hugoprigent/FieldMind/hardware/electronics/carte_capteurs/README.en.md

[Français](README.md) · **English**

# FieldMind Sensor Board

The public edition retains revision **A7**, designed on a pad board 40 × 60 mm. Previous revisions remain in the private workspace.

- [KiCad Project A7](cad/perfboard_c5_a7/README.en.md)
- [Build Guide](perfboard_une_plaque_c5_a7.en.md)
- [Recorded Connections](../CONNEXIONS.en.md)
- [ESP / Pi Contract](contrat_esp_pi.en.md)
- [Power and Shutdown](alimentation_arret.en.md)

The pinout has evolved since the A7 study. To wire the current rover, refer to the recorded connections and firmware; do not order a PCB based on the layers of this perfboard study.
