hugoprigent/FieldMind/hardware/electronics/carte_capteurs/README.md

**Français** · [English](README.en.md)

# Carte capteurs FieldMind

L'édition publique conserve la révision **A7**, étudiée sur une plaque à pastilles 40 × 60 mm. Les révisions précédentes restent dans l'espace de travail privé.

- [Projet KiCad A7](cad/perfboard_c5_a7/README.md)
- [Guide de réalisation](perfboard_une_plaque_c5_a7.md)
- [Connexions effectivement relevées](../CONNEXIONS.md)
- [Contrat ESP / Pi](contrat_esp_pi.md)
- [Alimentation et arrêt](alimentation_arret.md)

Le brochage a évolué depuis l'étude A7. Pour câbler le rover courant, les connexions relevées et le firmware font référence ; ne pas commander un PCB à partir des couches de cette étude de perfboard.
