hugoprigent/FieldMind/docs/status-2026-10-23.md

**Français** · [English](status-2026-10-23.en.md)

# État du prototype — 23 octobre 2026

Cette note distingue ce qui a été essayé sur le matériel de ce qui est seulement codé ou simulé.
La publication reste un instantané sélectionné : accès, journaux bruts, configurations privées et
historique du dépôt source n'en font pas partie.

## Rover

- Le rover roule, châssis et électronique visibles ; la coque n'est pas montée.
- Le servo de direction DT996 est hors service. Le rover tourne par le différentiel des roues
  arrière, servo au neutre (`direction.par_l_arriere` dans `config/rover.toml`). Un support SG90 et
  son palonnier sont dessinés ([CAO](../cao/prototype_final/README.md)), sans validation sous charge.
- **Navigation autonome en intérieur, 21 octobre, avec le GX10** : exploration lancée par la
  consigne « explore la pièce », puis trajet autonome aller-retour sur la carte lidar.
- Fonctionnement de l'exploration : le Pi calcule plusieurs prochains points dans l'espace connu,
  le GX10 en choisit un à partir de la carte et des observations, le Pi revalide ce choix, conduit
  et garde la sécurité. Le modèle ne commande pas directement les moteurs.
- Une analyse de scène sur le GX10 a pris environ 6 à 9 s pendant ces essais ; la période visée de
  3 s n'est pas atteinte.
- Mémoire spatiale : un objet doit être revu sur deux analyses visuelles espacées pour être
  confirmé ; le détecteur rapide seul ne confirme pas un repère.

Non validé : mission en extérieur sur l'herbe ([protocole prévu](../software/rover/TEST_TERRAIN_2026-10-22.md)),
taux de faux positifs de la perception, calibration des axes et du biais de la centrale inertielle.

## Remorque porte-drone

La remorque est fabriquée à partir des [pièces imprimables publiées](../cao/prototype_final/remorque/README.md).
Ses deux volets sont commandés par servos depuis l'ESP32-C5 (firmware ROVER_4, sorties D2/D3) ;
le firmware est flashé sur l'ESP du rover. Le logiciel estime l'angle d'attelage par odométrie,
sans capteur, et intègre l'emprise de la remorque dans le superviseur de sécurité.

Non validé : tractage en mission autonome, marche arrière attelée, position réelle des volets (la
commande est temporisée, sans retour de position).

## Drone

Le flux vidéo BLE du drone est reçu sur le Pi et la reconnaissance d'images fonctionne sans vol.
Le niveau de batterie du drone n’est pas encore mesuré de façon fiable : le champ
d'abord lu comme batterie est un identifiant de modèle. Les trames de commande ont été identifiées
par analyse hors ligne de l'application d'origine ; le pilotage réel reste désactivé tant que
neutre, axes, cadence et perte de liaison ne sont pas validés au banc.

**Le vol autonome n'est pas validé.** La mission décollage, tour photo et posé existe seulement en
[simulation](../software/rover/DRONE_MISSION.md).

## GX10

Huit modèles sont servis sur le GB10 du GX10 :

| Rôle | Modèle |
| --- | --- |
| Agent, vision | Qwen3.6-35B-A3B NVFP4 |
| Pointage incarné | RoboBrain 2.5 (4B) |
| Détection | D-FINE |
| Profondeur monoculaire | Depth Anything V2 (métrique) |
| Segmentation | SAM 2.1 |
| Transcription | Qwen3-ASR (1.7B) |
| Synthèse vocale | Qwen3-TTS (0.6B) |
| Empreintes d'images | Qwen3-VL-Embedding (2B) |

État par rôle : [MODELES.md](../software/rover/MODELES.md) ; configuration :
[deploiement/gx10](../software/rover/deploiement/gx10/README.md). Pendant la session ASUS, le GX10
était distant et joint par réseau privé : un déploiement complet hors réseau sur le terrain
n'est pas démontré.

## Simulation publique

<https://hugoprigent.com/fieldmind/> sert le poste web du rover avec un matériel simulé. Le
serveur [`public_demo.py`](../software/rover/fieldmind/public_demo.py) crée un rover simulé par
navigateur et n'initialise aucun pilote matériel. Il utilise le GX10 s'il est joignable, sinon
un autre fournisseur s'il est configuré, sinon fonctionne sans IA. Son déploiement et ses clés
ne sont pas dans ce dépôt. Page du projet : <https://hugoprigent.com/projets/fieldmind>.

## Limites

Une fonction présente dans le code, une simulation réussie ou un appel IA réussi ne valent pas
validation terrain. Les tests du dépôt vérifient les contrats logiciels et la compilation du
firmware ; ils ne couvrent ni la conduite du rover réel, ni le tractage, ni le vol du drone.
Commandes et résultats : [validation.md](validation.md).
