hugoprigent/FieldMind/cao/prototype_final/VISSERIE.md

**Français** · [English](VISSERIE.en.md)

# FieldMind — toute la visserie du prototype final

Mise à jour et recomptage documentaire : **18 octobre 2026**. Quantités
nettes prévues par les plans, **hors marge et hors déduction du stock déjà
possédé** ; ce n'est pas une validation des assemblages physiques.

Rover complet (direction V04, mâts, coque, composants) et remorque porte-drone. Ce document
rassemble les listes de chaque partie :

- [direction V04](../mounts/prototype/direction_v04_servo_traversant/README.md#quincaillerie) ;
- [coque et composants](README.md#visserie) ;
- [remorque](remorque/README.md#visserie-et-achats).

La [liste CSV](VISSERIE.csv) sépare les quantités **rover avec chape** et
**remorque** pour chaque référence, avec les réserves de dimensionnement.
Les anciennes listes de remorque M5/M8/M12 ne s'ajoutent pas à cette
version : l'attelage courant est en **M10×55** et les supports de roue de
la remorque en **M6×16 à tête bombée**. Aucune vis à tête fraisée : pas de
fraisage dans le bois.

| Ensemble | Vis prévues | Inserts M3 |
| --- | ---: | ---: |
| Rover, coque, mâts et chape d'attelage | 126 | 32 |
| Remorque, hors chape déjà comptée sur le rover | 48 | 12 |
| **Total** | **174** | **44** |

Les 174 incluent les **2 vis des webcams au filetage à confirmer** et la
**M3×16 du palonnier dont la longueur doit être contrôlée au montage**.
Les **8 vis moteurs à dimensionner** sont en supplément, hors de ce total.

## Liste par taille : quantités nettes

M3×12 signifie diamètre nominal 3 mm et longueur 12 mm. Les têtes fraisées
sont distinguées des têtes non fraisées ; elles ne sont pas à substituer
sans vérifier l'assemblage. H = tête hexagonale ; CHC = tête cylindrique
à six pans creux.

| Vis | Nombre | Écrous et rondelles |
| --- | ---: | --- |
| M2×4 | 4 | — |
| M2,5×8, tête cylindrique | 4 | 4 rondelles M2,5 |
| M3×6 | 20 | 20 rondelles larges M3 (DIN 9021, Ø9) |
| M3×8 | 32 | 4 écrous M3 (XL4015) ; les autres vissées dans des inserts ou dans le plastique |
| M3×10 | 6 | 6 écrous M3, 6 rondelles M3 (rebords de la remorque) |
| M3×12, tête cylindrique | 16 | 12 écrous M3, 12 rondelles M3 |
| M3×12, tête bombée | 4 | 4 écrous M3, 8 rondelles M3 étroites pour les biellettes |
| M3×16, tête cylindrique | 11 | 10 écrous M3, 10 rondelles M3 (planche de 10 mm) ; 1 rondelle large M3 (palonnier) |
| **M3×16, tête bombée (ISO 7380)** | **14** | 14 écrous M3 |
| M3×20 | 2 | 2 écrous frein M3, 4 rondelles M3 |
| CHC M5×40 | 2 | 2 écrous frein M5, 2 rondelles M5 |
| **M6×16, tête bombée (ISO 7380)** | **8** | 8 écrous M6 |
| **M6×25, tête bombée (ISO 7380)** | **4** | 4 écrous M6 (timon de la remorque) |
| M6×20 | 10 | 10 écrous M6, 10 rondelles M6 (coque ; 4 suffisent) |
| M6×25 | 6 | 6 écrous M6 (colliers des supports moteurs, chape), 2 rondelles M6 |
| M8×16 | 8 | 8 écrous en T M8 pour rainure de 10 |
| H M8×25 | 8 | 8 écrous M8, 8 rondelles M8 (supports de pivot, équerres) |
| H M8×30 | 12 | 12 écrous M8, 16 rondelles M8 (supports moteurs) ; rondelles de 2 mm imprimées (pivots, axes) |
| H M10×55 | 1 | 1 écrou frein M10, 2 rondelles M10 |
| Vis photo 1/4"-20 × 1/2", à confirmer | 2 | — ; M6×12 est une autre hypothèse, pas une référence à ajouter |

## Écrous, rondelles et inserts

Ces quantités sont celles du montage. Ajouter séparément une marge si
souhaité ; aucune marge n'est déjà comprise dans les totaux.

| Quoi | Nombre |
| --- | ---: |
| Vis, toutes tailles | 174 |
| Rondelles M2,5 | 4 |
| Écrous M3 | 50 |
| Écrous frein M3 | 2 |
| Rondelles M3 standard | 32 |
| Rondelles M3 étroites, appui sur bague intérieure des 3×10×4 | 8, ou 8 rondelles imprimées à leur place |
| Rondelles larges M3 (DIN 9021, Ø9) | 21 |
| Inserts à chaud M3 (Ø ext. 4,5 à 4,6 mm, longueur 5,7 mm au plus selon les logements) | 44 |
| Écrous frein M5 + rondelles M5 | 2 + 2 |
| Écrous M6 + rondelles M6 | 28 + 12 |
| Écrou frein M10 + rondelles M10 | 1 + 2 |
| Écrous M8 | 20 |
| Rondelles M8 | 24 |
| Écrous en T M8, rainure de 10 | 8 |

Les **46 rondelles M3 hors larges** se décomposent en 38 standard et
8 étroites. Pour les biellettes, le plan propose des rondelles imprimées
**Ø extérieur 5 mm, Ø intérieur 3,3 mm, épaisseur 0,6 mm** ; une pièce métal
doit respecter l'appui sur la seule bague intérieure. Ne pas commander
8 rondelles supplémentaires si les 8 imprimées sont utilisées.

Les rondelles/entretoises des pivots et des moyeux prévues imprimées dans
les plans restent des pièces à fabriquer, pas des rondelles métalliques
à ajouter à ces quantités.

Les inserts restent seulement là où du plastique se visse dans du plastique : bossages des bandes
de la coque et flasques des pneus. Partout où une pièce imprimée se fixe sur du bois, c'est vis et
écrou.

## Dimensions à confirmer avant achat définitif

- **Fixation des moteurs arrière : 8 vis prévues**, 4 par moteur d'après
  les supports. Les moteurs sont désormais identifiés NGP RM24A/RM18A,
  mais les taraudages, leur profondeur et la fixation réelle sur ces
  supports restent à relever. Les trous Ø4 des supports ne permettent
  pas de choisir M3 ou M4. Ces 8 vis ne sont pas comptées dans les 174.
- **Webcams : 2 vis**, filetage et longueur engagée à confirmer. Le plan
  retient 1/4"-20 × 1/2" ; M6×12 ne convient que si le taraudage est
  réellement M6. Ce sont deux possibilités exclusives.
- **Palonnier du DT996 : 1 vis M3×16 prévue**, diamètre M3 confirmé dans
  le compte rendu V04. Vérifier sa longueur avec l'étoile complètement
  emboîtée : la vis doit serrer l'empilage sans buter au fond de l'axe.
- **Lidar C1 : M2,5×8**, avec au maximum 4 mm de pénétration dans le lidar
  selon le plan constructeur archivé et le support actuel.

Le Pi dans son boîtier, les convertisseurs et les contrôleurs sont posés
à l'adhésif/double-face dans la version actuelle de la coque : aucune
visserie supplémentaire de platine ou d'entretoises n'est définie pour
eux. La carte A7, l'écran et le Knob sont bien inclus dans le tableau.

**Visserie d'origine à réutiliser et à vérifier dans les sachets** :
- vis des oreilles et du palonnier des 2 SG90 de la remorque ;
- vis d'origine du servo de direction : celle de l'étoile est remplacée par la M3×16.

## Détail, partie par partie

### Direction avant V04, mâts et supports

| Vis | Nombre | Où |
| --- | ---: | --- |
| H M8×30 + écrou M8 | 2 | Pivots : vis par-dessous, écrou prisonnier dans le support (frein-filet) |
| H M8×30 + écrou M8 | 2 | Axes des roues avant : écrou prisonnier dans la jambe de la fusée (frein-filet) |
| H M8×25 + écrou + rondelle M8 | 4 | Supports de pivot à travers la planche de 10 mm |
| H M8×30 + écrou + 2 rondelles M8 | 8 | Supports des moteurs arrière, 4 par support, à travers la planche de 10 mm |
| M6×25 + écrou M6 | 4 | Colliers des supports moteurs, 2 par support (écrou dans la quille) |
| H M8×25 + écrou + rondelle M8 | 4 | Équerres des deux mâts sur la planche |
| M8×16 + écrou en T M8 | 8 | 4 pour les équerres sur les profilés, 2 pour la barre stéréo, 2 pour le support du lidar (emboîté sur le profilé de 90) |
| M3×8 + insert M3 | 12 | Flasques des pneus avant, 6 par roue |
| M3×12 tête bombée + 2 rondelles étroites + écrou M3 | 4 | Biellettes de direction |
| M3×16 + écrou + rondelle M3 | 4 | Oreilles du servo de direction, à travers la planche |
| M3×16 + rondelle large M3 | 1 | Vis centrale du palonnier, dans l'axe du servo (frein-filet bleu) |
| M2,5×8 + rondelle | 4 | Lidar C1 sur son support |
| Vis photo 1/4"-20 × 1/2" | 2 | Webcams sur la barre stéréo (M6×12 si le filetage est bien M6) |

### Coque et composants

| Vis | Nombre | Où |
| --- | ---: | --- |
| M3×6 + rondelle large DIN 9021 | 20 | Bandes bleues sur les rebords des flancs, dans 20 inserts M3 |
| M3×12 + écrou + rondelle M3 | 12 | Nervures entre tronçons, 2 par flanc et par coupe |
| M6×20 + rondelle M6 | 10 | Coque sur la planche, par-dessous, dans les écrous M6 glissés dans les fentes (4 aux coins suffisent) |
| M3×16 + rondelle M3, écrou M3 noyé dans le fond du berceau | 4 | Berceau de la batterie (avant gauche), vis par-dessous la planche |
| M3×8 | 4 | Carte A7 sous la bande C3, directement dans le plastique |
| M3×12 | 4 | Modulino Knob sous la bande C3, directement dans le plastique |
| M3×8 + écrou M3 | 4 | Les deux XL4015 sur leur plaque imprimée : vis par le dessus, écrou dans la poche sous la plaque |
| M3×16 + rondelle + écrou M3 | 2 | Plaque des XL4015 sur la planche, à l'avant droit (trous X1 et X2), ou double-face |
| M2×4 | 4 | Écran sous la bande C3, directement dans le plastique |

### Attelage, côté rover

| Vis | Nombre | Où |
| --- | ---: | --- |
| M6×25 + rondelle + écrou M6 | 2 | Chape sous la planche du rover (trous A1 et A2), écrous dans la chape |
| H M10×55 + 2 rondelles + écrou frein M10 | 1 | Vis d'attelage par le dessus, à travers les deux mâchoires et la tête du timon, écrou sous la chape |

### Remorque

| Vis | Nombre | Où |
| --- | ---: | --- |
| M6×16 tête bombée + écrou M6 | 8 | Supports de roue, 4 par support (2 près du bord, 2 vers le milieu), par le dessus, écrou noyé |
| M3×16 tête bombée + écrou M3 | 14 | Par le dessus, écrou noyé : boîtiers des servos (4), blocs arrière (2), ferrures des volets (8) |
| M6×25 tête bombée + écrou M6 | 4 | Timon : par le dessus, à travers la planche, écrou noyé sous le timon |
| M3×10 + rondelle | 6 | Rebords avant et arrière, par-dessous, dans les écrous noyés de la lèvre |
| Écrou M3 | 12 | Noyés dans la lèvre des rebords (pour les 6 M3×30 et les 6 M3×10) |
| M3×20 + 2 rondelles + écrou frein M3 | 2 | Axe arrière de chaque volet |
| M3×8 + insert M3 | 12 | Flasques des pneus de la remorque, 6 par roue, comme à l'avant |
| CHC M5×40 + rondelle + écrou frein M5 | 2 | Axe de chaque roue de la remorque |
