hugoprigent/FieldMind/hardware/electronics/carte_capteurs/exports/c5_a7/plan_broches.html

## Broches par composant (trou vu du dessus)

Réf. | Composant | Face | Broches
J3 | OLED 0,96 I2C | dessus | GND F1 · VCC G1 · SCL H1 · SDA I1
J1 | GY-521 MPU-6050 | dessus | VCC B20 · GND C20 · SCL D20 · SDA E20 · XDA F20 (non câblé) · XCL G20 (non câblé) · AD0 H20 (non câblé) · INT I20 (non câblé)
J2 | GY-BMP280-3.3 | dessus | VCC N18 · GND N17 · SCL N16 · SDA N15 · CSB N14 (non câblé) · SDO N13 (non câblé)
U1 | Seeed XIAO ESP32C5 | dessous | D0 J2 · D1 J3 · D2 J4 · D3 J5 · D4 J6 · D5 J7 · D6 J8 · D7 D8 · D8 D7 · D9 D6 · D10 D5 · 3V3 D4 · GND D3 · 5V D2
J4 | GNSS déporté (câble) | dessus | RX_GPS A12 · GND A11 · VCC A10 · TX_GPS A9
J6 | Extension 5V/3V3/D8-D10 (Dupont) | dessus | 5V A2 · GND A3 · 3V3 A4 · D10 A5 · D9 A6 · D8 A7
J8 | Extension D0-D3 (Dupont) | dessus | D0 N2 · D1 N3 · D2 N4 · D3 N5
J7 | Modulino Knob (I2C, câble) | dessus | GND N7 · 3V3 N8 · SDA N9 · SCL N10
