hugoprigent/FieldMind/cao/prototype_final/exports/support_xl4015_gabarit.pdf

## Support des 2 XL4015 — gabarit à l'échelle 1

Imprimer à 100 % et vérifier la règle de 50 mm. Poser chaque module sur son contour, IN en bas. Ses deux trous doivent tomber sur les croix. Sinon, mesurer A et B (voir en bas) et me les donner.

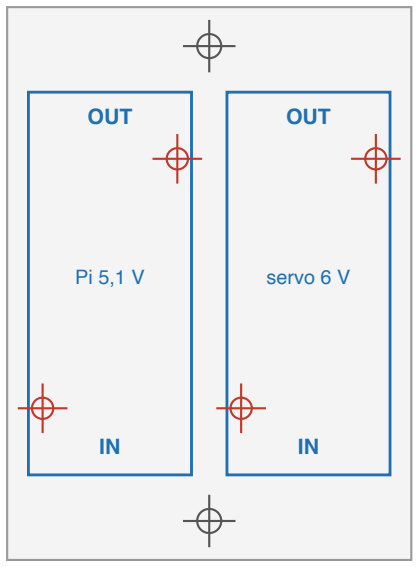
[picture p52: figure]
OUT; servo 6 V

Circuit 23 × 54 mm, 2 trous Ø3 en diagonale :

- trou côté IN : 2 mm du bord gauche, 9,4 mm du bout IN ;
- trou côté OUT : 2 mm du bord droit, 9,4 mm du bout OUT ;
- A = entraxe en longueur : 35,2 mm ; B = entraxe en largeur : 19 mm.
Écart entre les deux circuits : 5 mm. Plots de 3,6 mm ; vis M3×8 par le dessus, écrou M3 dans la poche sous la plaque.

Croix grises : fixation de la plaque sur la planche (vis M3×12 + rondelle + écrou, foret 4 dans la planche).

règle de contrôle : 50 mm
