hugoprigent/FieldMind/cao/prototype_final/plan_percages/plan_percages.pdf

## FieldMind prototype final — perçage de la planche 300 × 500 × 10 mm

Vue de dessus, avant en haut, échelle 1:2,5. Coordonnées en page 2 ; gabarit à l'échelle 1 en pages 3 à 6.
AVANT
P1 | P2 | P3 | P4
M1 | M2 | M3 | M4
M5 | M6 | M7 | M8
S1 | S2
S3 | S4
E1 | E2
E3 | E4
K1 | K2
K3 | K4
K5 | K6
K7 | K8
K9 | K10
B1 | B2
B3 | B4

X1

X2

A1 | C1 | A2

300 mm

500 mm

Profilé 40×40 du lidar

Profilé 40×40 des caméras

Découpe servo 21 × 41,4

P : Ø8,5 — Supports de pivot
M : Ø8,5 — Supports moteurs arrière (4 par support)
S : Ø3,4 — Oreilles du servo (à pointer avec le servo)
E : Ø8,5 — Équerres des profilés (caméras à l'avant, lidar à l'arrière)

K : Ø6,5 — Fixation de la coque (M6)
B : Ø3,5 — Berceau de batterie (avant gauche)
X : Ø3,5 — Plaque des deux XL4015 (avant droit)
C : Ø8 — Passage des câbles des volets de la remorque A : Ø6,5 — Chape d'attelage de la remorque Pointillés : profilés et contour extérieur de la coque

## Coordonnées des trous (mm) — planche vue de dessus, avant en haut

X depuis le bord GAUCHE ; Y depuis le bord AVANT ; X axe = depuis l'axe de la planche (+ à droite).

Trou | Ø | X gauche | Y avant | X axe | Rôle
P1 | 8,5 | 26,0 | 56,0 | -124,0 | Supports de pivot
P2 | 8,5 | 55,0 | 56,0 | -95,0 | Supports de pivot
P3 | 8,5 | 245,0 | 56,0 | +95,0 | Supports de pivot
P4 | 8,5 | 274,0 | 56,0 | +124,0 | Supports de pivot
M1 | 8,5 | 20,0 | 395,0 | -130,0 | Supports moteurs arrière (4 par support)
M2 | 8,5 | 82,0 | 395,0 | -68,0 | Supports moteurs arrière (4 par support)
M3 | 8,5 | 218,0 | 395,0 | +68,0 | Supports moteurs arrière (4 par support)
M4 | 8,5 | 280,0 | 395,0 | +130,0 | Supports moteurs arrière (4 par support)
M5 | 8,5 | 20,0 | 485,0 | -130,0 | Supports moteurs arrière (4 par support)
M6 | 8,5 | 82,0 | 485,0 | -68,0 | Supports moteurs arrière (4 par support)
M7 | 8,5 | 218,0 | 485,0 | +68,0 | Supports moteurs arrière (4 par support)
M8 | 8,5 | 280,0 | 485,0 | +130,0 | Supports moteurs arrière (4 par support)
S1 | 3,4 | 145,0 | 103,5 | -5,0 | Oreilles du servo (à pointer avec le servo)
S2 | 3,4 | 155,0 | 103,5 | +5,0 | Oreilles du servo (à pointer avec le servo)
S3 | 3,4 | 145,0 | 151,5 | -5,0 | Oreilles du servo (à pointer avec le servo)
S4 | 3,4 | 155,0 | 151,5 | +5,0 | Oreilles du servo (à pointer avec le servo)
E1 | 8,5 | 110,0 | 25,0 | -40,0 | Équerres des profilés (caméras à l'avant, lidar à l'arrière)
E2 | 8,5 | 190,0 | 25,0 | +40,0 | Équerres des profilés (caméras à l'avant, lidar à l'arrière)
E3 | 8,5 | 110,0 | 440,0 | -40,0 | Équerres des profilés (caméras à l'avant, lidar à l'arrière)
E4 | 8,5 | 190,0 | 440,0 | +40,0 | Équerres des profilés (caméras à l'avant, lidar à l'arrière)
K1 | 6,5 | 75,0 | 7,4 | -75,0 | Fixation de la coque (M6)
K2 | 6,5 | 225,0 | 7,4 | +75,0 | Fixation de la coque (M6)
K3 | 6,5 | 10,4 | 20,0 | -139,6 | Fixation de la coque (M6)
K4 | 6,5 | 289,6 | 20,0 | +139,6 | Fixation de la coque (M6)
K5 | 6,5 | 10,4 | 160,0 | -139,6 | Fixation de la coque (M6)
K6 | 6,5 | 289,6 | 160,0 | +139,6 | Fixation de la coque (M6)
K7 | 6,5 | 10,4 | 290,0 | -139,6 | Fixation de la coque (M6)
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
