hugoprigent/FieldMind/cao/mounts/prototype/direction_v04_servo_traversant/vues/01_iso_neutre.png

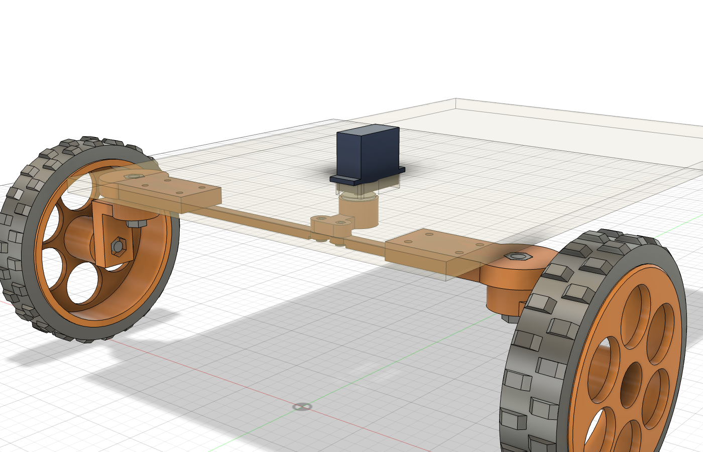
cao/mounts/prototype/direction_v04_servo_traversant/vues/01_iso_neutre.png
