hugoprigent/FieldMind/cao/mounts/prototype/direction_v04_servo_traversant/vues/05_module_droit.png

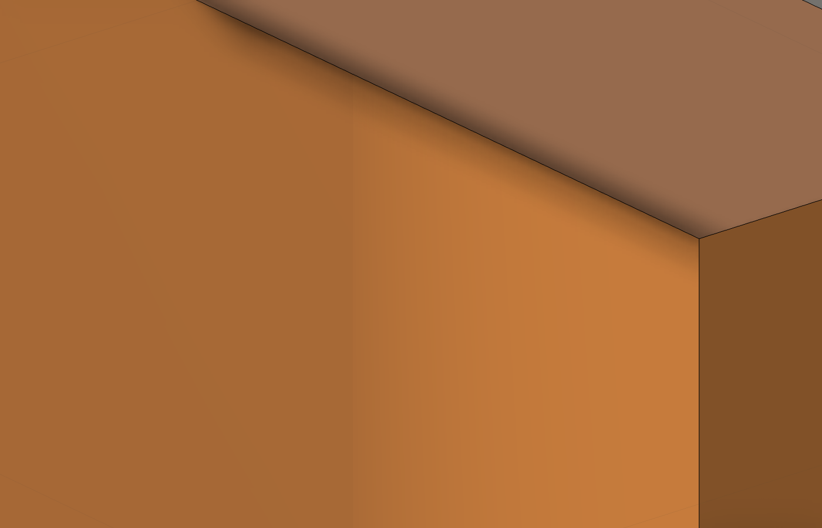
cao/mounts/prototype/direction_v04_servo_traversant/vues/05_module_droit.png
