hugoprigent/FieldMind/cao/mounts/prototype/direction_v04_servo_traversant/vues/07_face_roues.png

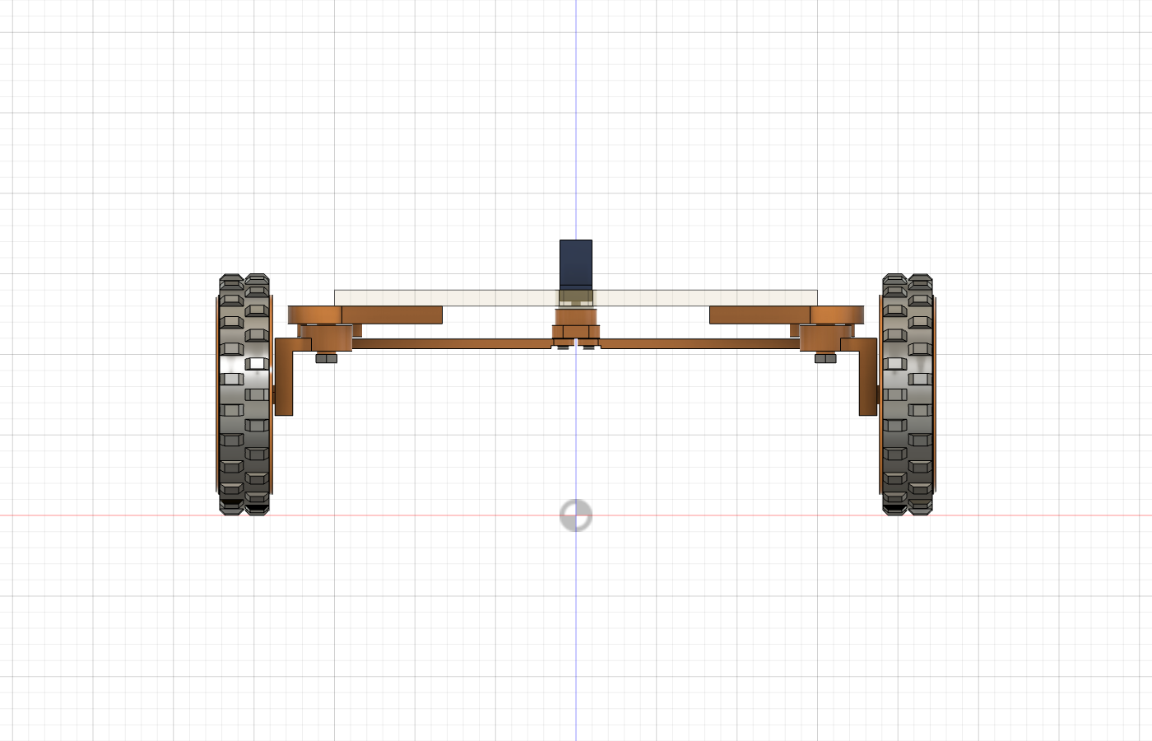
cao/mounts/prototype/direction_v04_servo_traversant/vues/07_face_roues.png
