hugoprigent/FieldMind/cao/mounts/prototype/direction_v04_servo_traversant/vues/08_roue_droite.png

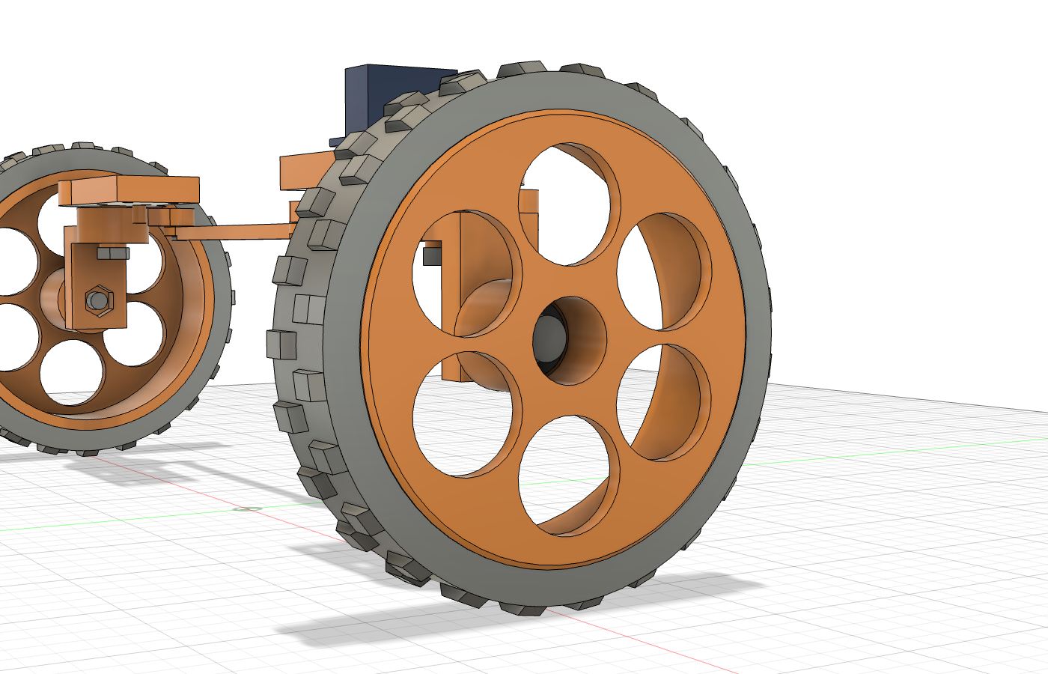
cao/mounts/prototype/direction_v04_servo_traversant/vues/08_roue_droite.png
