hugoprigent/FieldMind/cao/mounts/prototype/direction_v04_servo_traversant/vues/14_support_lidar_dessous.png

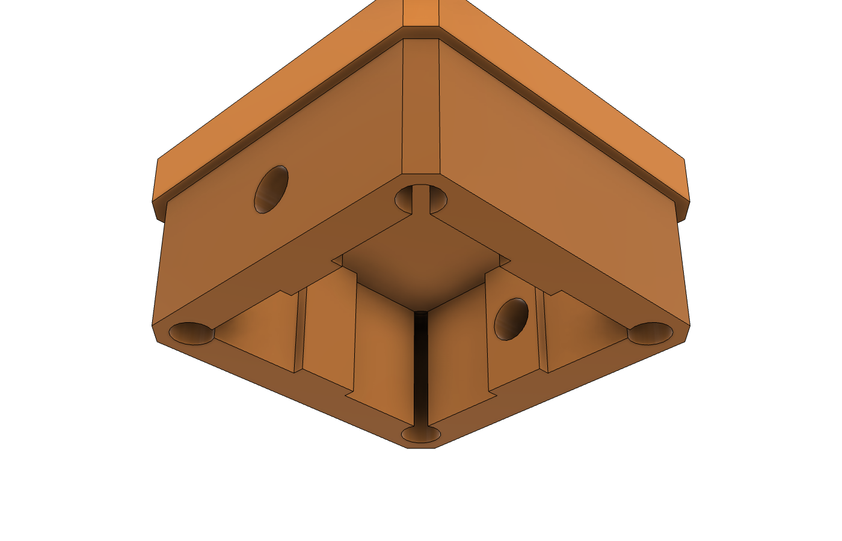
cao/mounts/prototype/direction_v04_servo_traversant/vues/14_support_lidar_dessous.png
