hugoprigent/FieldMind/cao/prototype_final/exports/support_xl4015_gabarit.png

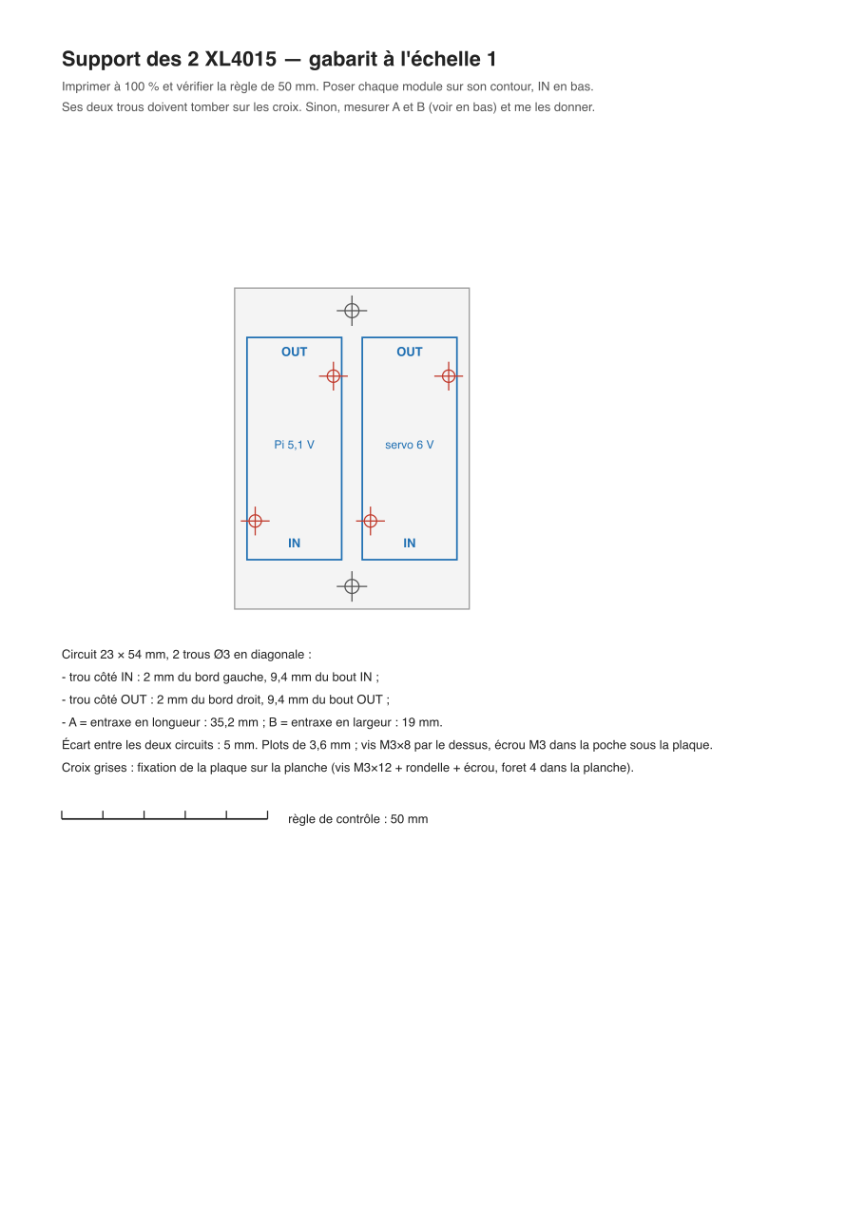
cao/prototype_final/exports/support_xl4015_gabarit.png
