hugoprigent/FieldMind/cao/prototype_final/plans_atelier/page_1_remorque_decoupe.png

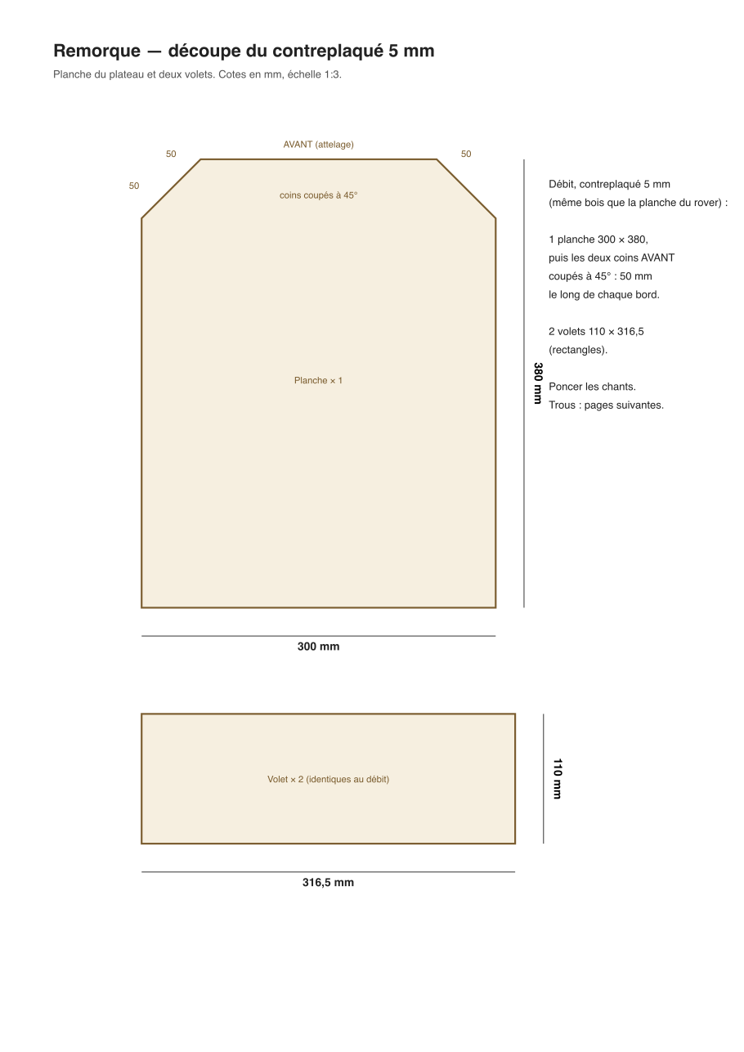
cao/prototype_final/plans_atelier/page_1_remorque_decoupe.png
