hugoprigent/FieldMind/cao/prototype_final/plans_atelier/page_2_remorque_percage.png

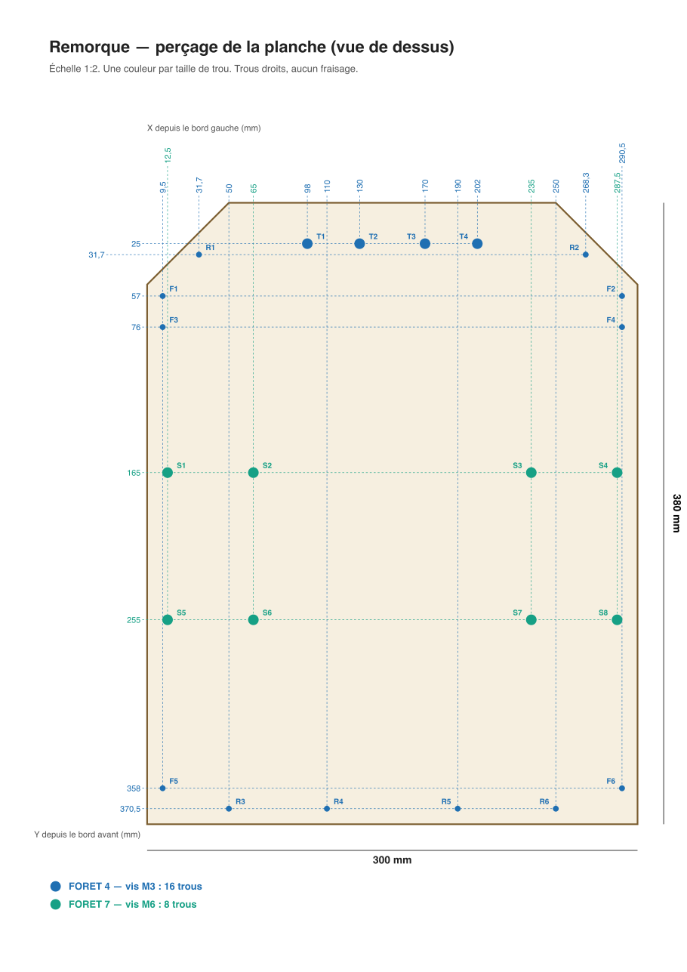
cao/prototype_final/plans_atelier/page_2_remorque_percage.png
