hugoprigent/FieldMind/cao/prototype_final/plans_atelier/page_3_remorque_tableau.png

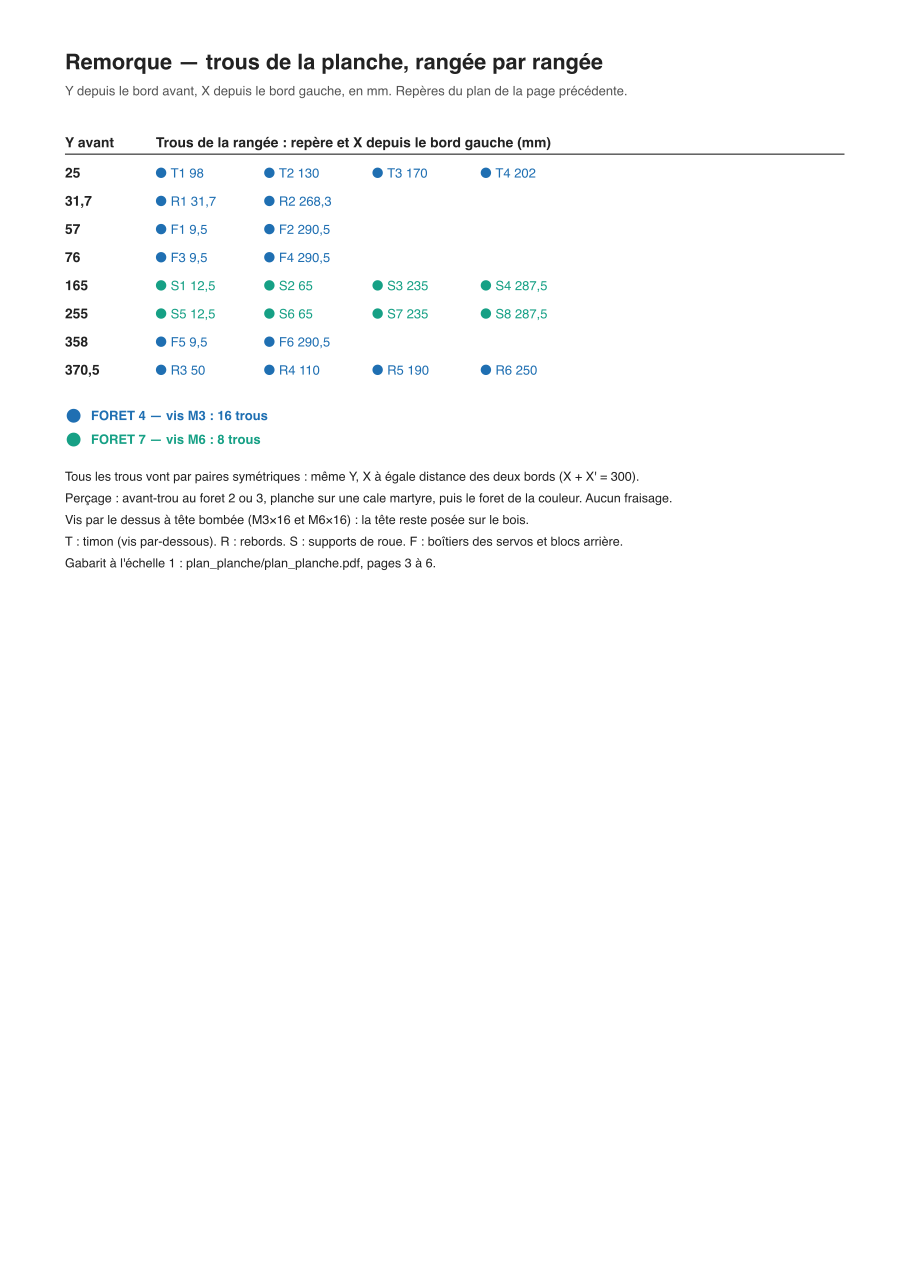
cao/prototype_final/plans_atelier/page_3_remorque_tableau.png
