hugoprigent/FieldMind/cao/prototype_final/plans_atelier/page_4_volets_percage.png

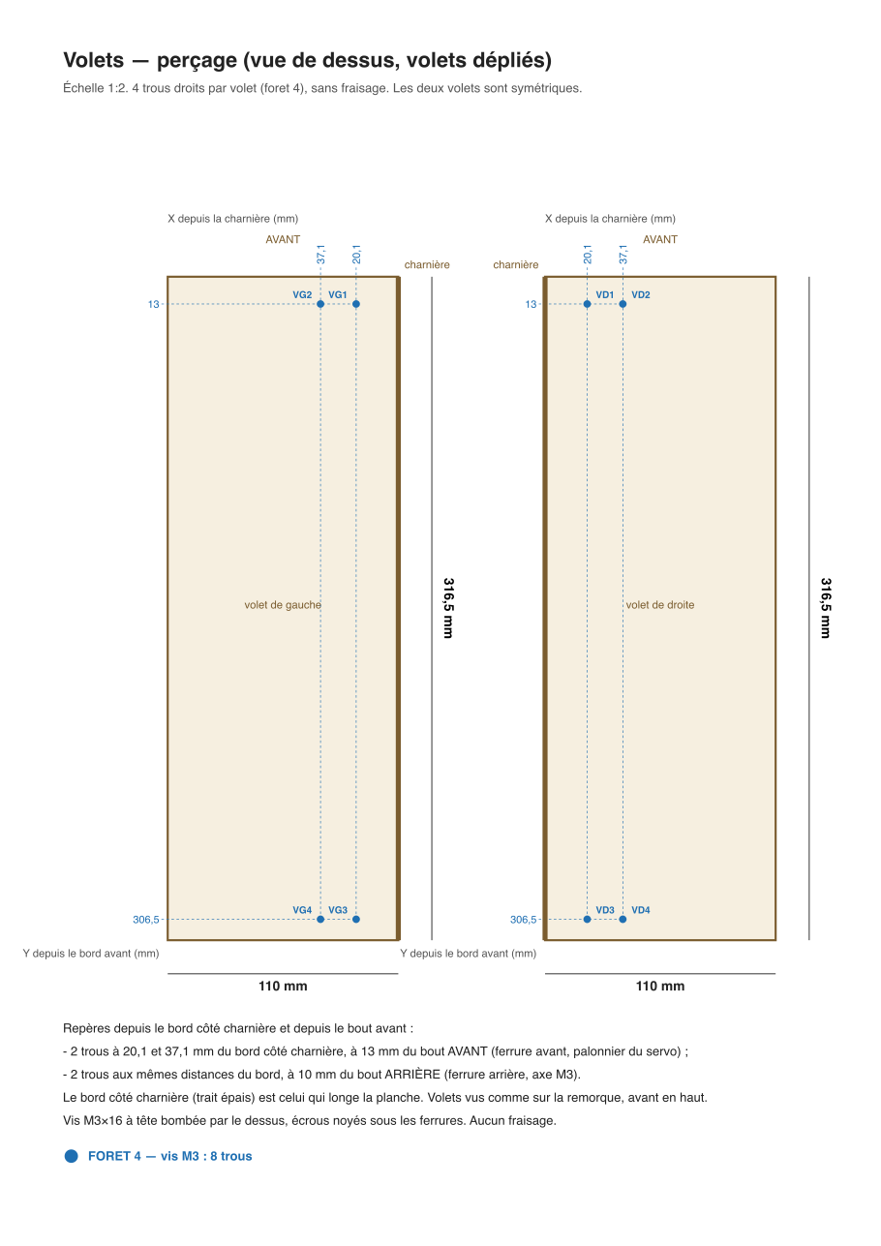
cao/prototype_final/plans_atelier/page_4_volets_percage.png
