hugoprigent/FieldMind/cao/prototype_final/plans_atelier/page_5_rover_percage.png

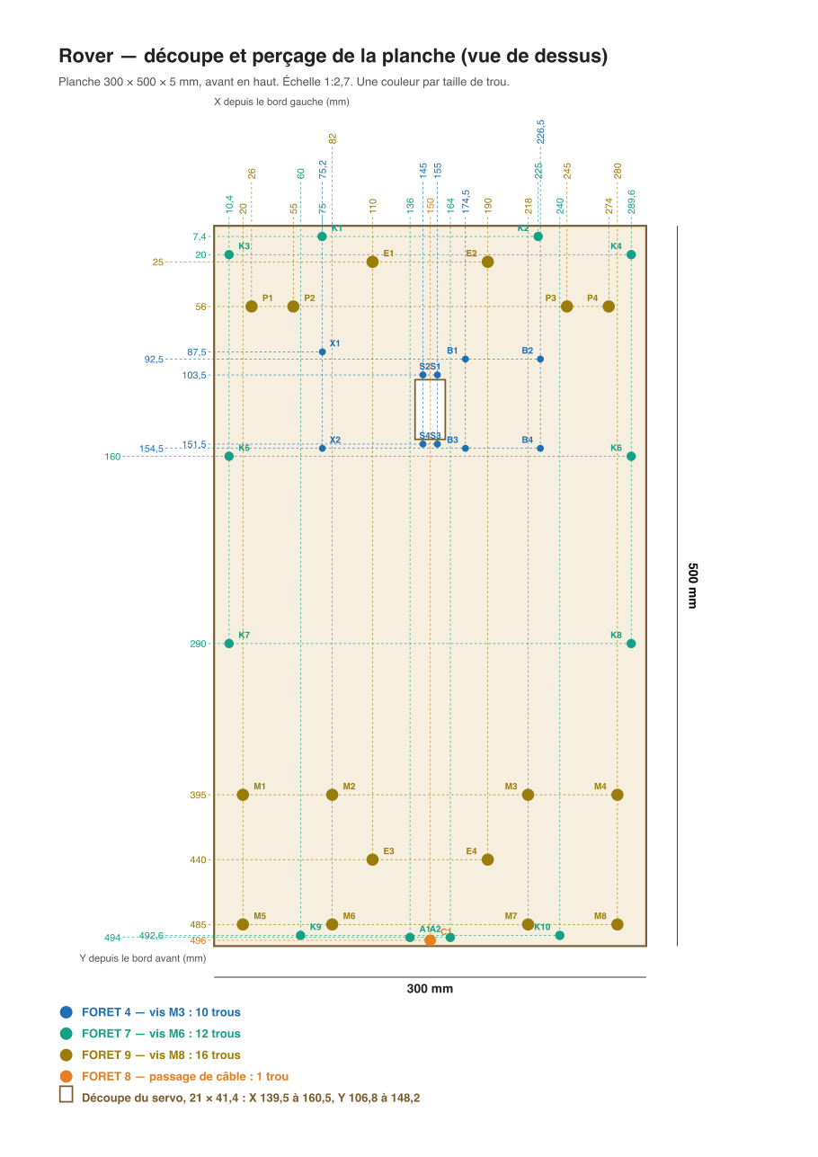
cao/prototype_final/plans_atelier/page_5_rover_percage.png
