hugoprigent/FieldMind/cao/prototype_final/plans_atelier/page_6_rover_tableau.png

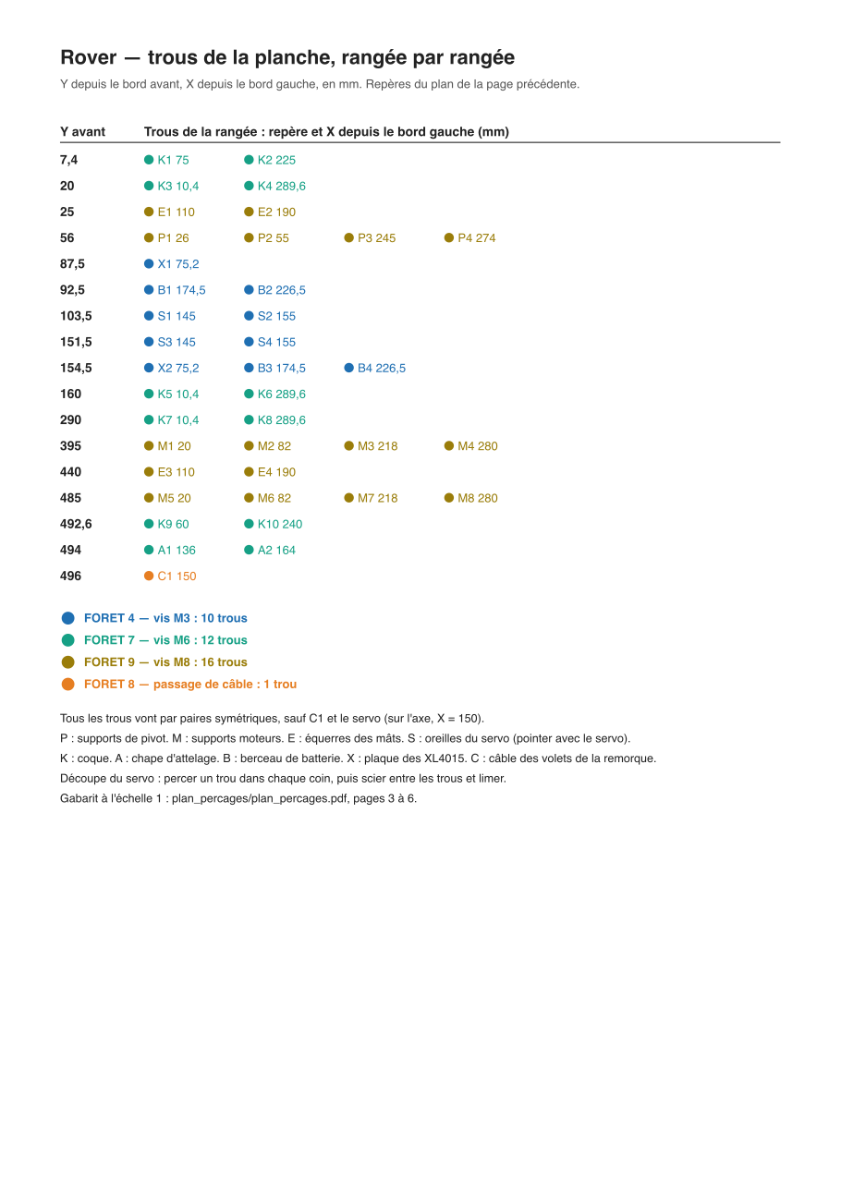
cao/prototype_final/plans_atelier/page_6_rover_tableau.png
