hugoprigent/FieldMind/cao/prototype_final/vues/09_mat_lidar_rehausse.png

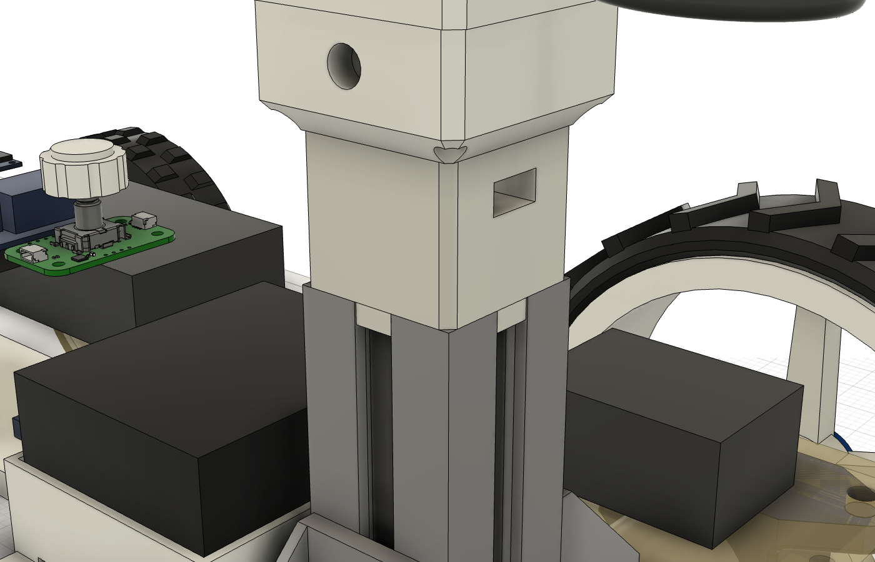
cao/prototype_final/vues/09_mat_lidar_rehausse.png
