hugoprigent/FieldMind/hardware/electronics/carte_capteurs/exports/c5_a7/plan_broches.png

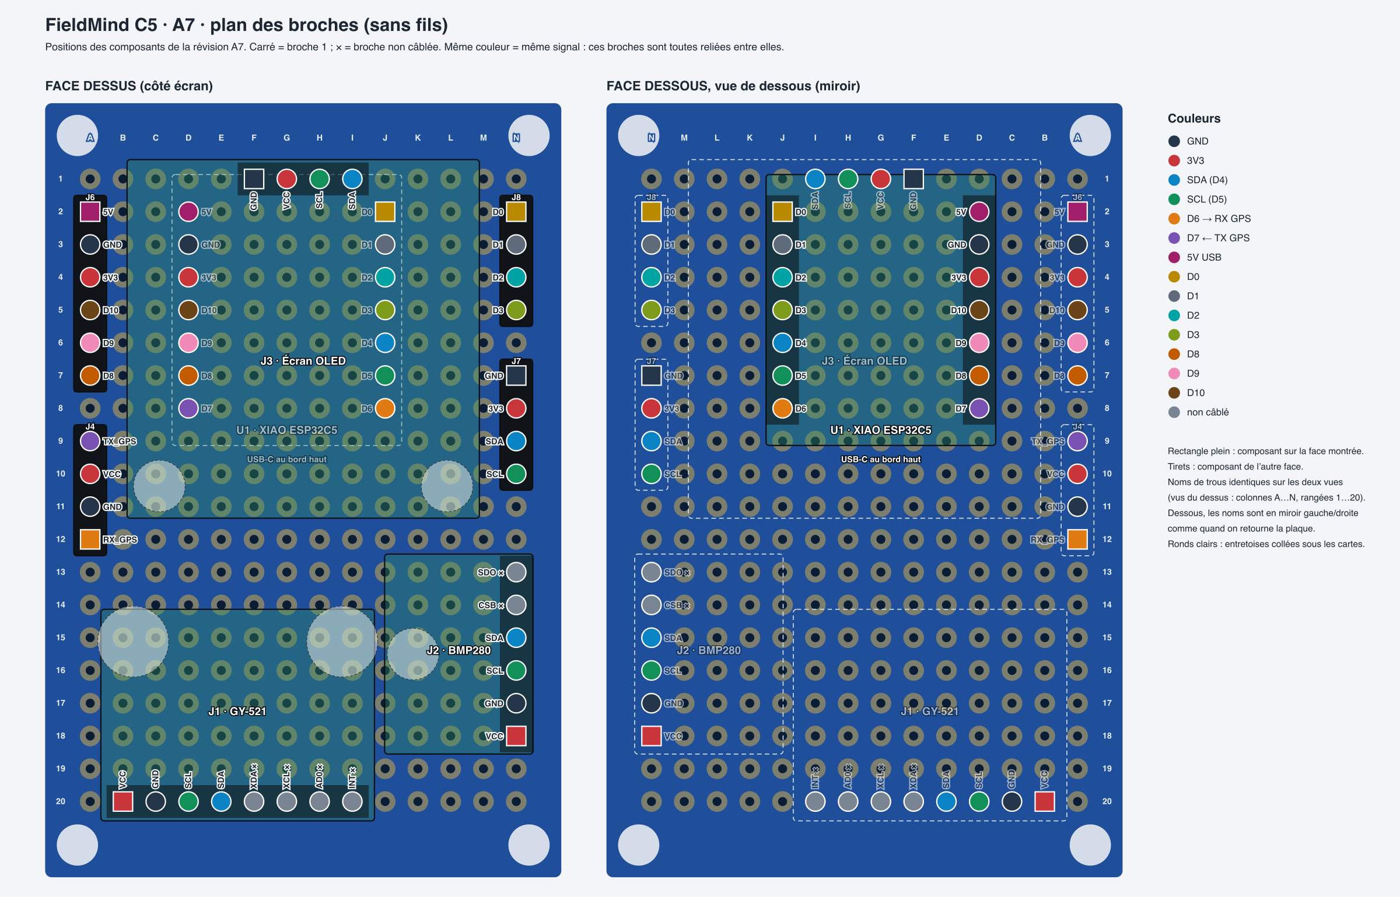
hardware/electronics/carte_capteurs/exports/c5_a7/plan_broches.png
