hugoprigent/FieldMind/hardware/electronics/carte_capteurs/exports/c5_a7/rendu_3d_dessous_iso.png

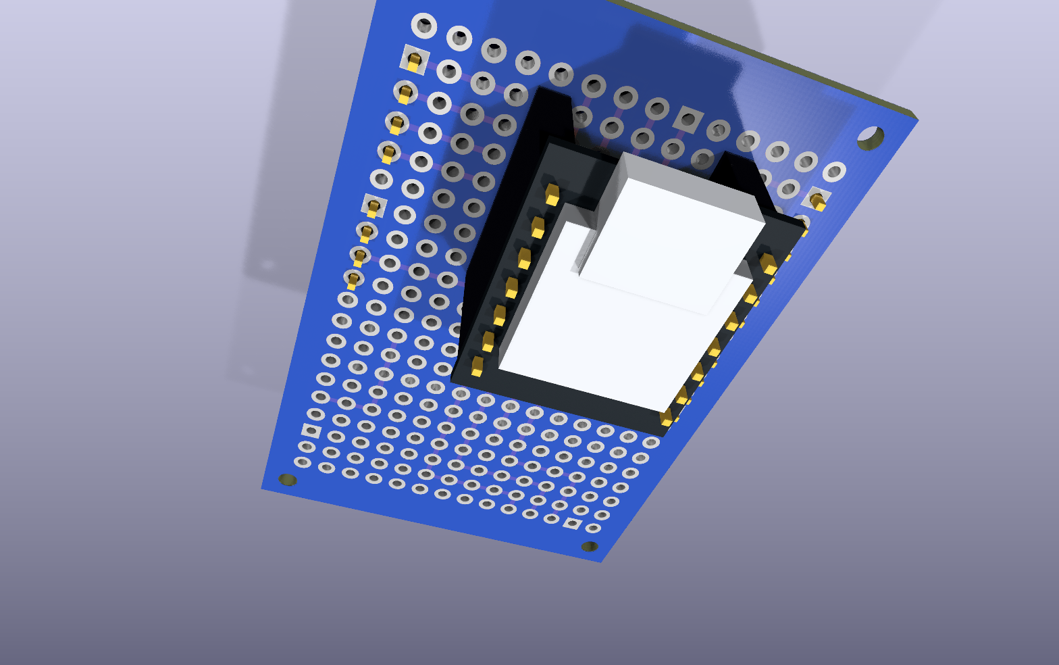
hardware/electronics/carte_capteurs/exports/c5_a7/rendu_3d_dessous_iso.png
