hugoprigent/FieldMind/hardware/electronics/carte_capteurs/exports/c5_a7/rendu_3d_dessus_iso.png

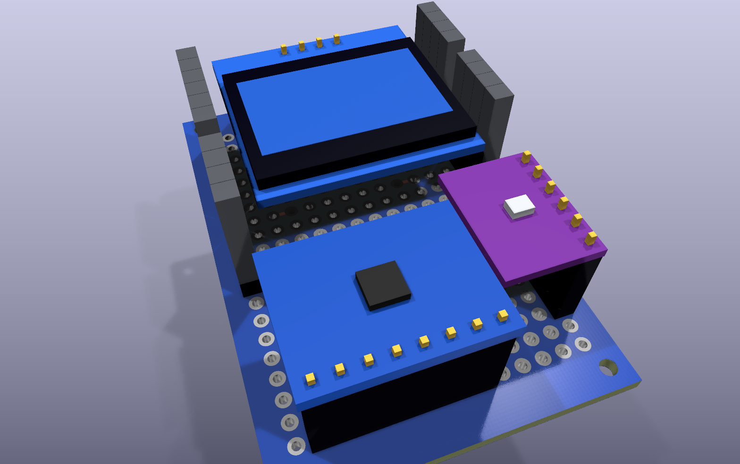
hardware/electronics/carte_capteurs/exports/c5_a7/rendu_3d_dessus_iso.png
