hugoprigent/FieldMind/hardware/electronics/systeme_rover/exports/nomenclature.csv

Refs | Value | Footprint | Qty | DNP
A1 | Carte capteurs A7 (XIAO ESP32C5 + OLED + GY-521 + BMP280) |  | 1
BT1 | Batterie du E600 (≤ 36 V chargée) |  | 1
F0 | Fusible principal DC |  | 1
F1 | Fusible branche Pi |  | 1
F2 | Fusible branche servo |  | 1
F3 | Fusible traction |  | 1
F4 | Fusible commande |  | 1
K1 | Relais commande 12 V |  | 1
K2 | Contacteur DC traction |  | 1
M1 | Moteur roue gauche (E600) |  | 1
M2 | Moteur roue droite (E600) |  | 1
M3 | Servo direction Heemol DT996 |  | 1
P1 | Fiche USB-C (câble alimentation Pi) |  | 1
S1 | Interrupteur général DC |  | 1
S2 | Arrêt d’urgence (NF, verrouillable) |  | 1
S3 | Réarmement (NO) |  | 1
U1 | Raspberry Pi 4 Model B |  | 1
U2 | XL4015 n°1 réglé à 5,1 V |  | 1
U3 | XL4015 n°2 réglé à 6,0 V |  | 1
U4 | XL4015 n°3 réglé à 12 V |  | 1
U5 | Contrôleur de traction du E600 (à identifier) |  | 1
U6 | Webcam UGREEN 1080p (gauche) |  | 1
U7 | Webcam UGREEN 1080p (droite) |  | 1
U8 | Adaptateur USB du kit C1 |  | 1
U9 | Slamtec RPLIDAR C1 |  | 1
U10 | GPS ATGM336H (AYWHP) + antenne |  | 1
U11 | Arduino Modulino Knob (I2C 0x3A) |  | 1
