hugoprigent/FieldMind/cao/mounts/prototype/direction_v04_servo_traversant/exports/stl/flasque_pneu.stl

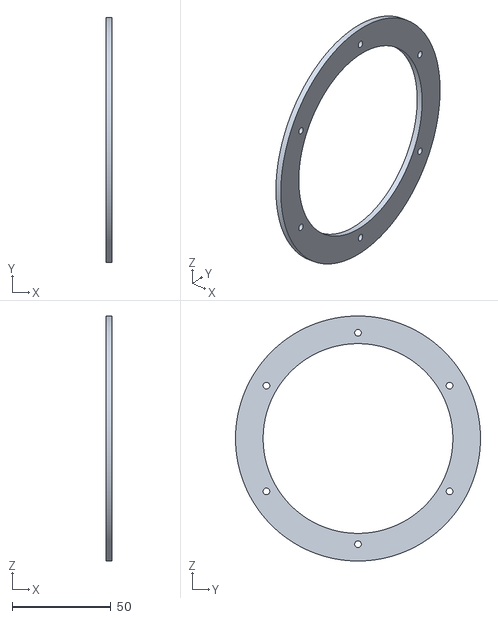
[picture p71: CAD file, 2026-10-20]
cao/mounts/prototype/direction_v04_servo_traversant/exports/stl/flasque_pneu.stl
3.00 x 124.0 x 124.0
