hugoprigent/FieldMind/cao/prototype_final/exports/stl/palonnier_sg90.stl

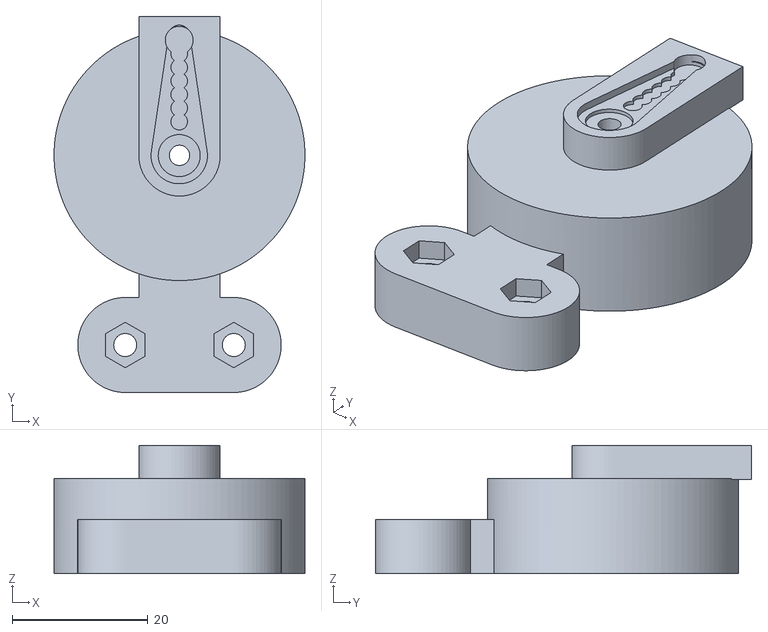
[picture p72: CAD file, 2026-10-23]
cao/prototype_final/exports/stl/palonnier_sg90.stl
37.0 x 55.4 x 18.9
