hugoprigent/FieldMind/cao/prototype_final/remorque/exports/stl/ferrure_AV_G.stl

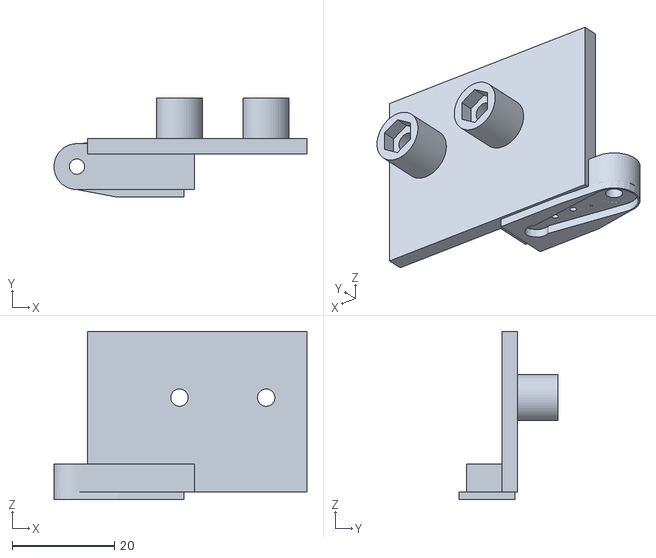
[picture p73: CAD file, 2026-10-23]
cao/prototype_final/remorque/exports/stl/ferrure_AV_G.stl
49.6 x 19.5 x 33.0
