hugoprigent/FieldMind/cao/mounts/prototype/direction_v04_servo_traversant/exports/stl/rondelle_precharge_1.9mm.stl

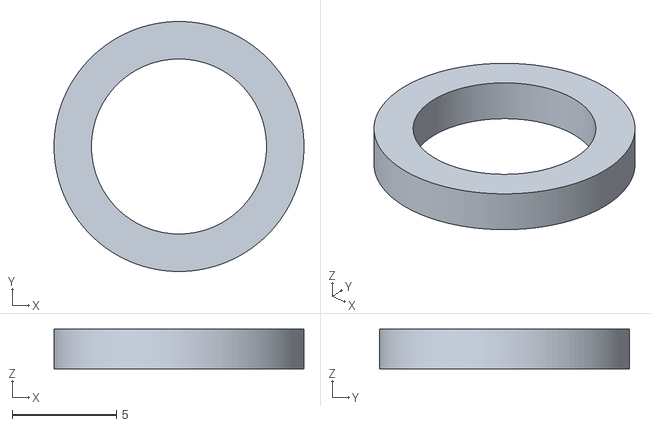
[picture p74: CAD file, 2026-10-20]
cao/mounts/prototype/direction_v04_servo_traversant/exports/stl/rondelle_precharge_1.9mm.stl
12.0 x 12.0 x 1.90
