hugoprigent/FieldMind/cao/prototype_final/exports/stl/support_sg90.stl

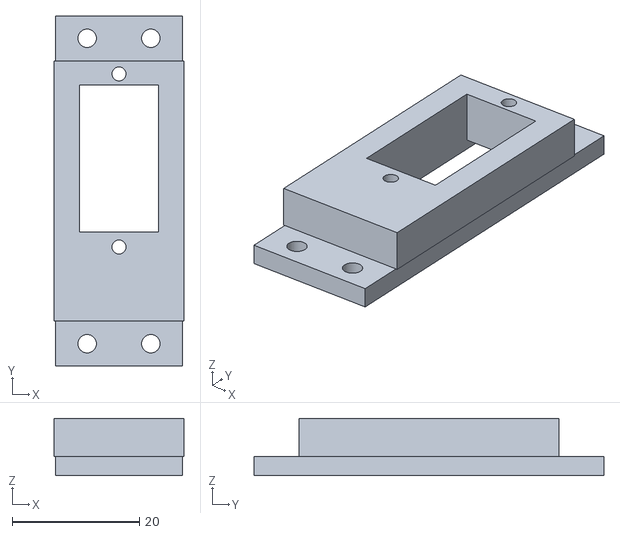
[picture p75: CAD file, 2026-10-23]
cao/prototype_final/exports/stl/support_sg90.stl
20.4 x 55.0 x 9.00
