hugoprigent/FieldMind/cao/mounts/prototype/direction_v04_servo_traversant/exports/stl/rondelle_M3_0.6mm.stl

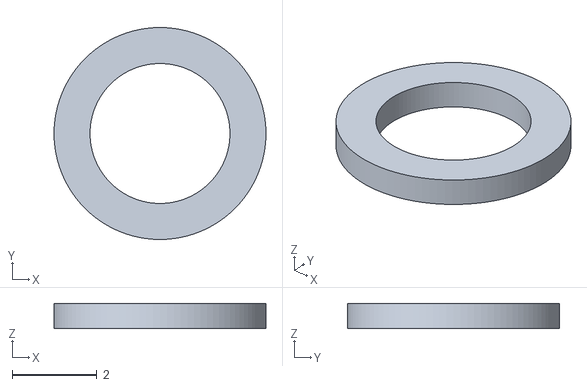
[picture p76: CAD file, 2026-10-20]
cao/mounts/prototype/direction_v04_servo_traversant/exports/stl/rondelle_M3_0.6mm.stl
5.00 x 5.00 x 0.6
