hugoprigent/FieldMind/cao/prototype_final/exports/stl/coque_D2_flanc_avant_droit.stl

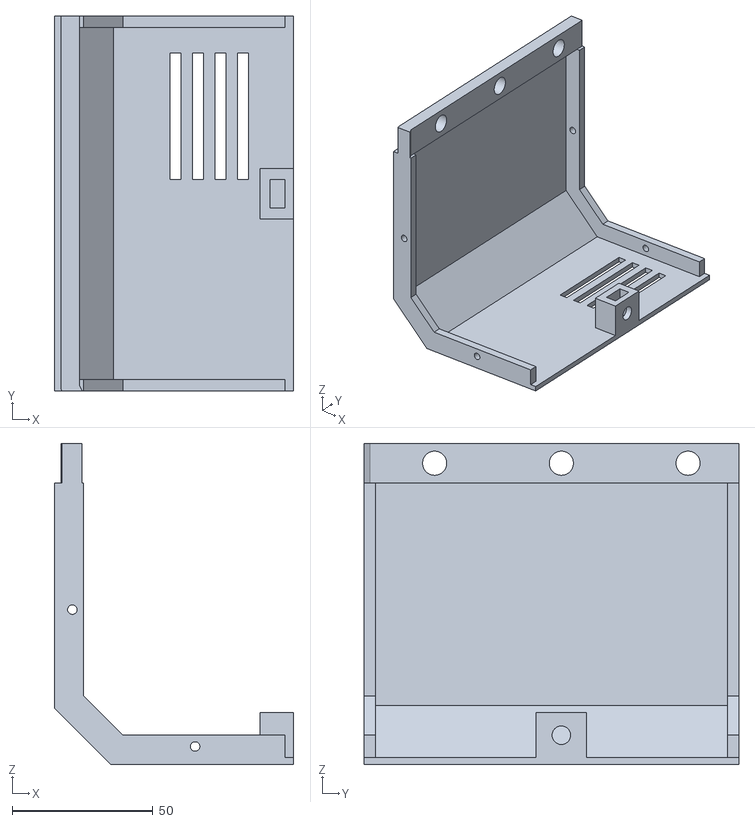
[picture p77: CAD file, 2026-10-20]
cao/prototype_final/exports/stl/coque_D2_flanc_avant_droit.stl
85.0 x 133.0 x 114.0
