hugoprigent/FieldMind/cao/prototype_final/remorque/exports/stl/ferrure_AR_G.stl

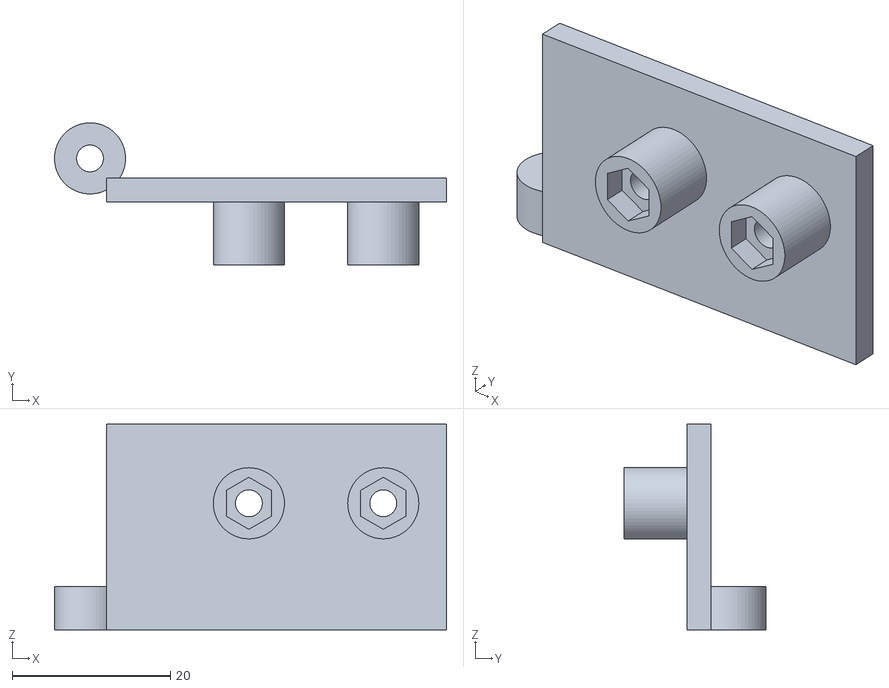
[picture p78: CAD file, 2026-10-20]
cao/prototype_final/remorque/exports/stl/ferrure_AR_G.stl
49.6 x 18.0 x 26.0
