hugoprigent/FieldMind/cao/mounts/prototype/direction_v04_servo_traversant/exports/stl/fusee_G.stl

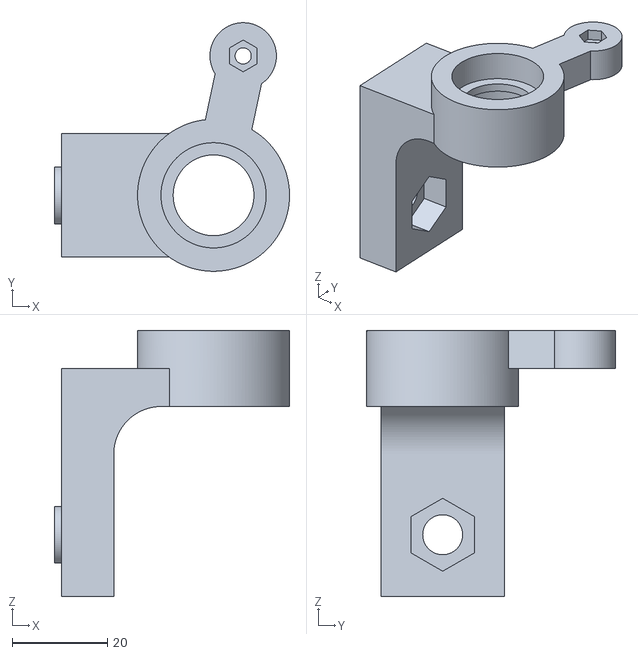
[picture p79: CAD file, 2026-10-20]
cao/mounts/prototype/direction_v04_servo_traversant/exports/stl/fusee_G.stl
49.5 x 52.3 x 56.0
