hugoprigent/FieldMind/cao/prototype_final/exports/stl/coque_G4_flanc_arriere_gauche.stl

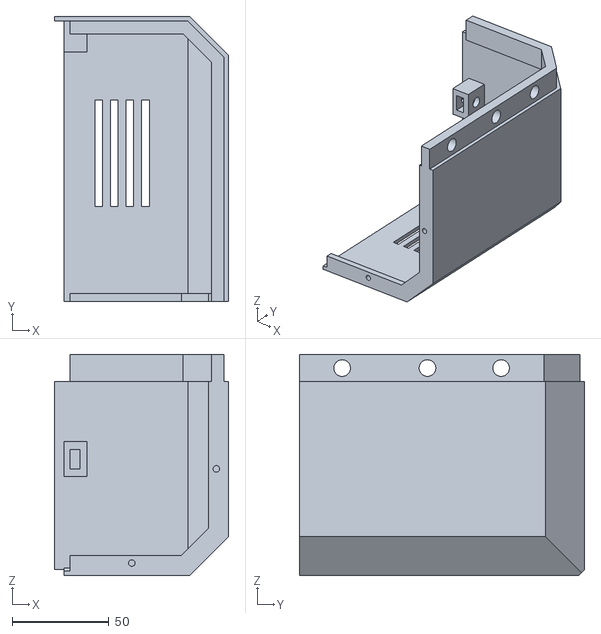
[picture p80: CAD file, 2026-10-20]
cao/prototype_final/exports/stl/coque_G4_flanc_arriere_gauche.stl
90.0 x 147.0 x 114.0
