hugoprigent/FieldMind/cao/prototype_final/remorque/exports/stl/chape_attelage_rover.stl

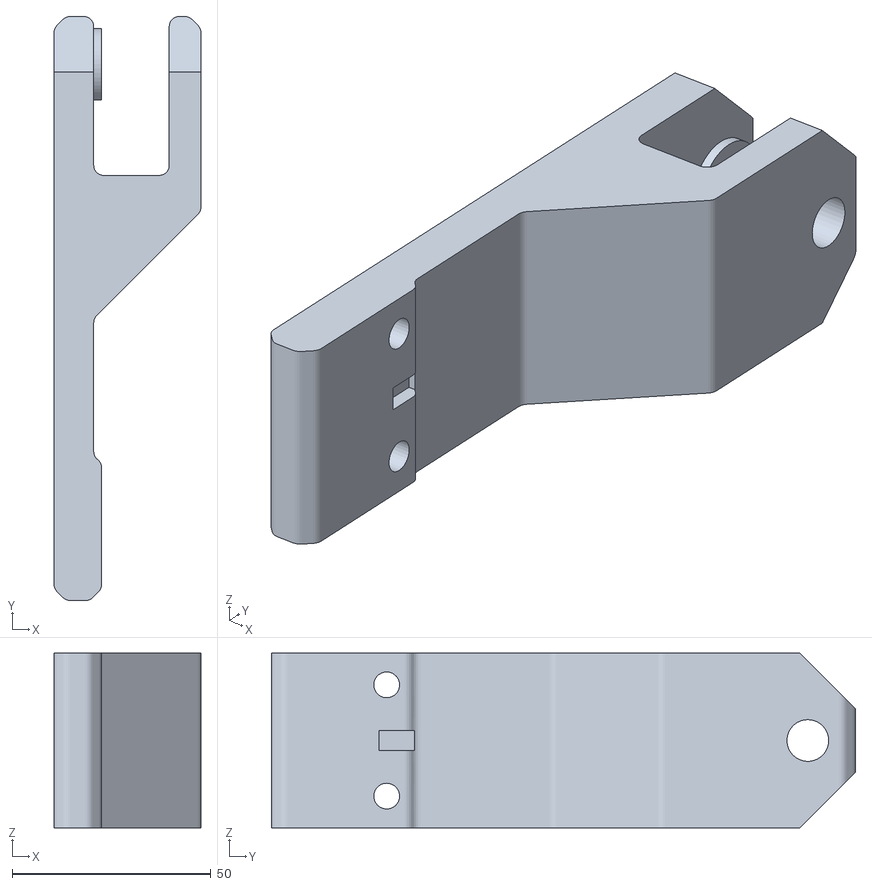
[picture p81: CAD file, 2026-10-20]
cao/prototype_final/remorque/exports/stl/chape_attelage_rover.stl
37.0 x 147.0 x 44.0
