hugoprigent/FieldMind/cao/mounts/prototype/direction_v04_servo_traversant/exports/stl/biellette.stl

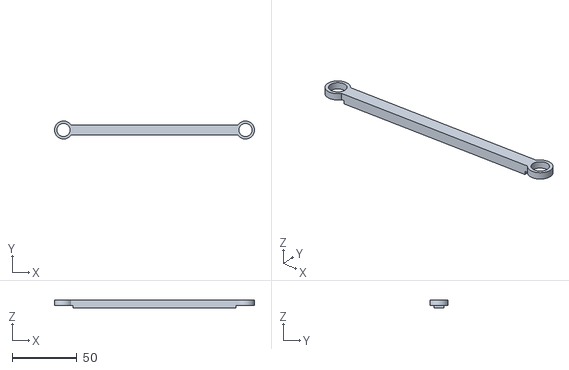
[picture p82: CAD file, 2026-10-20]
cao/mounts/prototype/direction_v04_servo_traversant/exports/stl/biellette.stl
154.8 x 14.0 x 6.00
