hugoprigent/FieldMind/cao/prototype_final/exports/stl/palonnier_planche_10mm.stl

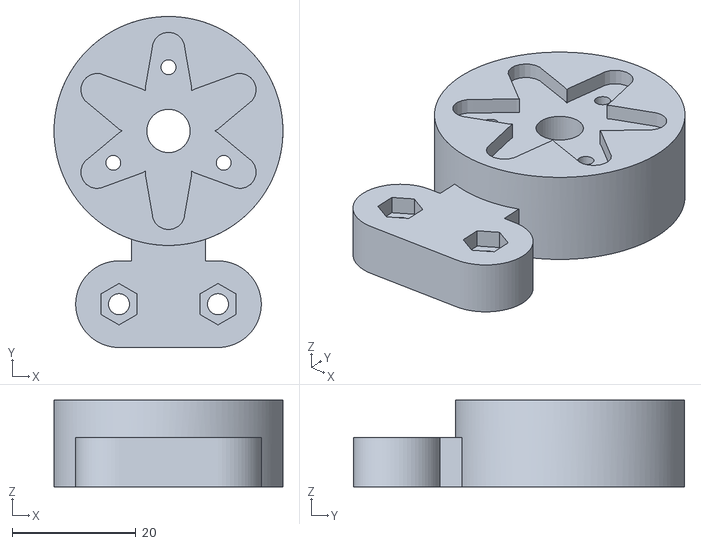
[picture p83: CAD file, 2026-10-20]
cao/prototype_final/exports/stl/palonnier_planche_10mm.stl
37.0 x 53.5 x 14.0
