hugoprigent/FieldMind/cao/prototype_final/remorque/exports/stl/joue_M2_D.stl

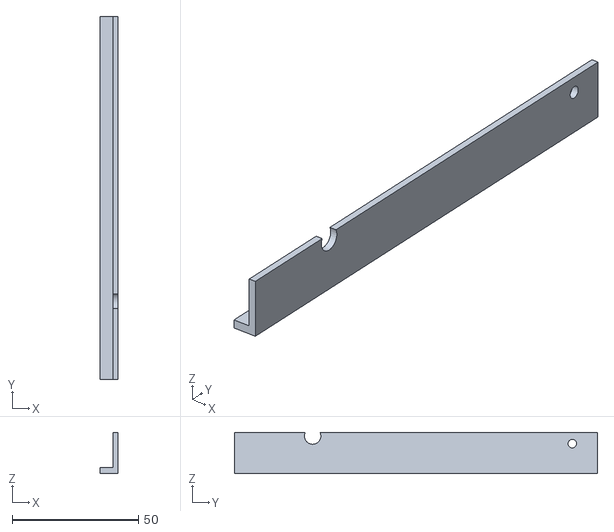
[picture p84: CAD file, 2026-10-20]
cao/prototype_final/remorque/exports/stl/joue_M2_D.stl
7.00 x 144.0 x 16.4
