hugoprigent/FieldMind/cao/mounts/prototype/direction_v04_servo_traversant/exports/stl/jante_608ZZ.stl

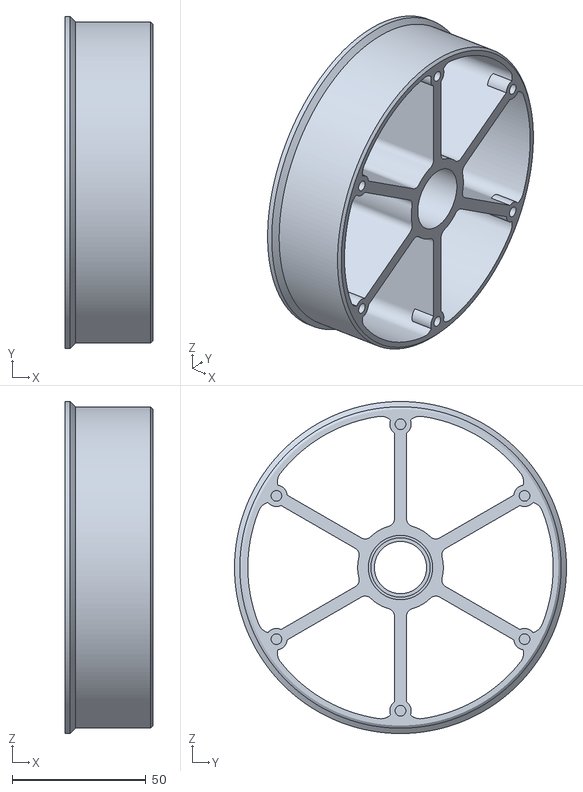
[picture p85: CAD file, 2026-10-20]
cao/mounts/prototype/direction_v04_servo_traversant/exports/stl/jante_608ZZ.stl
33.0 x 124.0 x 124.0
