hugoprigent/FieldMind/cao/prototype_final/exports/stl/support_moteur_arriere.stl

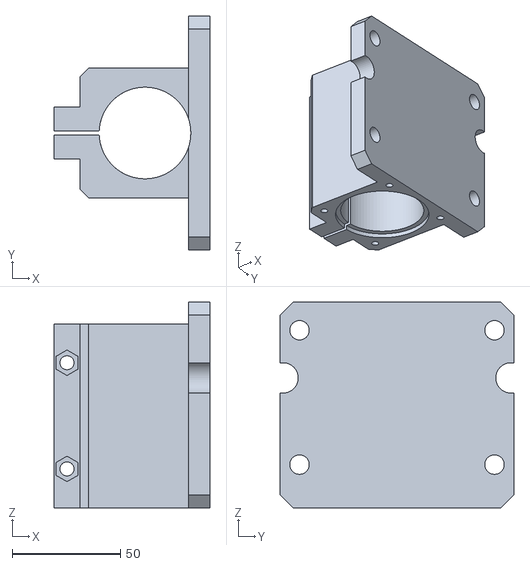
[picture p86: CAD file, 2026-10-20]
cao/prototype_final/exports/stl/support_moteur_arriere.stl
72.0 x 108.0 x 95.0
