hugoprigent/FieldMind/cao/prototype_final/remorque/exports/stl/bague_625_dans_logement_608.stl

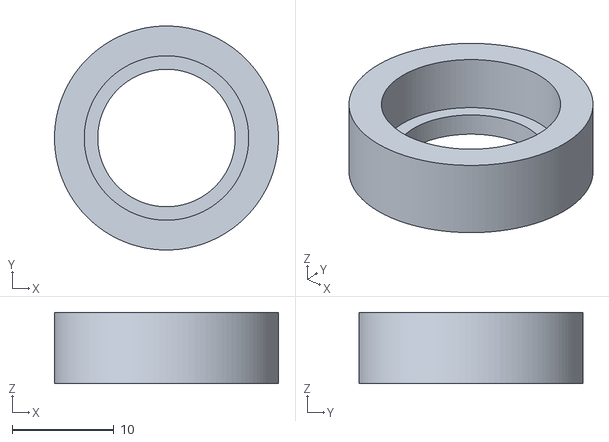
[picture p87: CAD file, 2026-10-20]
cao/prototype_final/remorque/exports/stl/bague_625_dans_logement_608.stl
22.0 x 22.0 x 7.00
