hugoprigent/FieldMind/cao/mounts/prototype/direction_v04_servo_traversant/exports/stl/barre_stereo.stl

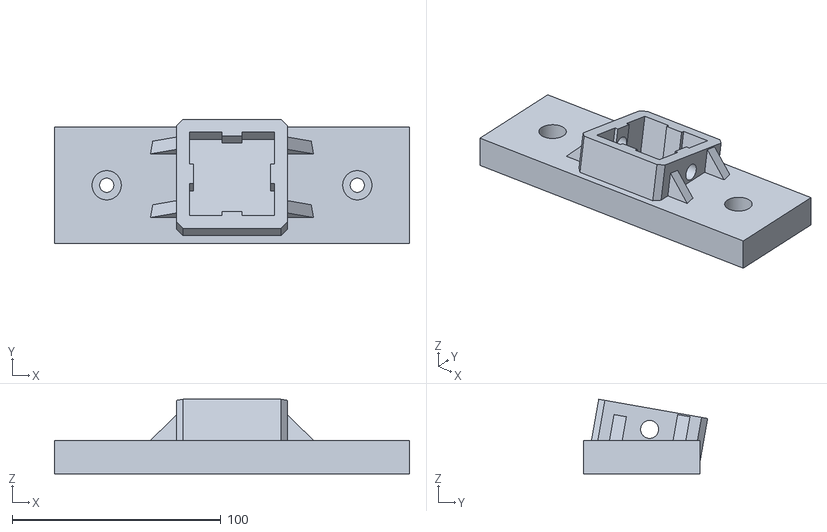
[picture p88: CAD file, 2026-10-20]
cao/mounts/prototype/direction_v04_servo_traversant/exports/stl/barre_stereo.stl
170.0 x 59.6 x 35.7
