hugoprigent/FieldMind/cao/prototype_final/exports/stl/berceau_batterie.stl

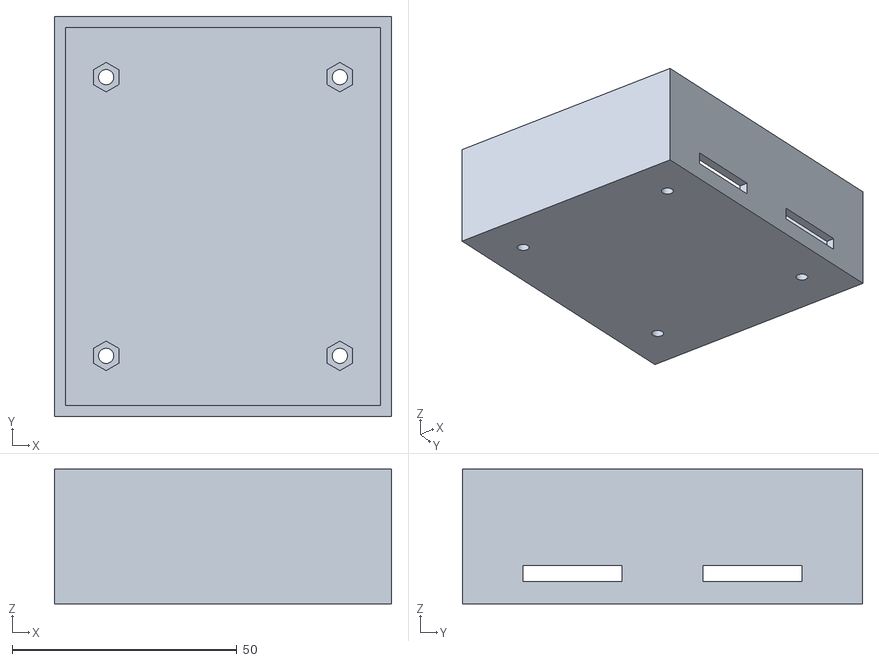
[picture p89: CAD file, 2026-10-20]
cao/prototype_final/exports/stl/berceau_batterie.stl
75.0 x 89.0 x 30.0
