hugoprigent/FieldMind/cao/prototype_final/remorque/exports/stl/joue_M1_G.stl

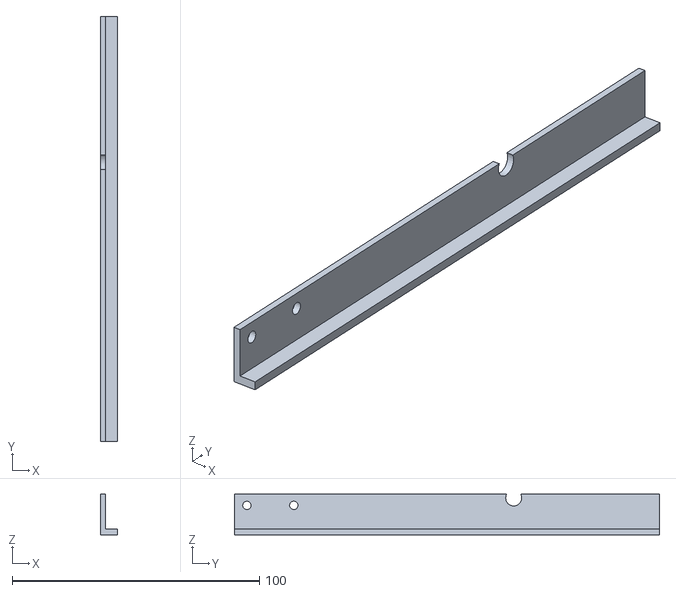
[picture p90: CAD file, 2026-10-20]
cao/prototype_final/remorque/exports/stl/joue_M1_G.stl
7.00 x 172.0 x 16.4
