hugoprigent/FieldMind/cao/prototype_final/exports/stl/incrustation_FIELDMIND_D.stl

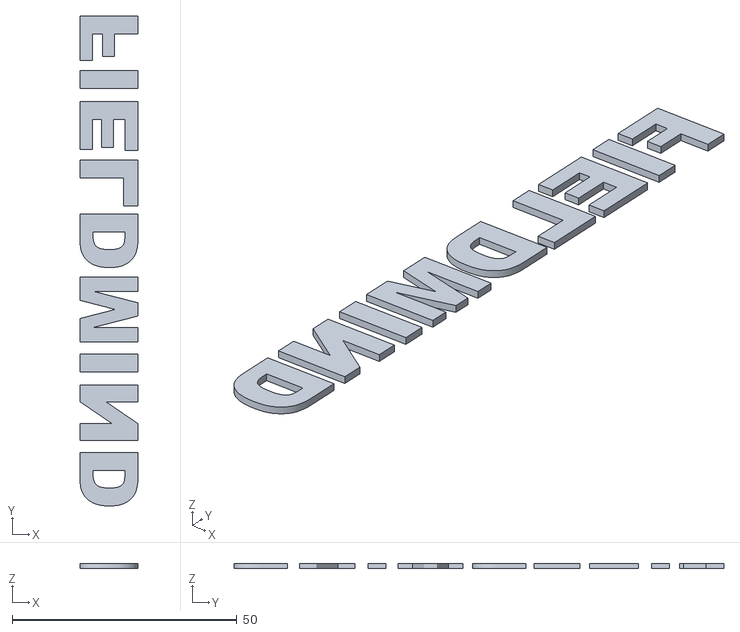
[picture p92: CAD file, 2026-10-20]
cao/prototype_final/exports/stl/incrustation_FIELDMIND_D.stl
12.9 x 108.9 x 1.20
