hugoprigent/FieldMind/cao/mounts/prototype/direction_v04_servo_traversant/exports/stl/rondelle_2mm.stl

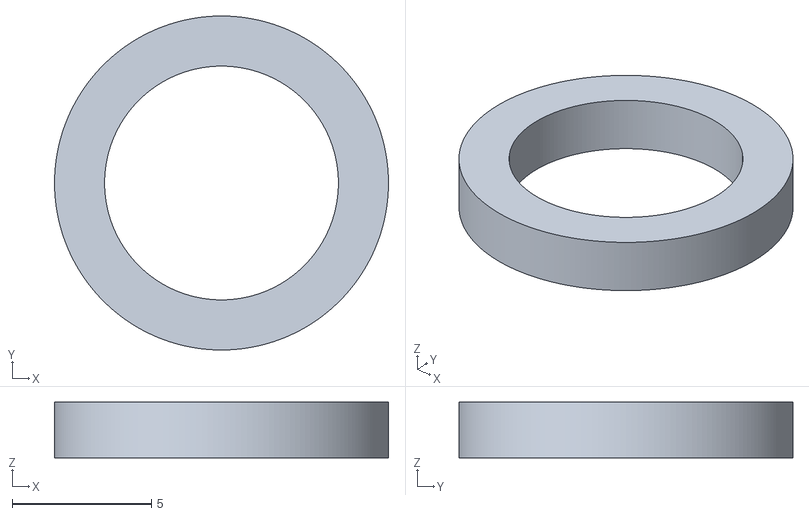
[picture p93: CAD file, 2026-10-20]
cao/mounts/prototype/direction_v04_servo_traversant/exports/stl/rondelle_2mm.stl
12.0 x 12.0 x 2.00
