hugoprigent/FieldMind/cao/prototype_final/exports/stl/coque_D1_nez_droit.stl

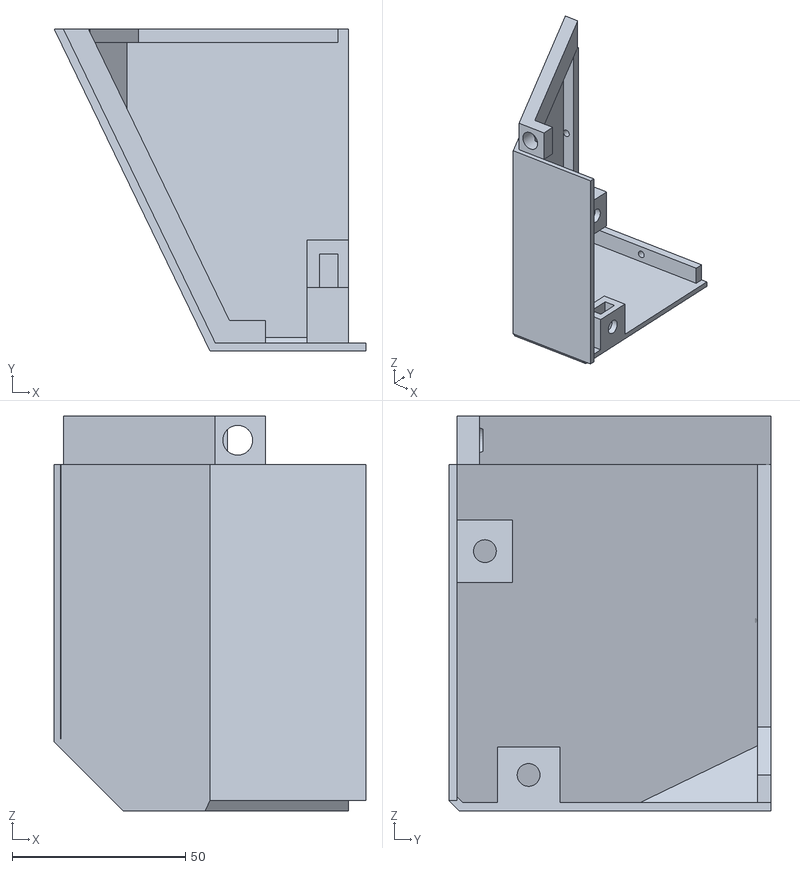
[picture p94: CAD file, 2026-10-20]
cao/prototype_final/exports/stl/coque_D1_nez_droit.stl
90.0 x 93.0 x 114.0
