hugoprigent/FieldMind/cao/prototype_final/remorque/exports/stl/timon.stl

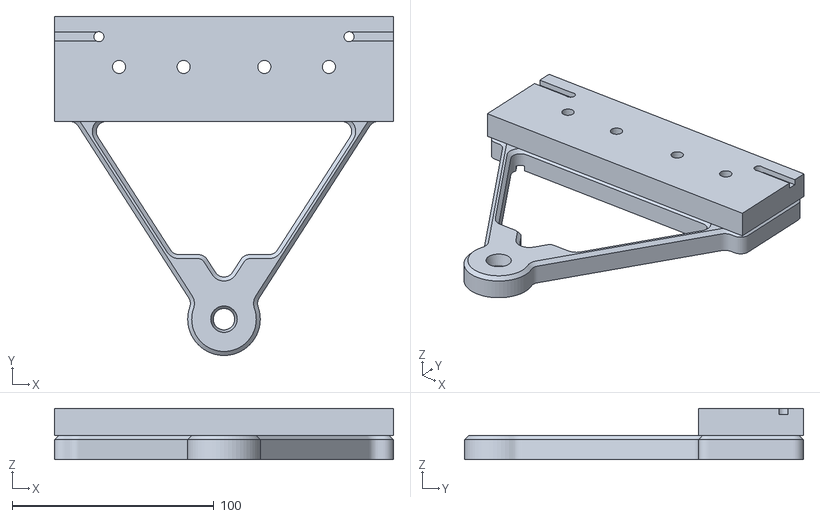
[picture p95: CAD file, 2026-10-20]
cao/prototype_final/remorque/exports/stl/timon.stl
168.0 x 168.0 x 25.5
