hugoprigent/FieldMind/cao/prototype_final/exports/stl/fusee_renforcee_G.stl

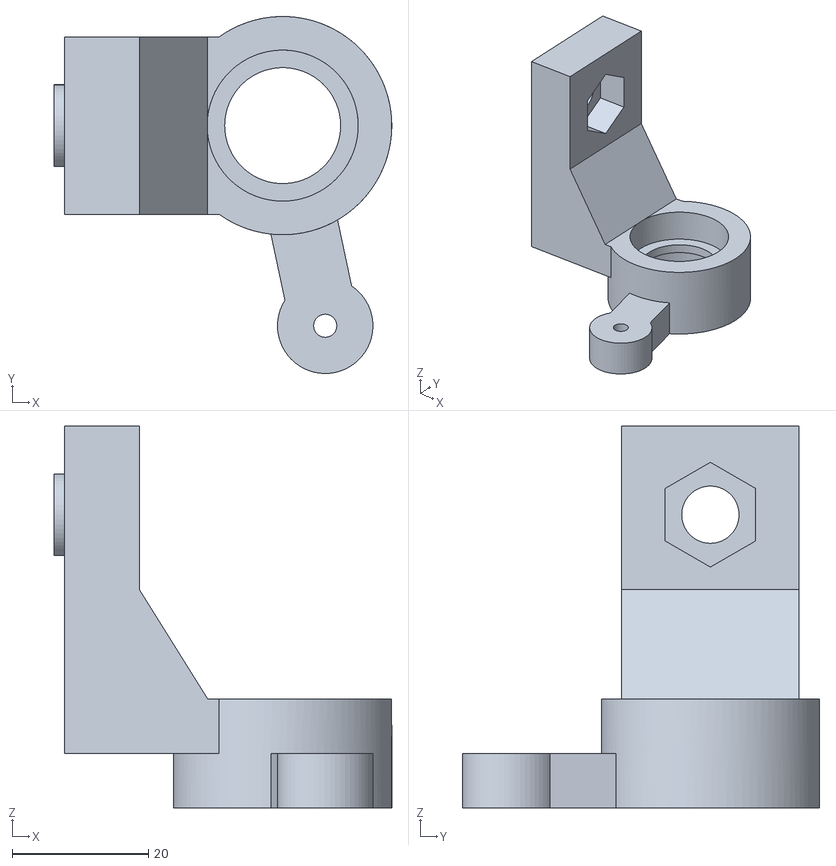
[picture p97: CAD file, 2026-10-20]
cao/prototype_final/exports/stl/fusee_renforcee_G.stl
49.5 x 52.3 x 56.0
