hugoprigent/FieldMind/cao/prototype_final/remorque/exports/stl/rebord_AR_D.stl

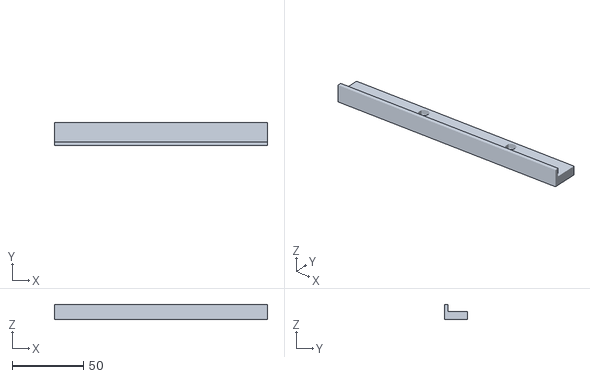
[picture p98: CAD file, 2026-10-20]
cao/prototype_final/remorque/exports/stl/rebord_AR_D.stl
150.0 x 16.4 x 10.5
