hugoprigent/FieldMind/cao/mounts/prototype/direction_v04_servo_traversant/exports/stl/support_lidar_C1.stl

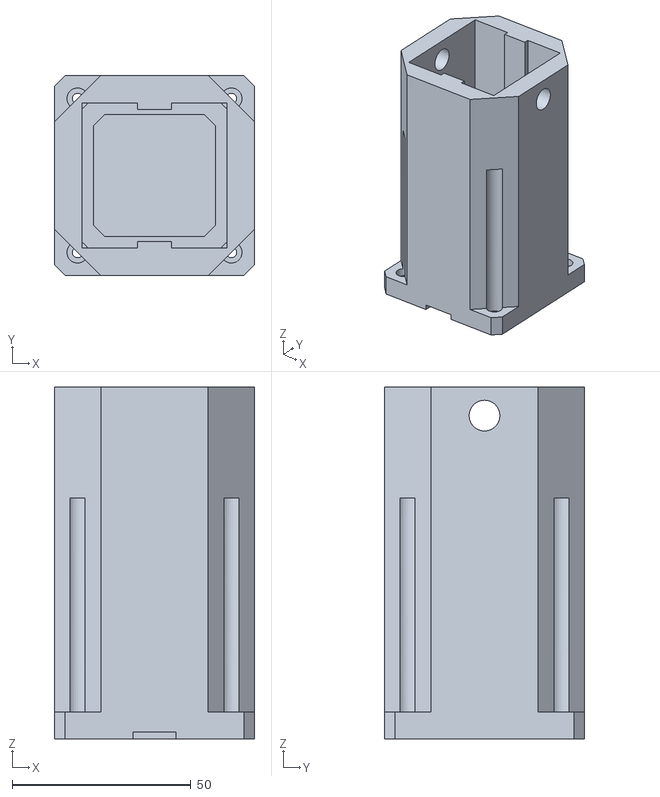
[picture p99: CAD file, 2026-10-20]
cao/mounts/prototype/direction_v04_servo_traversant/exports/stl/support_lidar_C1.stl
56.0 x 56.0 x 98.5
