hugoprigent/FieldMind/cao/prototype_final/remorque/exports/stl/charniere_AR_G.stl

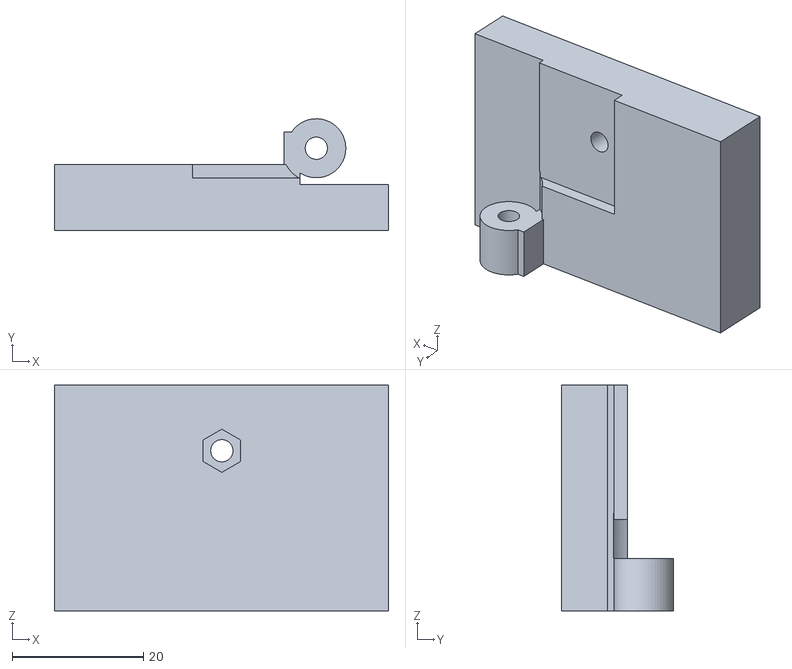
[picture p100: CAD file, 2026-10-20]
cao/prototype_final/remorque/exports/stl/charniere_AR_G.stl
50.9 x 17.0 x 34.4
