hugoprigent/FieldMind/cao/mounts/prototype/direction_v04_servo_traversant/exports/stl/support_pivot_D.stl

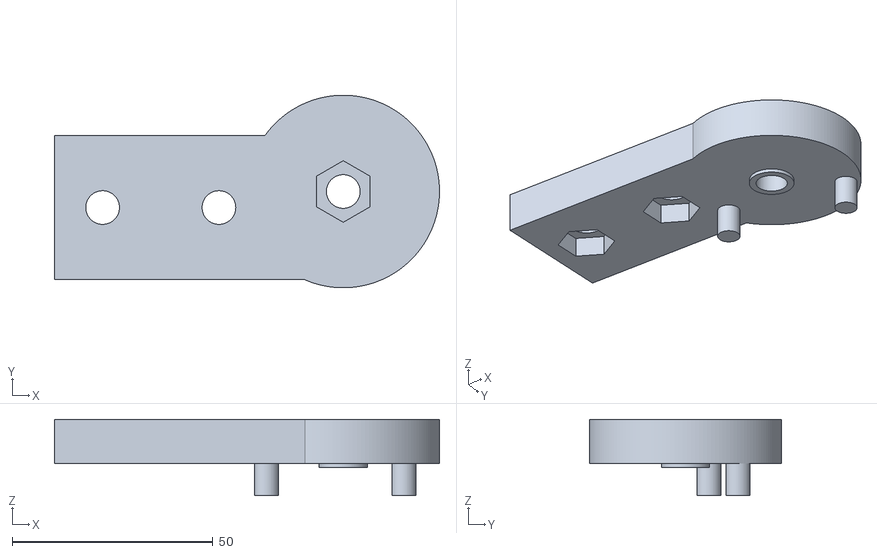
[picture p101: CAD file, 2026-10-20]
cao/mounts/prototype/direction_v04_servo_traversant/exports/stl/support_pivot_D.stl
96.0 x 48.0 x 19.0
