hugoprigent/FieldMind/cao/prototype_final/exports/stl/support_moteur_arriere_v2.stl

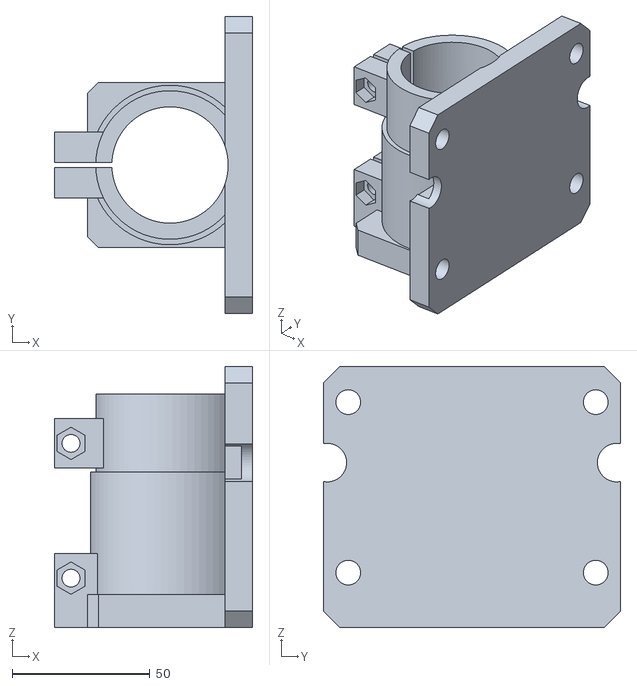
[picture p102: CAD file, 2026-10-20]
cao/prototype_final/exports/stl/support_moteur_arriere_v2.stl
72.0 x 108.0 x 95.0
