hugoprigent/FieldMind/cao/prototype_final/remorque/exports/stl/cale_jambe_3mm.stl

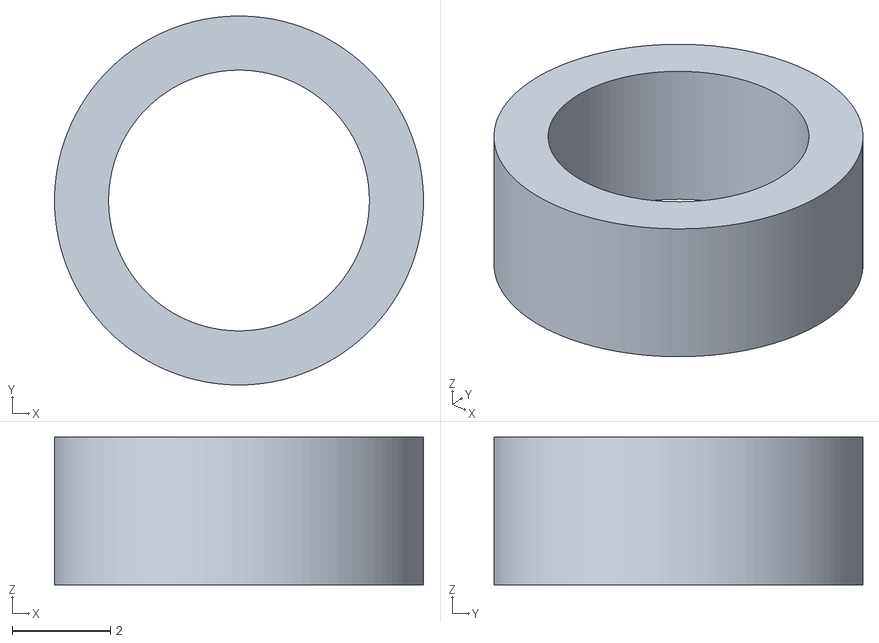
[picture p103: CAD file, 2026-10-20]
cao/prototype_final/remorque/exports/stl/cale_jambe_3mm.stl
7.50 x 7.50 x 3.00
