hugoprigent/FieldMind/cao/mounts/prototype/direction_v04_servo_traversant/exports/stl/palonnier.stl

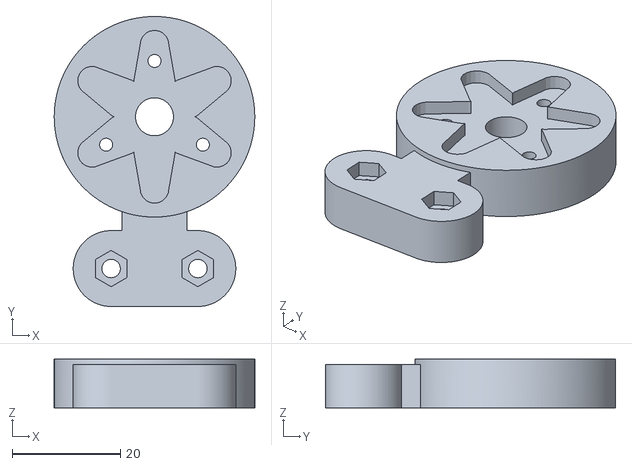
[picture p104: CAD file, 2026-10-20]
cao/mounts/prototype/direction_v04_servo_traversant/exports/stl/palonnier.stl
37.0 x 53.5 x 9.00
