hugoprigent/FieldMind/cao/prototype_final/remorque/exports/stl/rebord_AV_D.stl

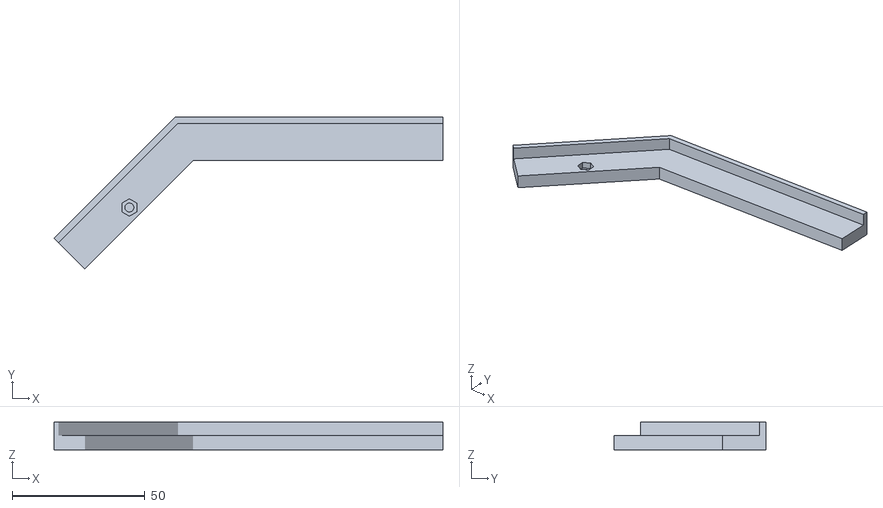
[picture p105: CAD file, 2026-10-20]
cao/prototype_final/remorque/exports/stl/rebord_AV_D.stl
146.7 x 57.3 x 10.5
