hugoprigent/FieldMind/cao/mounts/prototype/direction_v04_servo_traversant/exports/stl/pneu_TPU.stl

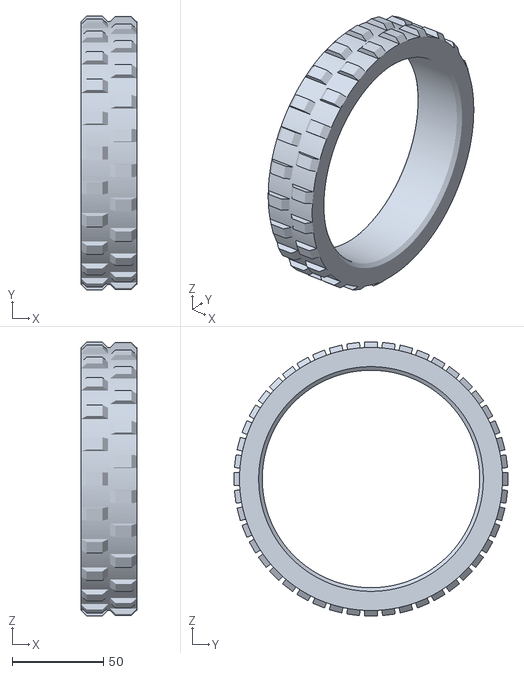
[picture p106: CAD file, 2026-10-20]
cao/mounts/prototype/direction_v04_servo_traversant/exports/stl/pneu_TPU.stl
30.6 x 150.0 x 150.0
