hugoprigent/FieldMind/cao/prototype_final/exports/stl/support_xl4015.stl

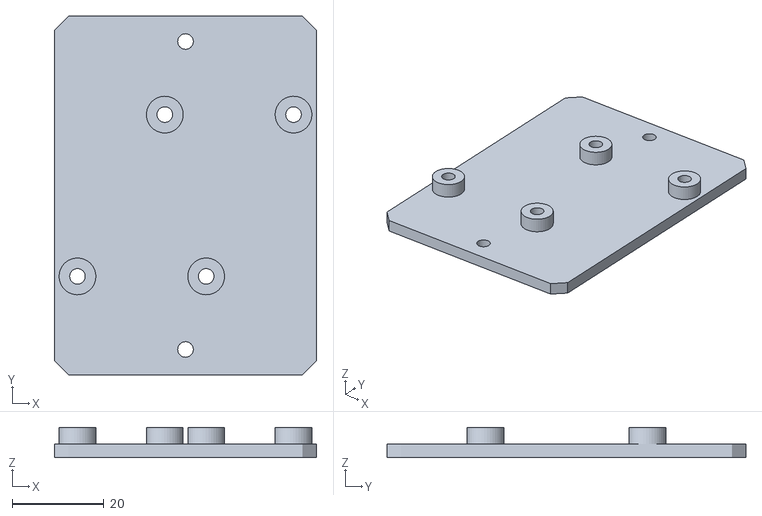
[picture p107: CAD file, 2026-10-20]
cao/prototype_final/exports/stl/support_xl4015.stl
57.0 x 78.0 x 6.60
