hugoprigent/FieldMind/cao/prototype_final/exports/stl/coque_C4_bande_arriere_lidar.stl

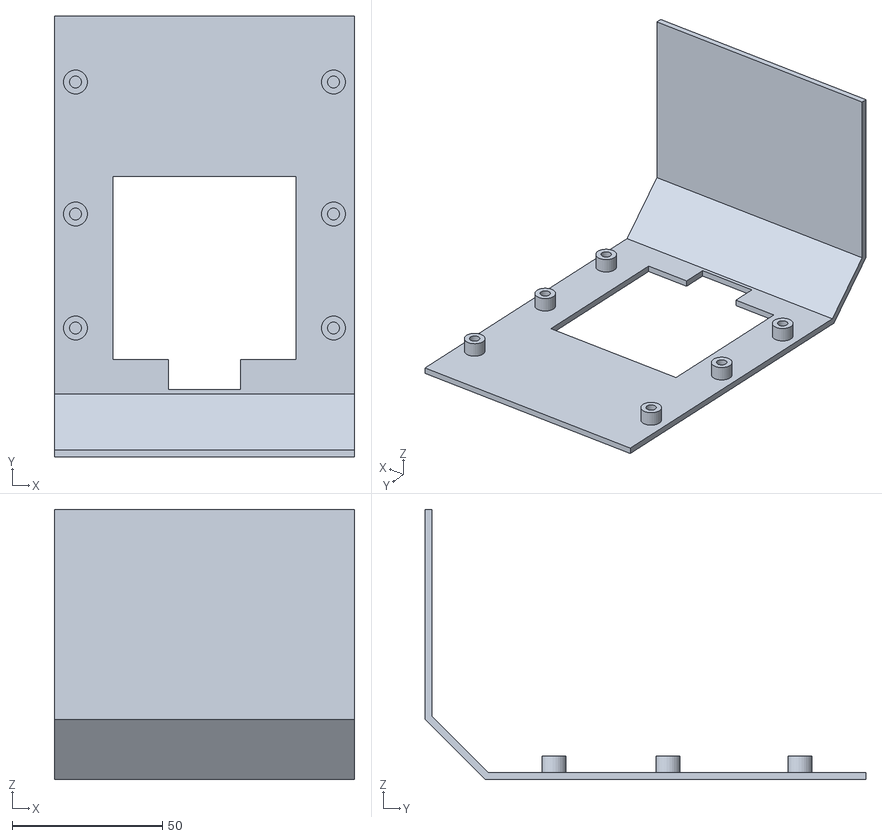
[picture p108: CAD file, 2026-10-20]
cao/prototype_final/exports/stl/coque_C4_bande_arriere_lidar.stl
100.0 x 147.0 x 90.0
