hugoprigent/FieldMind/cao/prototype_final/remorque/exports/stl/boitier_servo_G.stl

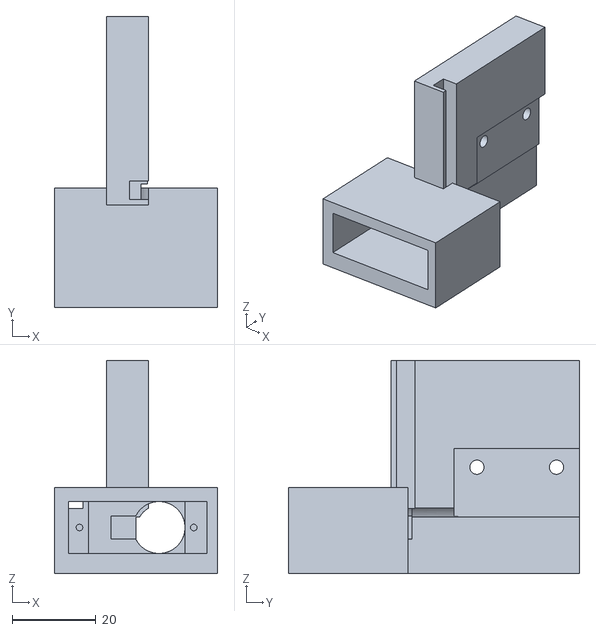
[picture p109: CAD file, 2026-10-20]
cao/prototype_final/remorque/exports/stl/boitier_servo_G.stl
39.0 x 69.5 x 50.9
