hugoprigent/FieldMind/cao/prototype_final/exports/stl/coque_C2_bande_avant.stl

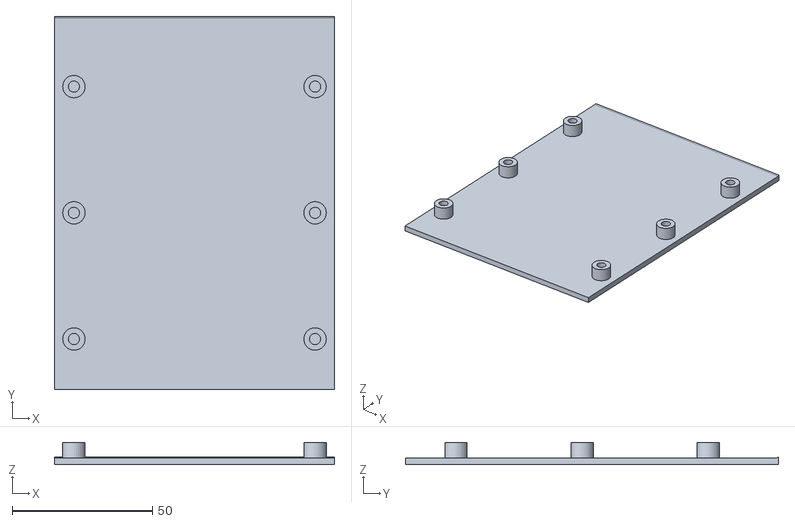
[picture p110: CAD file, 2026-10-20]
cao/prototype_final/exports/stl/coque_C2_bande_avant.stl
100.0 x 133.0 x 7.90
