hugoprigent/FieldMind/cao/prototype_final/remorque/exports/stl/rondelle_tete_M5_2mm.stl

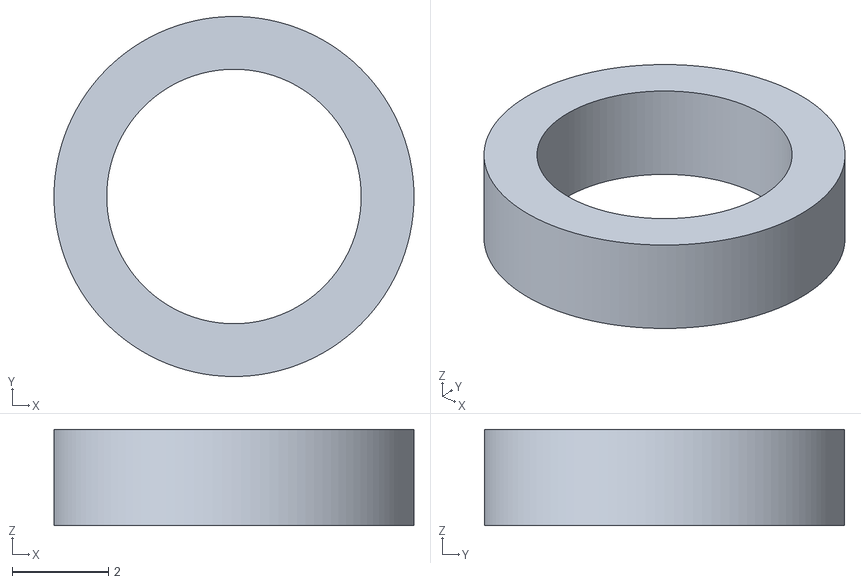
[picture p111: CAD file, 2026-10-20]
cao/prototype_final/remorque/exports/stl/rondelle_tete_M5_2mm.stl
7.50 x 7.50 x 2.00
