hugoprigent/FieldMind/cao/prototype_final/exports/stl/capuchon_knob.stl

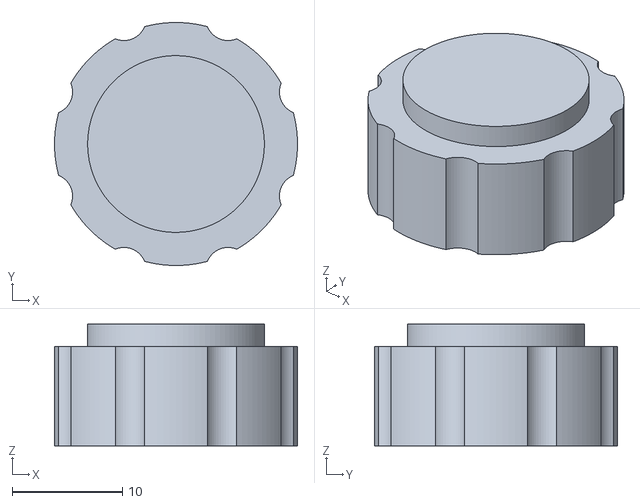
[picture p112: CAD file, 2026-10-20]
cao/prototype_final/exports/stl/capuchon_knob.stl
22.0 x 22.0 x 11.0
