hugoprigent/FieldMind/cao/prototype_final/remorque/exports/stl/entretoise_625_6.2mm.stl

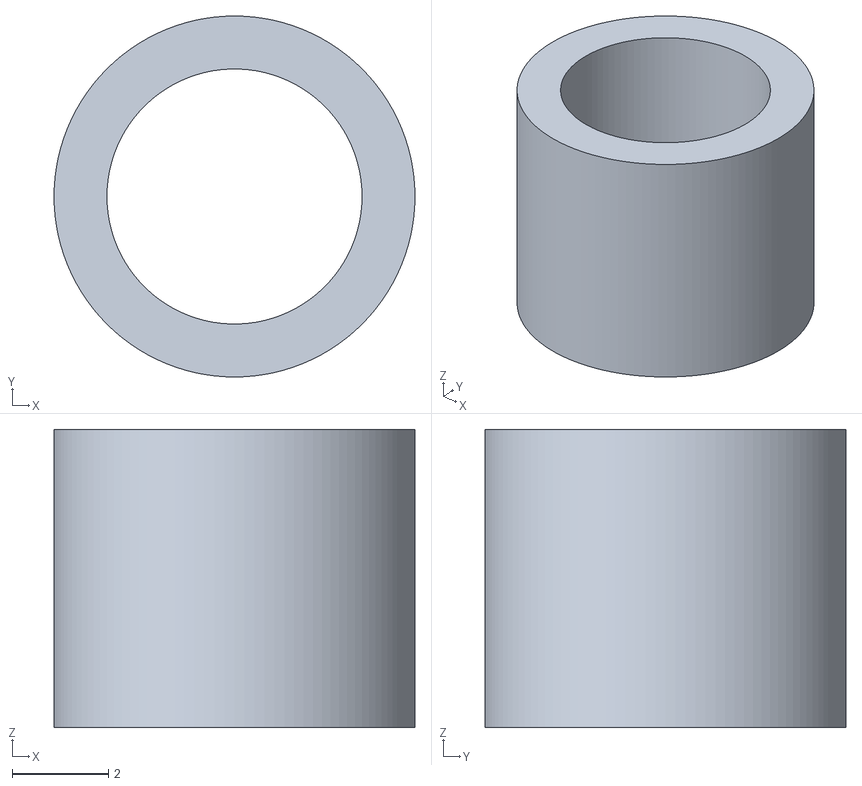
[picture p113: CAD file, 2026-10-20]
cao/prototype_final/remorque/exports/stl/entretoise_625_6.2mm.stl
7.50 x 7.50 x 6.20
