hugoprigent/FieldMind/cao/prototype_final/exports/stl/coque_C1_nez.stl

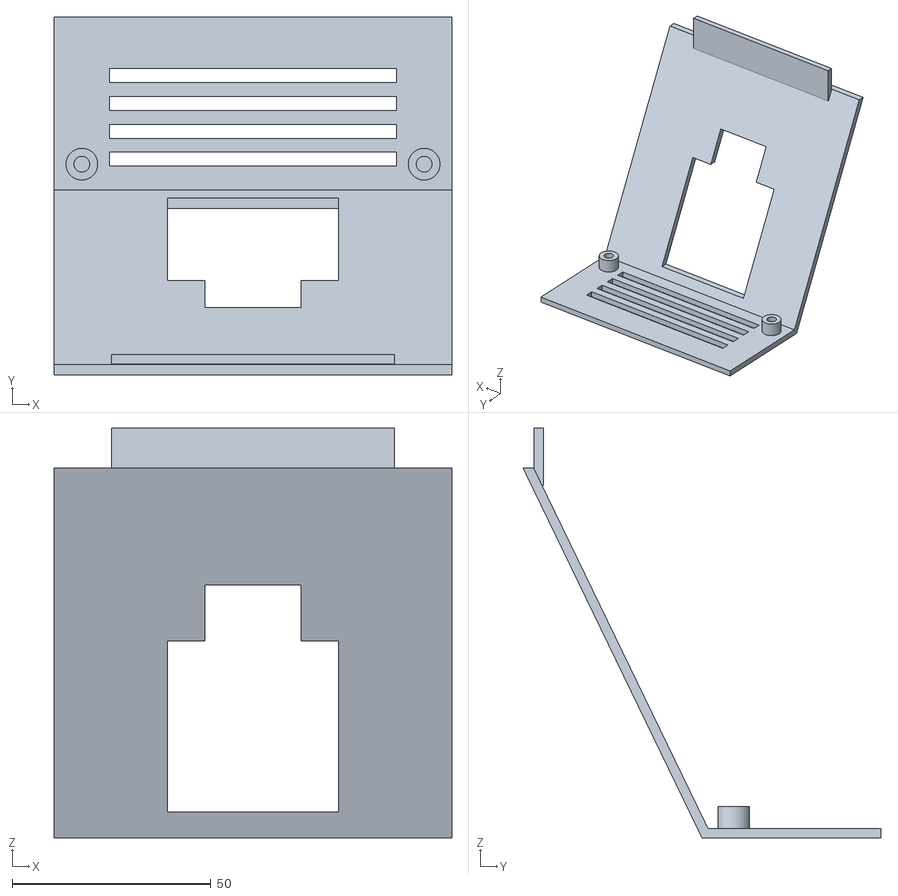
[picture p114: CAD file, 2026-10-20]
cao/prototype_final/exports/stl/coque_C1_nez.stl
100.0 x 90.0 x 103.0
