hugoprigent/FieldMind/cao/prototype_final/remorque/exports/stl/support_roue_D.stl

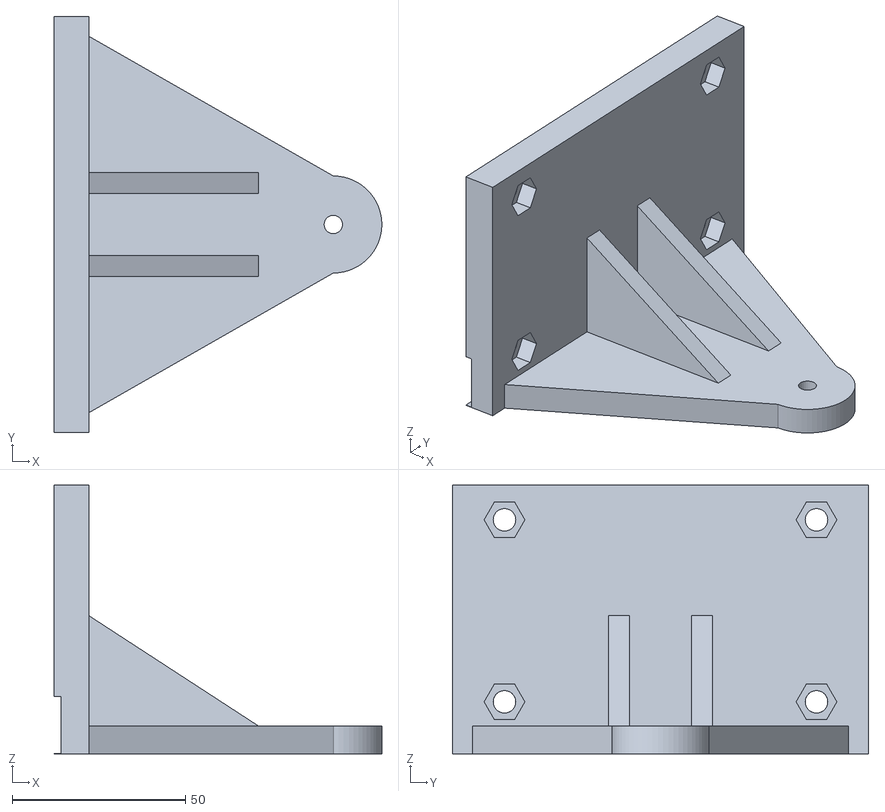
[picture p115: CAD file, 2026-10-20]
cao/prototype_final/remorque/exports/stl/support_roue_D.stl
94.5 x 120.0 x 77.5
