hugoprigent/FieldMind/cao/prototype_final/exports/stl/coque_C3_bande_ecran_knob.stl

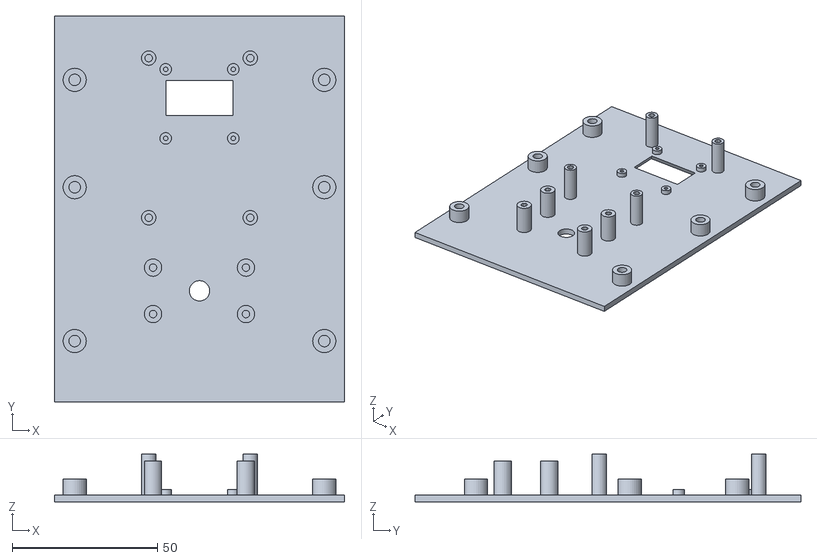
[picture p116: CAD file, 2026-10-20]
cao/prototype_final/exports/stl/coque_C3_bande_ecran_knob.stl
100.0 x 133.0 x 16.4
