hugoprigent/FieldMind/(list of files, cad)

Other CAD files:
cao/prototype_final/remorque/exports/stl/ferrure_AV_D.stl
cao/prototype_final/remorque/exports/stl/ferrure_AR_D.stl
cao/prototype_final/exports/stl/coque_G3_flanc_milieu_gauche.stl
cao/prototype_final/exports/stl/coque_D3_flanc_milieu_droit.stl
cao/prototype_final/remorque/exports/stl/rebord_AR_G.stl
cao/mounts/prototype/direction_v04_servo_traversant/exports/stl/support_pivot_G.stl
cao/prototype_final/exports/stl/coque_G2_flanc_avant_gauche.stl
cao/prototype_final/remorque/exports/stl/charniere_AR_D.stl
cao/mounts/prototype/direction_v04_servo_traversant/exports/stl/fusee_D.stl
cao/prototype_final/remorque/exports/stl/joue_M1_D.stl
cao/prototype_final/exports/stl/fusee_renforcee_D.stl
cao/prototype_final/exports/stl/incrustation_FIELDMIND_G.stl
cao/prototype_final/remorque/exports/stl/rebord_AV_G.stl
cao/prototype_final/remorque/exports/stl/joue_M2_G.stl
cao/prototype_final/exports/stl/coque_D4_flanc_arriere_droit.stl
cao/prototype_final/remorque/exports/stl/boitier_servo_D.stl
cao/prototype_final/exports/stl/coque_G1_nez_gauche.stl
cao/prototype_final/remorque/exports/stl/support_roue_G.stl
