hugoprigent/FieldMind/hardware/electronics/carte_capteurs/exports/c5_a7/guide_cablage.html

# FieldMind C5 · A7 · une perfboard, tous les fils dessous

Choisir une liaison pour la suivre. Dessus : ponts de soudure seulement. Dessous : trait plein = fil nu, tirets = fil isolé (passe par-dessus).

## Connexions par composant

Composant | Carte | Broche | Nom | Trou | Net | Relié à
J3 | OLED 0,96 I2C | 1 | GND | F1 | GND | J1.2 (GND), J2.2 (GND), U1.13 (GND), J4.2 (GND), J6.2 (GND), J7.1 (GND)
J3 | OLED 0,96 I2C | 2 | VCC | G1 | +3V3 | J1.1 (VCC), J2.1 (VCC), U1.12 (3V3), J4.3 (VCC), J6.3 (3V3), J7.2 (3V3)
J3 | OLED 0,96 I2C | 3 | SCL | H1 | I2C_SCL | J1.3 (SCL), J2.3 (SCL), U1.6 (D5), J7.4 (SCL)
J3 | OLED 0,96 I2C | 4 | SDA | I1 | I2C_SDA | J1.4 (SDA), J2.4 (SDA), U1.5 (D4), J7.3 (SDA)
J1 | GY-521 MPU-6050 | 1 | VCC | B20 | +3V3 | J3.2 (VCC), J2.1 (VCC), U1.12 (3V3), J4.3 (VCC), J6.3 (3V3), J7.2 (3V3)
J1 | GY-521 MPU-6050 | 2 | GND | C20 | GND | J3.1 (GND), J2.2 (GND), U1.13 (GND), J4.2 (GND), J6.2 (GND), J7.1 (GND)
J1 | GY-521 MPU-6050 | 3 | SCL | D20 | I2C_SCL | J3.3 (SCL), J2.3 (SCL), U1.6 (D5), J7.4 (SCL)
J1 | GY-521 MPU-6050 | 4 | SDA | E20 | I2C_SDA | J3.4 (SDA), J2.4 (SDA), U1.5 (D4), J7.3 (SDA)
J1 | GY-521 MPU-6050 | 5 | XDA | F20 | non câblé
J1 | GY-521 MPU-6050 | 6 | XCL | G20 | non câblé
J1 | GY-521 MPU-6050 | 7 | AD0 | H20 | non câblé
J1 | GY-521 MPU-6050 | 8 | INT | I20 | non câblé
J2 | GY-BMP280-3.3 | 1 | VCC | N18 | +3V3 | J3.2 (VCC), J1.1 (VCC), U1.12 (3V3), J4.3 (VCC), J6.3 (3V3), J7.2 (3V3)
J2 | GY-BMP280-3.3 | 2 | GND | N17 | GND | J3.1 (GND), J1.2 (GND), U1.13 (GND), J4.2 (GND), J6.2 (GND), J7.1 (GND)
J2 | GY-BMP280-3.3 | 3 | SCL | N16 | I2C_SCL | J3.3 (SCL), J1.3 (SCL), U1.6 (D5), J7.4 (SCL)
J2 | GY-BMP280-3.3 | 4 | SDA | N15 | I2C_SDA | J3.4 (SDA), J1.4 (SDA), U1.5 (D4), J7.3 (SDA)
J2 | GY-BMP280-3.3 | 5 | CSB | N14 | non câblé
J2 | GY-BMP280-3.3 | 6 | SDO | N13 | non câblé
U1 | Seeed XIAO ESP32C5 | 1 | D0 | J2 | EXT_D0 | J8.1 (D0)
U1 | Seeed XIAO ESP32C5 | 2 | D1 | J3 | EXT_D1 | J8.2 (D1)
U1 | Seeed XIAO ESP32C5 | 3 | D2 | J4 | EXT_D2 | J8.3 (D2)
U1 | Seeed XIAO ESP32C5 | 4 | D3 | J5 | EXT_D3 | J8.4 (D3)
U1 | Seeed XIAO ESP32C5 | 5 | D4 | J6 | I2C_SDA | J3.4 (SDA), J1.4 (SDA), J2.4 (SDA), J7.3 (SDA)
U1 | Seeed XIAO ESP32C5 | 6 | D5 | J7 | I2C_SCL | J3.3 (SCL), J1.3 (SCL), J2.3 (SCL), J7.4 (SCL)
U1 | Seeed XIAO ESP32C5 | 7 | D6 | J8 | GNSS_TX | J4.1 (RX_GPS)
U1 | Seeed XIAO ESP32C5 | 8 | D7 | D8 | GNSS_RX | J4.4 (TX_GPS)
U1 | Seeed XIAO ESP32C5 | 9 | D8 | D7 | EXT_D8 | J6.6 (D8)
U1 | Seeed XIAO ESP32C5 | 10 | D9 | D6 | EXT_D9 | J6.5 (D9)
U1 | Seeed XIAO ESP32C5 | 11 | D10 | D5 | EXT_D10 | J6.4 (D10)
U1 | Seeed XIAO ESP32C5 | 12 | 3V3 | D4 | +3V3 | J3.2 (VCC), J1.1 (VCC), J2.1 (VCC), J4.3 (VCC), J6.3 (3V3), J7.2 (3V3)
U1 | Seeed XIAO ESP32C5 | 13 | GND | D3 | GND | J3.1 (GND), J1.2 (GND), J2.2 (GND), J4.2 (GND), J6.2 (GND), J7.1 (GND)
U1 | Seeed XIAO ESP32C5 | 14 | 5V | D2 | VBUS_USB | J6.1 (5V)
J4 | GNSS déporté (câble) | 1 | RX_GPS | A12 | GNSS_TX | U1.7 (D6)
J4 | GNSS déporté (câble) | 2 | GND | A11 | GND | J3.1 (GND), J1.2 (GND), J2.2 (GND), U1.13 (GND), J6.2 (GND), J7.1 (GND)
J4 | GNSS déporté (câble) | 3 | VCC | A10 | +3V3 | J3.2 (VCC), J1.1 (VCC), J2.1 (VCC), U1.12 (3V3), J6.3 (3V3), J7.2 (3V3)
J4 | GNSS déporté (câble) | 4 | TX_GPS | A9 | GNSS_RX | U1.8 (D7)
J6 | Extension 5V/3V3/D8-D10 (Dupont) | 1 | 5V | A2 | VBUS_USB | U1.14 (5V)
J6 | Extension 5V/3V3/D8-D10 (Dupont) | 2 | GND | A3 | GND | J3.1 (GND), J1.2 (GND), J2.2 (GND), U1.13 (GND), J4.2 (GND), J7.1 (GND)
J6 | Extension 5V/3V3/D8-D10 (Dupont) | 3 | 3V3 | A4 | +3V3 | J3.2 (VCC), J1.1 (VCC), J2.1 (VCC), U1.12 (3V3), J4.3 (VCC), J7.2 (3V3)
J6 | Extension 5V/3V3/D8-D10 (Dupont) | 4 | D10 | A5 | EXT_D10 | U1.11 (D10)
J6 | Extension 5V/3V3/D8-D10 (Dupont) | 5 | D9 | A6 | EXT_D9 | U1.10 (D9)
J6 | Extension 5V/3V3/D8-D10 (Dupont) | 6 | D8 | A7 | EXT_D8 | U1.9 (D8)
J8 | Extension D0-D3 (Dupont) | 1 | D0 | N2 | EXT_D0 | U1.1 (D0)
J8 | Extension D0-D3 (Dupont) | 2 | D1 | N3 | EXT_D1 | U1.2 (D1)
J8 | Extension D0-D3 (Dupont) | 3 | D2 | N4 | EXT_D2 | U1.3 (D2)
J8 | Extension D0-D3 (Dupont) | 4 | D3 | N5 | EXT_D3 | U1.4 (D3)
J7 | Modulino Knob (I2C, câble) | 1 | GND | N7 | GND | J3.1 (GND), J1.2 (GND), J2.2 (GND), U1.13 (GND), J4.2 (GND), J6.2 (GND)
J7 | Modulino Knob (I2C, câble) | 2 | 3V3 | N8 | +3V3 | J3.2 (VCC), J1.1 (VCC), J2.1 (VCC), U1.12 (3V3), J4.3 (VCC), J6.3 (3V3)
J7 | Modulino Knob (I2C, câble) | 3 | SDA | N9 | I2C_SDA | J3.4 (SDA), J1.4 (SDA), J2.4 (SDA), U1.5 (D4)
J7 | Modulino Knob (I2C, câble) | 4 | SCL | N10 | I2C_SCL | J3.3 (SCL), J1.3 (SCL), J2.3 (SCL), U1.6 (D5)

## Fils et ponts

Fil | Face | Net | Type | Trajet (coins)
P01 | dessous | I2C_SDA | rail nu | I1 > I19 > E19 > E20
P02 | dessous | I2C_SDA | nu | N9 > I9
P03 | dessous | I2C_SDA | isolé | N15 > (14.5;15) > (14.5;16.5) > (11;16.5) > K16 > I16
P04 | dessous | I2C_SCL | rail nu | H1 > H18 > D18 > D20
P05 | dessous | I2C_SCL | isolé | K7 > (11.5;7) > (11.5;8.5) > (8.5;8.5) > (8.5;9) > H9
P06 | dessous | I2C_SCL | isolé | N10 > N12 > (9.5;12) > (9.5;12.5) > (8.5;12.5) > (8.5;13) > H13
P07 | dessous | I2C_SCL | nu | N16 > L16 > L12
P08 | dessous | GND | rail nu | F1 > F17 > C17 > C20
P09 | dessous | GND | nu | E3 > F3
P10 | dessous | GND | nu | A3 > C3
P11 | dessous | GND | nu | A11 > F11
P12 | dessous | GND | isolé | N7 > (13.5;7) > (13.5;8.5) > (14.5;8.5) > (14.5;9.5) > (6.5;9.5) > (6.5;10) > F10
P13 | dessous | GND | isolé | N17 > (9.5;17) > (9.5;17.5) > (6;17.5) > F17
P14 | dessous | +3V3 | rail nu | G1 > G16
P15 | dessous | +3V3 | isolé | E4 > (5;4.5) > (6.5;4.5) > (6.5;5) > G5
P16 | dessous | +3V3 | nu | A4 > C4
P17 | dessous | +3V3 | isolé | A10 > (0.5;10) > (0.5;4.5) > (2;4.5) > B4
P18 | dessous | +3V3 | isolé | N8 > (14.5;8) > (14.5;1) > (9.5;1) > (9.5;0.5) > (7.5;0.5) > (7.5;2) > G2
P19 | dessous | +3V3 | isolé | B20 > B16 > (5.5;16) > (5.5;15.5) > (6.5;15.5) > (6.5;15) > G15
P20 | dessous | +3V3 | isolé | N18 > J18 > (10;20.5) > (2.5;20.5) > (2.5;19) > B19
P21 | dessous | VBUS_USB | nu | C2 > A2
P22 | dessous | GNSS_TX | isolé | K8 > (12.5;8) > (12.5;11.5) > (5;11.5) > E12 > A12
P23 | dessous | GNSS_RX | nu | C8 > A8 > A9
P24 | dessous | EXT_D0 | nu | N2 > K2
P25 | dessous | EXT_D1 | nu | N3 > K3
P26 | dessous | EXT_D2 | nu | N4 > K4
P27 | dessous | EXT_D3 | nu | N5 > K5
P28 | dessous | EXT_D8 | nu | C7 > A7
P29 | dessous | EXT_D9 | nu | C6 > A6
P30 | dessous | EXT_D10 | nu | C5 > A5
S01 | dessus | EXT_D0 | pont de soudure | J2 > K2
S02 | dessus | EXT_D1 | pont de soudure | J3 > K3
S03 | dessus | EXT_D2 | pont de soudure | J4 > K4
S04 | dessus | EXT_D3 | pont de soudure | J5 > K5
S05 | dessus | I2C_SDA | pont de soudure | J6 > I6
S06 | dessus | I2C_SCL | pont de soudure | J7 > K7
S07 | dessus | GNSS_TX | pont de soudure | J8 > K8
S08 | dessus | GNSS_RX | pont de soudure | D8 > C8
S09 | dessus | EXT_D8 | pont de soudure | D7 > C7
S10 | dessus | EXT_D9 | pont de soudure | D6 > C6
S11 | dessus | EXT_D10 | pont de soudure | D5 > C5
S12 | dessus | +3V3 | pont de soudure | C4 > E4
S13 | dessus | GND | pont de soudure | C3 > E3
S14 | dessus | VBUS_USB | pont de soudure | D2 > C2
