hugoprigent/FieldMind/software/rover/deploiement/calibration/damier_9x6_25mm_A4.pdf

100 mm : a verifier a la regle FieldMind - mire de calibration stereo : 9 x 6 coins interieurs, cases de 25 mm. Imprimer a 100 % (taille reelle), coller sur un carton bien plat.
