hugoprigent/FieldMind/hardware/electronics/systeme_rover/exports/schema_rover_complet.pdf

1 | 2 | 3 | 4 | 5 | 6 | 7 | 8

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
### F Date: 2026-10-13

KiCad E.D.A. 10.0.6 | Id: 1/4
Size: A3 | Rev: S1 / non testé

## Title: FieldMind rover prototype / schéma électrique complet

### File: fieldmind_rover_systeme.kicad_sch

### Sheet: /

### FieldMind

### Schéma de câblage du prototype : modules et liaisons, sans routage

### Batterie, contrôleur et moteurs du donneur E600 : à identifier au démontage

## Raspberry Pi et USB

File: pi_usb.kicad_sch

# Puissance et arrêt File: puissance_arret.kicad_sch

## Carte capteurs et périphériques

File: capteurs_peripheriques.kicad_sch

Arrêt d’urgence S2 (NF) + réarmement S3 → relais K1 (auto-maintien) → contacteur K2 de traction. Contact K1 21-24 → ESP D9.

## Puissance et arrêt : • Servo de direction DT996

## Étiquettes entre feuilles

Raspberry Pi et USB : | • RPLIDAR C1 + adaptateur (USB 2.0) | • Modulino Knob sur J7 • 2 webcams UGREEN (USB 3.0) • SERVO_PWM : J6.6 (D8) → signal du servo M3 • Batterie, BMS, chargeur, contrôleur et moteurs du E600 (type, tension, courants, commande, retours). • Calibres des fusibles F0-F4, section des câbles, tension DC des porte-fusibles ≥ tension max chargée.

Batterie E600 → F0 → S1 → bus. Branches fusiblées : XL4015 5,1 V (Pi), 6 V (servo), 12 V (commande), traction.

Pi 4 alimenté en USB-C. USB 3.0 : 2 webcams. USB 2.0 : lidar C1 (via son adaptateur) et XIAO de la carte capteurs.

XIAO ESP32C5 + OLED + GY-521 + BMP280 sur la perfboard A7. J4 → GPS, J7 → Knob, J6 → servo (D8) et état d’arrêt (D9). • USB_XIAO : port USB 2.0 n°2 du Pi → USB-C du XIAO • Contrôleur et moteurs du E600 • Arrêt d’urgence, relais, contacteur | • Raspberry Pi 4 (USB-C 5,1 V) • Liaison USB vers le XIAO

# FIELDMIND · ROVER PROTOTYPE · SCHÉMA ÉLECTRIQUE COMPLET

### - 3 × XL4015 (5,1 V / 6 V / 12 V)

Vue d’ensemble. Les trois feuilles détaillent le câblage ; les étiquettes globales relient les feuilles. • Batterie, fusibles, interrupteur général • +5V_PI : XL4015 n°1 → USB-C du Pi • Réglage des XL4015 à vide puis en charge avant de brancher Pi, servo ou relais. • ARRET_OK : contact K1 21-24 → J6.5 (D9), fermé vers GND = chaîne disponible • Rien n’a été essayé physiquement. • Brochage du GPS reçu ; signal 3,3 V reconnu par le servo ; bilan USB du Pi.

À relever avant câblage définitif | • Servo (D8) et état d’arrêt (D9) sur J6 • J8 réservé (retours roues) • Carte A7 : XIAO, OLED, GY-521, BMP280 • GPS ATGM336H sur J4

## Carte capteurs :

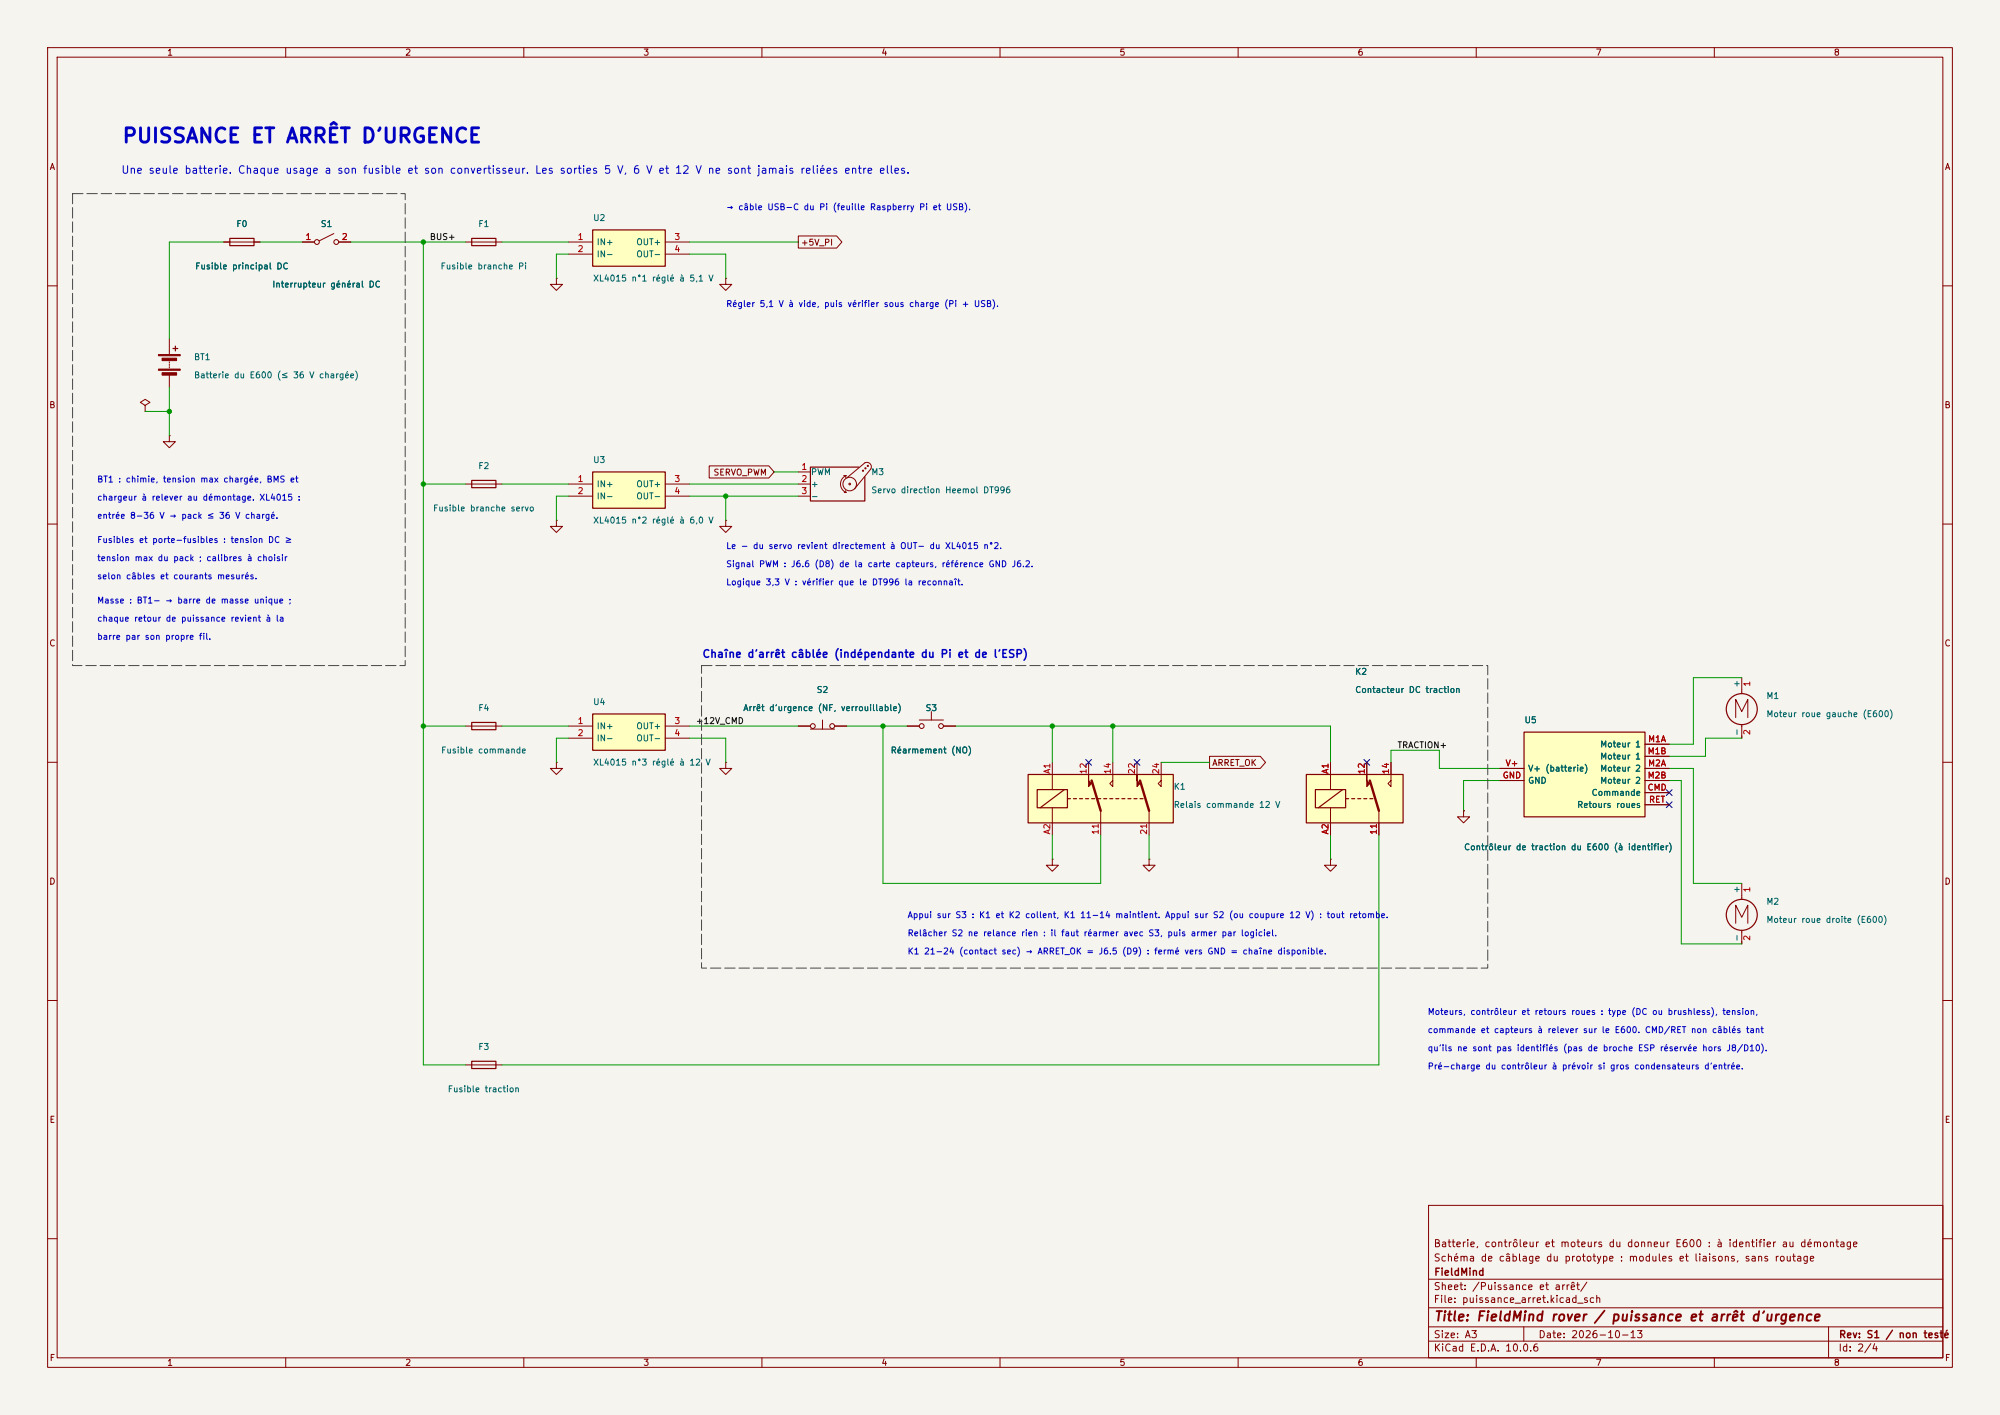
[picture p117: page 2]

PUISSANCE ET ARRÊT D’URGENCE

Régler 5,1 V à vide, puis vérifier sous charge (Pi + USB). entrée 8-36 V → pack ≤ 36 V chargé.

U5 Contrôleur de traction du E600 (à identifier) SERVO_PWM

chargeur à relever au démontage. XL4015 : tension max du pack ; calibres à choisir Fusibles et porte-fusibles : tension DC ≥

Chaîne d’arrêt câblée (indépendante du Pi et de l’ESP) K1 21-24 (contact sec) → ARRET_OK = J6.5 (D9) : fermé vers GND = chaîne disponible. Relâcher S2 ne relance rien : il faut réarmer avec S3, puis armer par logiciel.

Arrêt d’urgence (NF, verrouillable)

qu’ils ne sont pas identifiés (pas de broche ESP réservée hors J8/D10). commande et capteurs à relever sur le E600. CMD/RET non câblés tant

Batterie, contrôleur et moteurs du donneur E600 : à identifier au démontage
Schéma de câblage du prototype : modules et liaisons, sans routage
FieldMind
Sheet: /Puissance et arrêt/
File: puissance_arret.kicad_sch
Title: FieldMind rover / puissance et arrêt d’urgence

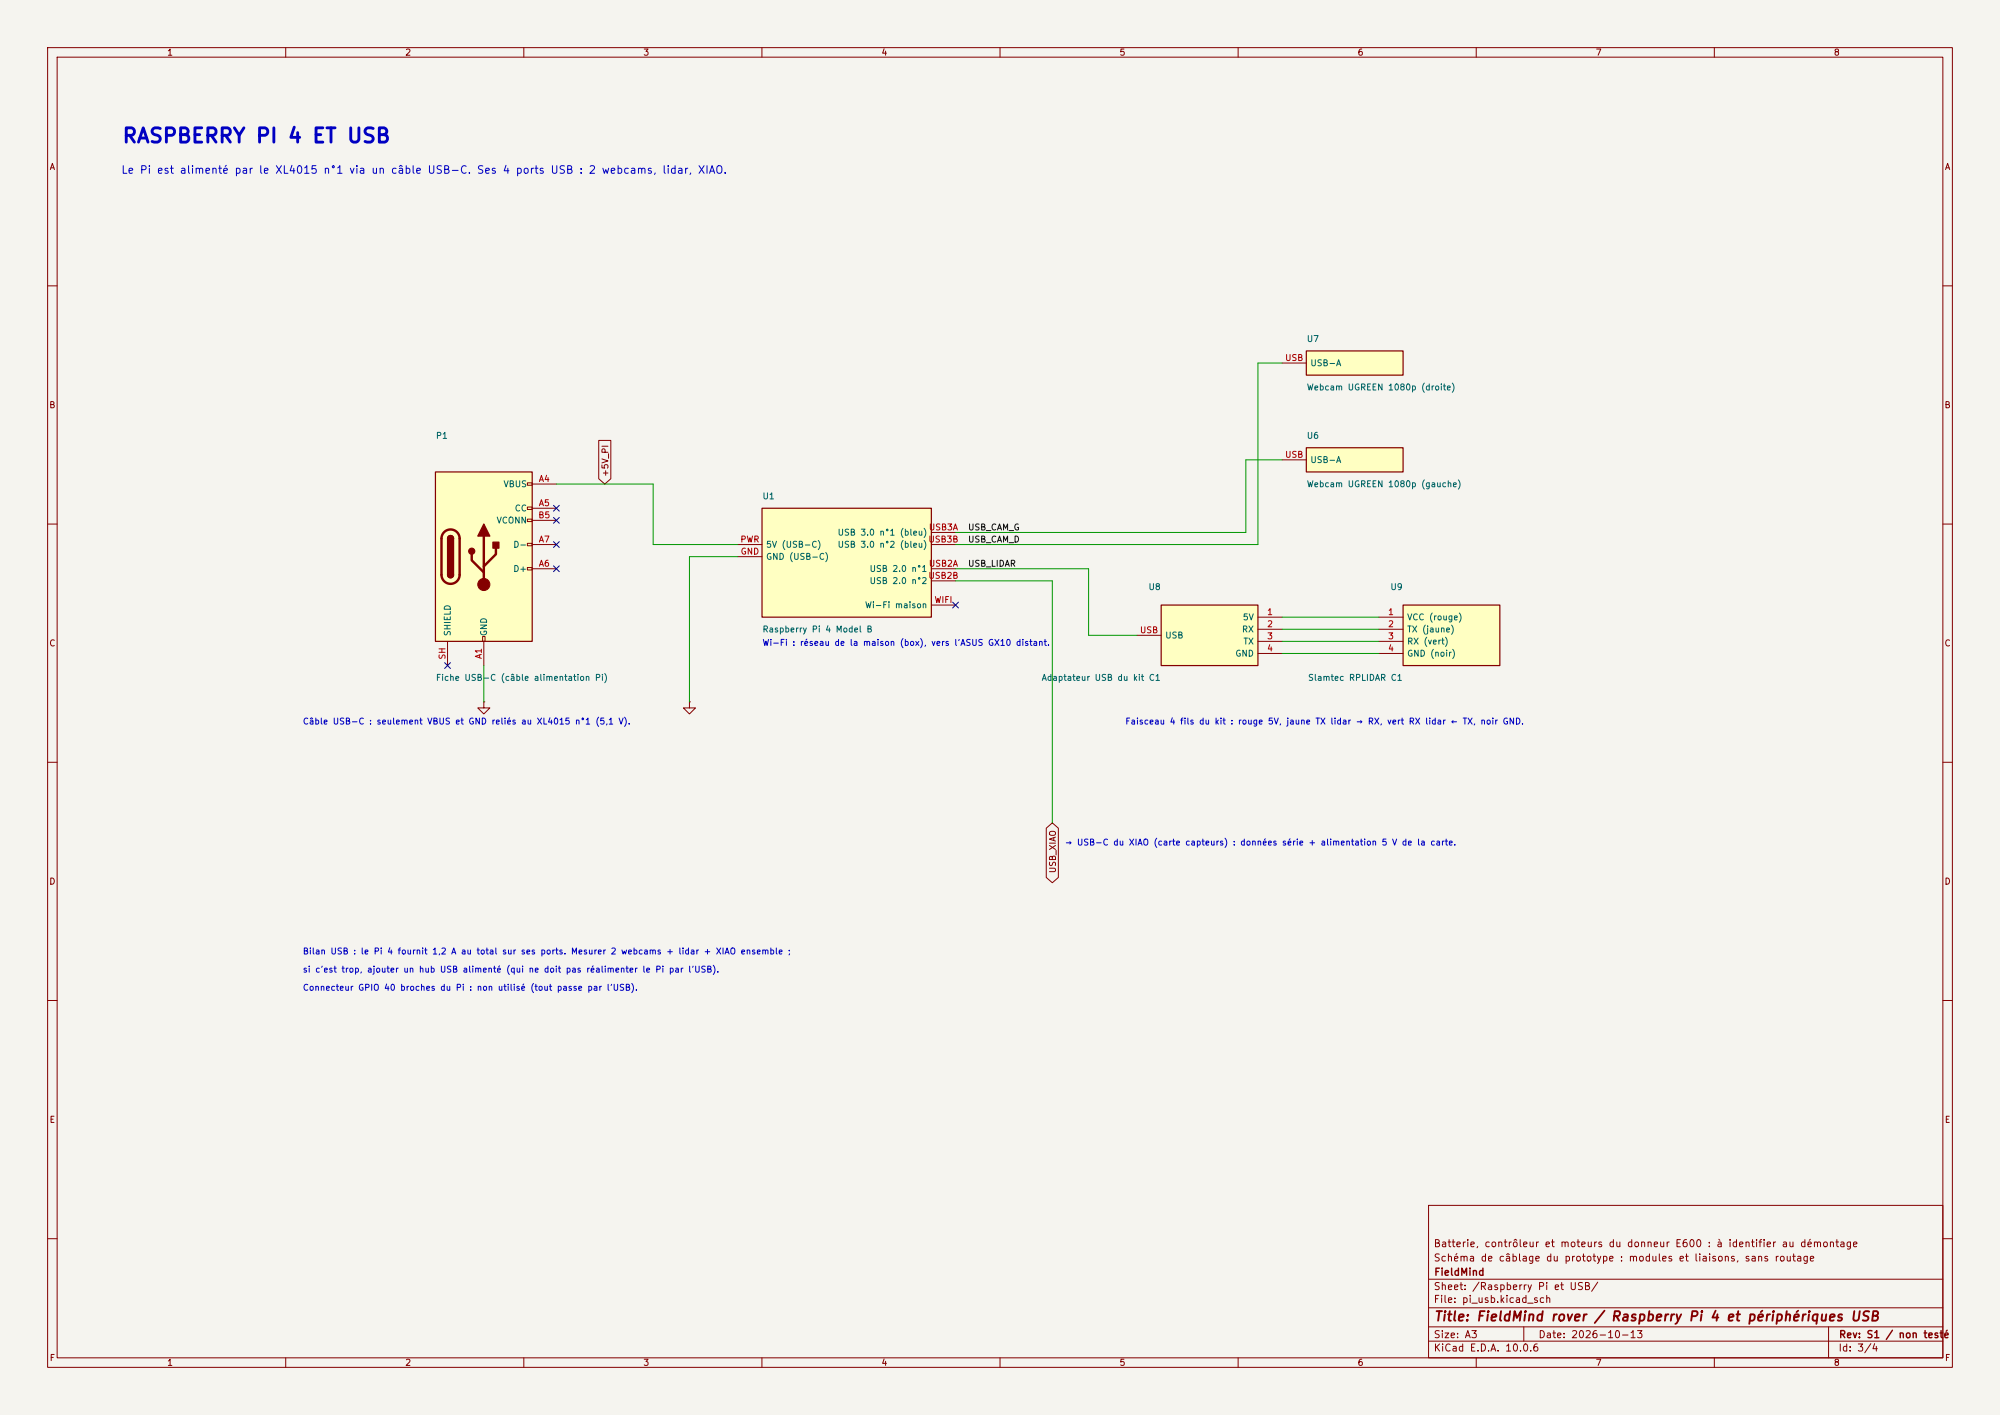
[picture p118: page 3]

RASPBERRY PI 4 ET USB

Batterie, contrôleur et moteurs du donneur E600 : à identifier au démontage GND A1

Fiche USB-C (câble alimentation Pi)

Schéma de câblage du prototype : modules et liaisons, sans routage
FieldMind
Sheet: /Raspberry Pi et USB/
File: pi_usb.kicad_sch
Title: FieldMind rover / Raspberry Pi 4 et périphériques USB

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
## Title: FieldMind rover / carte capteurs A7 et périphériques

### File: capteurs_peripheriques.kicad_sch

### Sheet: /Carte capteurs et périphériques/

### FieldMind

### Schéma de câblage du prototype : modules et liaisons, sans routage

### Batterie, contrôleur et moteurs du donneur E600 : à identifier au démontage

GND 1
3.3V 2
SDA 3
SCL 4 U11

Arduino Modulino Knob (I2C 0x3A)

J4.1 RX_GPS (D6) | J4.1
J4.2 GND | J4.2
J4.3 3V3 | J4.3
J4.4 TX_GPS (D7) | J4.4
J6.1 5V USB | J6.1
J6.2 GND | J6.2
J6.3 3V3 | J6.3
J6.4 D10 | J6.4
J6.5 D9 | J6.5
J6.6 D8 | J6.6
J7.1 GND | J7.1
J7.2 3V3 | J7.2
J7.3 SDA (D4) | J7.3
J7.4 SCL (D5) | J7.4
J8.1 D0 | J8.1
J8.2 D1 | J8.2
J8.3 D2 | J8.3
J8.4 D3 | J8.4 USB-C du XIAO USB
A1Carte capteurs A7 (XIAO ESP32C5 + OLED + GY-521 + BMP280) | GND GND
PPS PPS | RXD RXD
TXD TXD | VCC VCC U10 GPS ATGM336H (AYWHP) + antenne USB_XIAO

ARRET_OK
SERVO_PWM

GND

3V3_XIAO

3V3_XIAO

GND

GND USB-C : Pi USB 2.0 n°2 détail broche par broche dans ../carte_capteurs/cad/perfboard_c5_a7. Ici : ce qui se branche sur ses connecteurs.

# CARTE CAPTEURS A7 ET PÉRIPHÉRIQUES

J6.5 D9 ← contact K1 21-24 (tirage interne, bas = chaîne d’arrêt disponible). Ordre des broches du module à lire sur l’exemplaire reçu. La carte A7 (perfboard 4 × 6 cm) porte le XIAO ESP32C5, l’écran OLED, le GY-521 et le BMP280 :

SDA/SCL de J7 avec l’OLED, le GY-521 et le BMP280. Adresses I2C attendues : OLED 0x3C, GY-521 0x68, BMP280 0x76, Knob 0x3A. Dans la carte, les broches de même nom sont reliées : GND (J4.2, J6.2, J7.1), 3V3 (J4.3, J6.3, J7.2),

J6.1 5V, J6.3 3V3, J6.4 D10 : libres pour un futur capteur. J8 (D0-D3) : réservé aux retours roues ou à la commande du contrôleur de traction, | Câble Qwiic → Dupont, ou fils soudés sur les pastilles 1×4 du Knob, même ordre. à affecter après démontage du E600. D2/D3 : broches de démarrage (rien qui les force à l’allumage). Antenne dégagée vers le ciel, loin du Pi et du lidar. J6.6 D8 → signal du servo M3 ; J6.2 GND : référence (un fil le long du signal). TX du GPS → TX_GPS (J4.4, D7) ; RX du GPS ← RX_GPS (J4.1, D6). PPS non utilisé. A1Carte capteurs A7 (XIAO ESP32C5 + OLED + GY-521 + BMP280)
J4.1 RX_GPS (D6) | J4.1
J4.2 GND | J4.2
J4.3 3V3 | J4.3
J4.4 TX_GPS (D7) | J4.4
J6.1 5V USB | J6.1
J6.2 GND | J6.2
J6.3 3V3 | J6.3
J6.4 D10 | J6.4
J6.5 D9 | J6.5
J6.6 D8 | J6.6
J7.1 GND | J7.1
J7.2 3V3 | J7.2
J7.3 SDA (D4) | J7.3
J7.4 SCL (D5) | J7.4
J8.1 D0 | J8.1
J8.2 D1 | J8.2
J8.3 D2 | J8.3
J8.4 D3 | J8.4 USB-C du XIAO USB
