hugoprigent/FieldMind/hardware/electronics/carte_capteurs/cad/perfboard_c5_a7/fieldmind_c5_a7.kicad_pcb

## KiCad design hardware/electronics/carte_capteurs/cad/perfboard_c5_a7/fieldmind_c5_a7.kicad_pcb (2026-10-20)

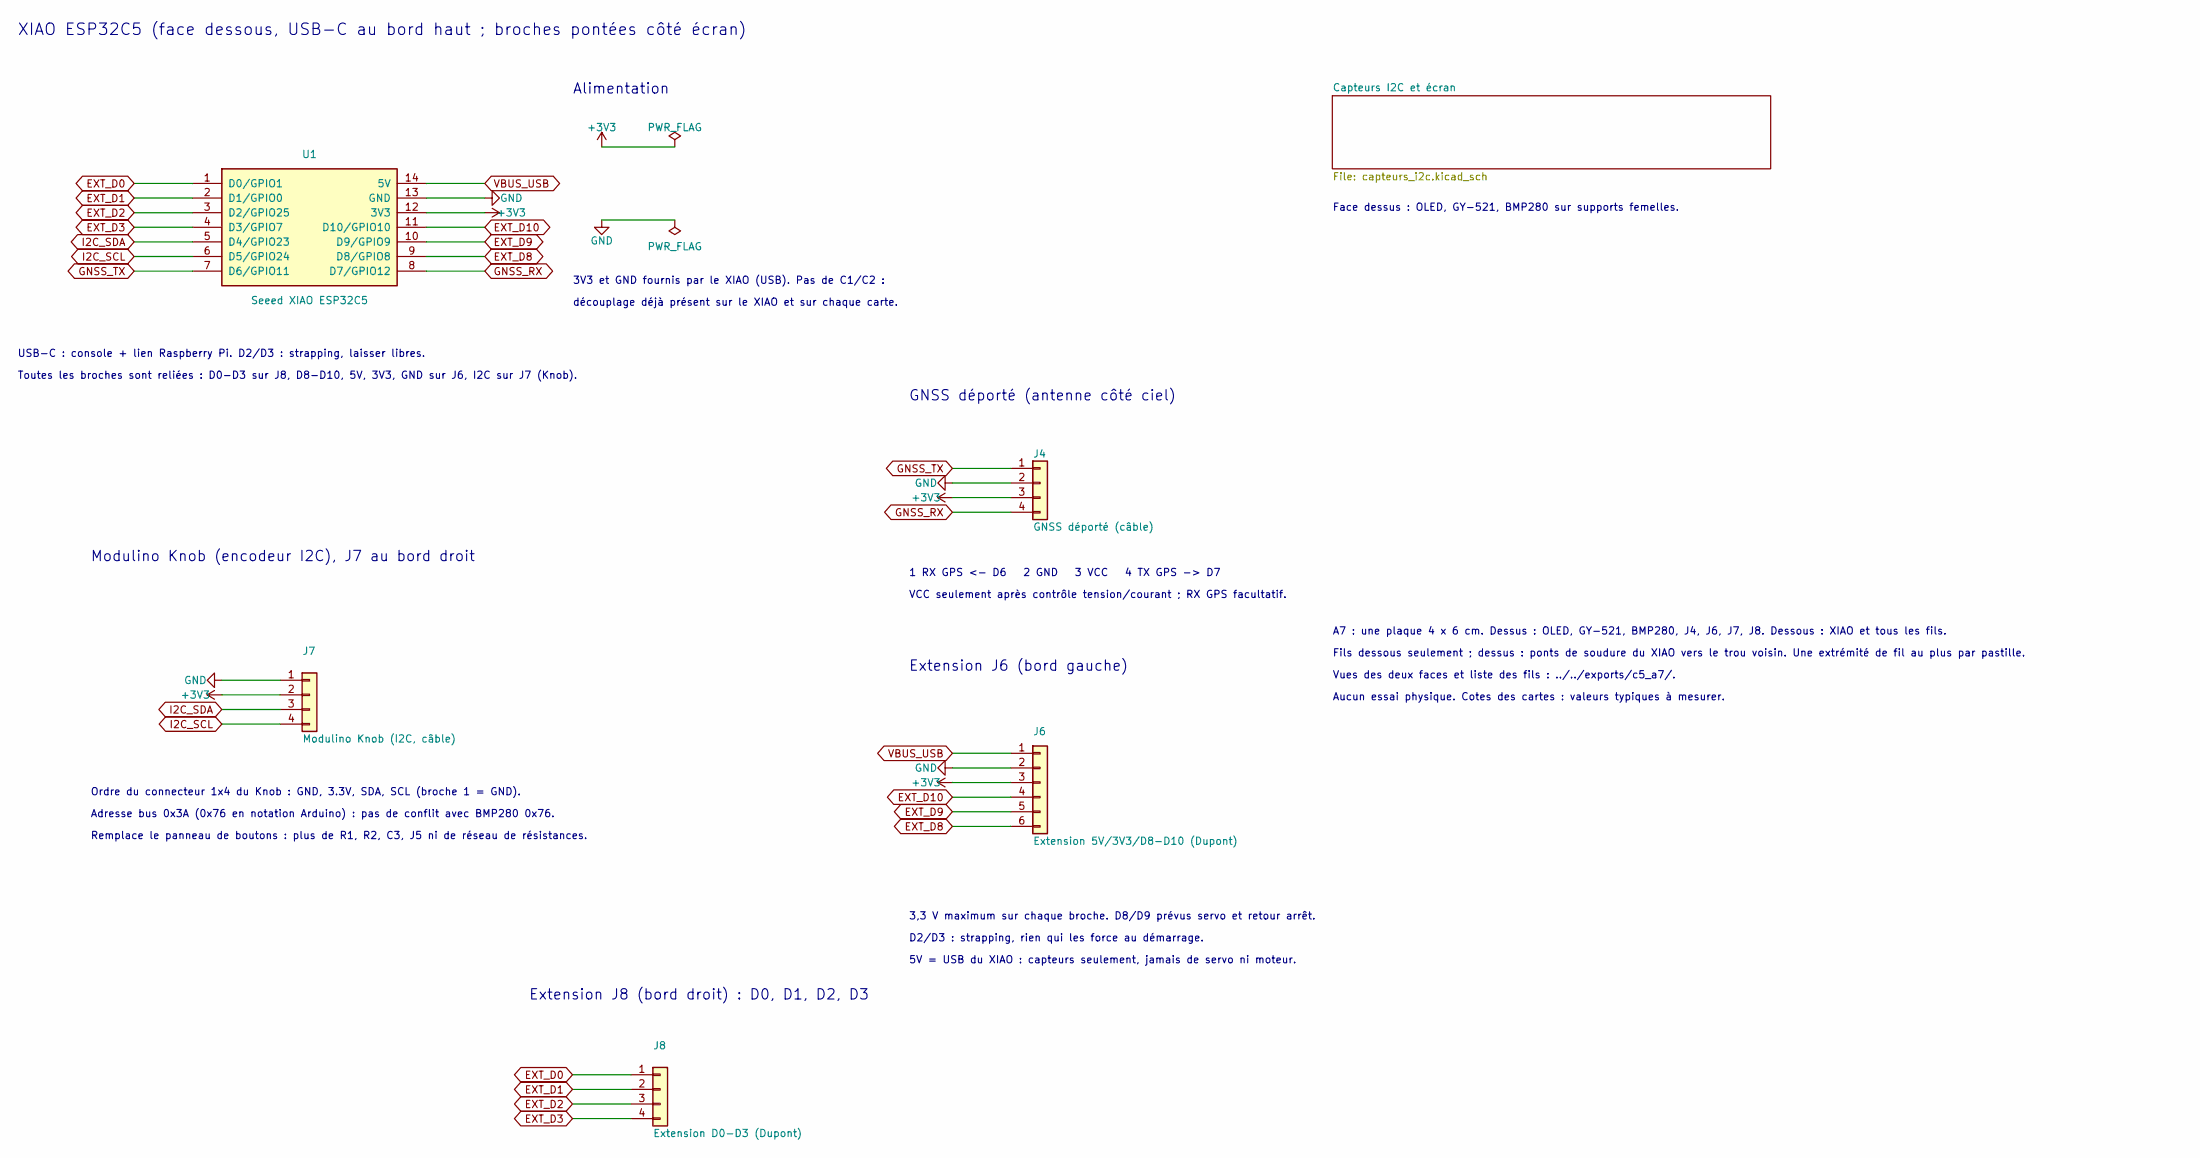
[picture p119: schematic fieldmind_c5_a7.kicad_sch, FieldMind C5 A7 / plaque unique : XIAO, GNSS, Knob, extensi…]

Parts:
J4: GNSS déporté (câble); A7_J4
J6: Extension 5V/3V3/D8-D10 (Dupont); A7_J6
J7: Modulino Knob (I2C, câble); A7_J7
J8: Extension D0-D3 (Dupont); A7_J8
U1: Seeed XIAO ESP32C5; A7_U1

Connections:
+3V3: J4.3 (VCC), J6.3 (3V3), J7.2 (3V3), U1.12 (3V3); also elsewhere on the board
EXT_D0: J8.1 (D0), U1.1 (D0); also elsewhere on the board
EXT_D1: J8.2 (D1), U1.2 (D1); also elsewhere on the board
EXT_D2: J8.3 (D2), U1.3 (D2); also elsewhere on the board
EXT_D3: J8.4 (D3), U1.4 (D3); also elsewhere on the board
EXT_D8: J6.6 (D8), U1.9 (D8); also elsewhere on the board
EXT_D9: J6.5 (D9), U1.10 (D9); also elsewhere on the board
EXT_D10: J6.4 (D10), U1.11 (D10); also elsewhere on the board
GND: J4.2 (GND), J6.2 (GND), J7.1 (GND), U1.13 (GND); also elsewhere on the board
GNSS_RX: J4.4 (TX_GPS), U1.8 (D7); also elsewhere on the board
GNSS_TX: J4.1 (RX_GPS), U1.7 (D6); also elsewhere on the board
I2C_SCL: J7.4 (SCL), U1.6 (D5); also elsewhere on the board
I2C_SDA: J7.3 (SDA), U1.5 (D4); also elsewhere on the board
VBUS_USB: J6.1 (5V), U1.14 (5V); also elsewhere on the board

Notes on the sheet:
Vues des deux faces et liste des fils : ../../exports/c5_a7/.
USB-C : console + lien Raspberry Pi. D2/D3 : strapping, laisser libres.
Aucun essai physique. Cotes des cartes : valeurs typiques à mesurer.
XIAO ESP32C5 (face dessous, USB-C au bord haut ; broches pontées côté écran)
VCC seulement après contrôle tension/courant ; RX GPS facultatif.
5V = USB du XIAO : capteurs seulement, jamais de servo ni moteur.
GNSS déporté (antenne côté ciel)
Extension J6 (bord gauche)
D2/D3 : strapping, rien qui les force au démarrage.
découplage déjà présent sur le XIAO et sur chaque carte.
Toutes les broches sont reliées : D0-D3 sur J8, D8-D10, 5V, 3V3, GND sur J6, I2C sur J7 (Knob).
Adresse bus 0x3A (0x76 en notation Arduino) : pas de conflit avec BMP280 0x76.
Alimentation
A7 : une plaque 4 x 6 cm. Dessus : OLED, GY-521, BMP280, J4, J6, J7, J8. Dessous : XIAO et tous les fils.
1 RX GPS <- D6 2 GND 3 VCC 4 TX GPS -> D7
3V3 et GND fournis par le XIAO (USB). Pas de C1/C2 :
Remplace le panneau de boutons : plus de R1, R2, C3, J5 ni de réseau de résistances.
Face dessus : OLED, GY-521, BMP280 sur supports femelles.
Fils dessous seulement ; dessus : ponts de soudure du XIAO vers le trou voisin. Une extrémité de fil au plus par pastille.
Modulino Knob (encodeur I2C), J7 au bord droit
Extension J8 (bord droit) : D0, D1, D2, D3
3,3 V maximum sur chaque broche. D8/D9 prévus servo et retour arrêt.
Ordre du connecteur 1x4 du Knob : GND, 3.3V, SDA, SCL (broche 1 = GND).

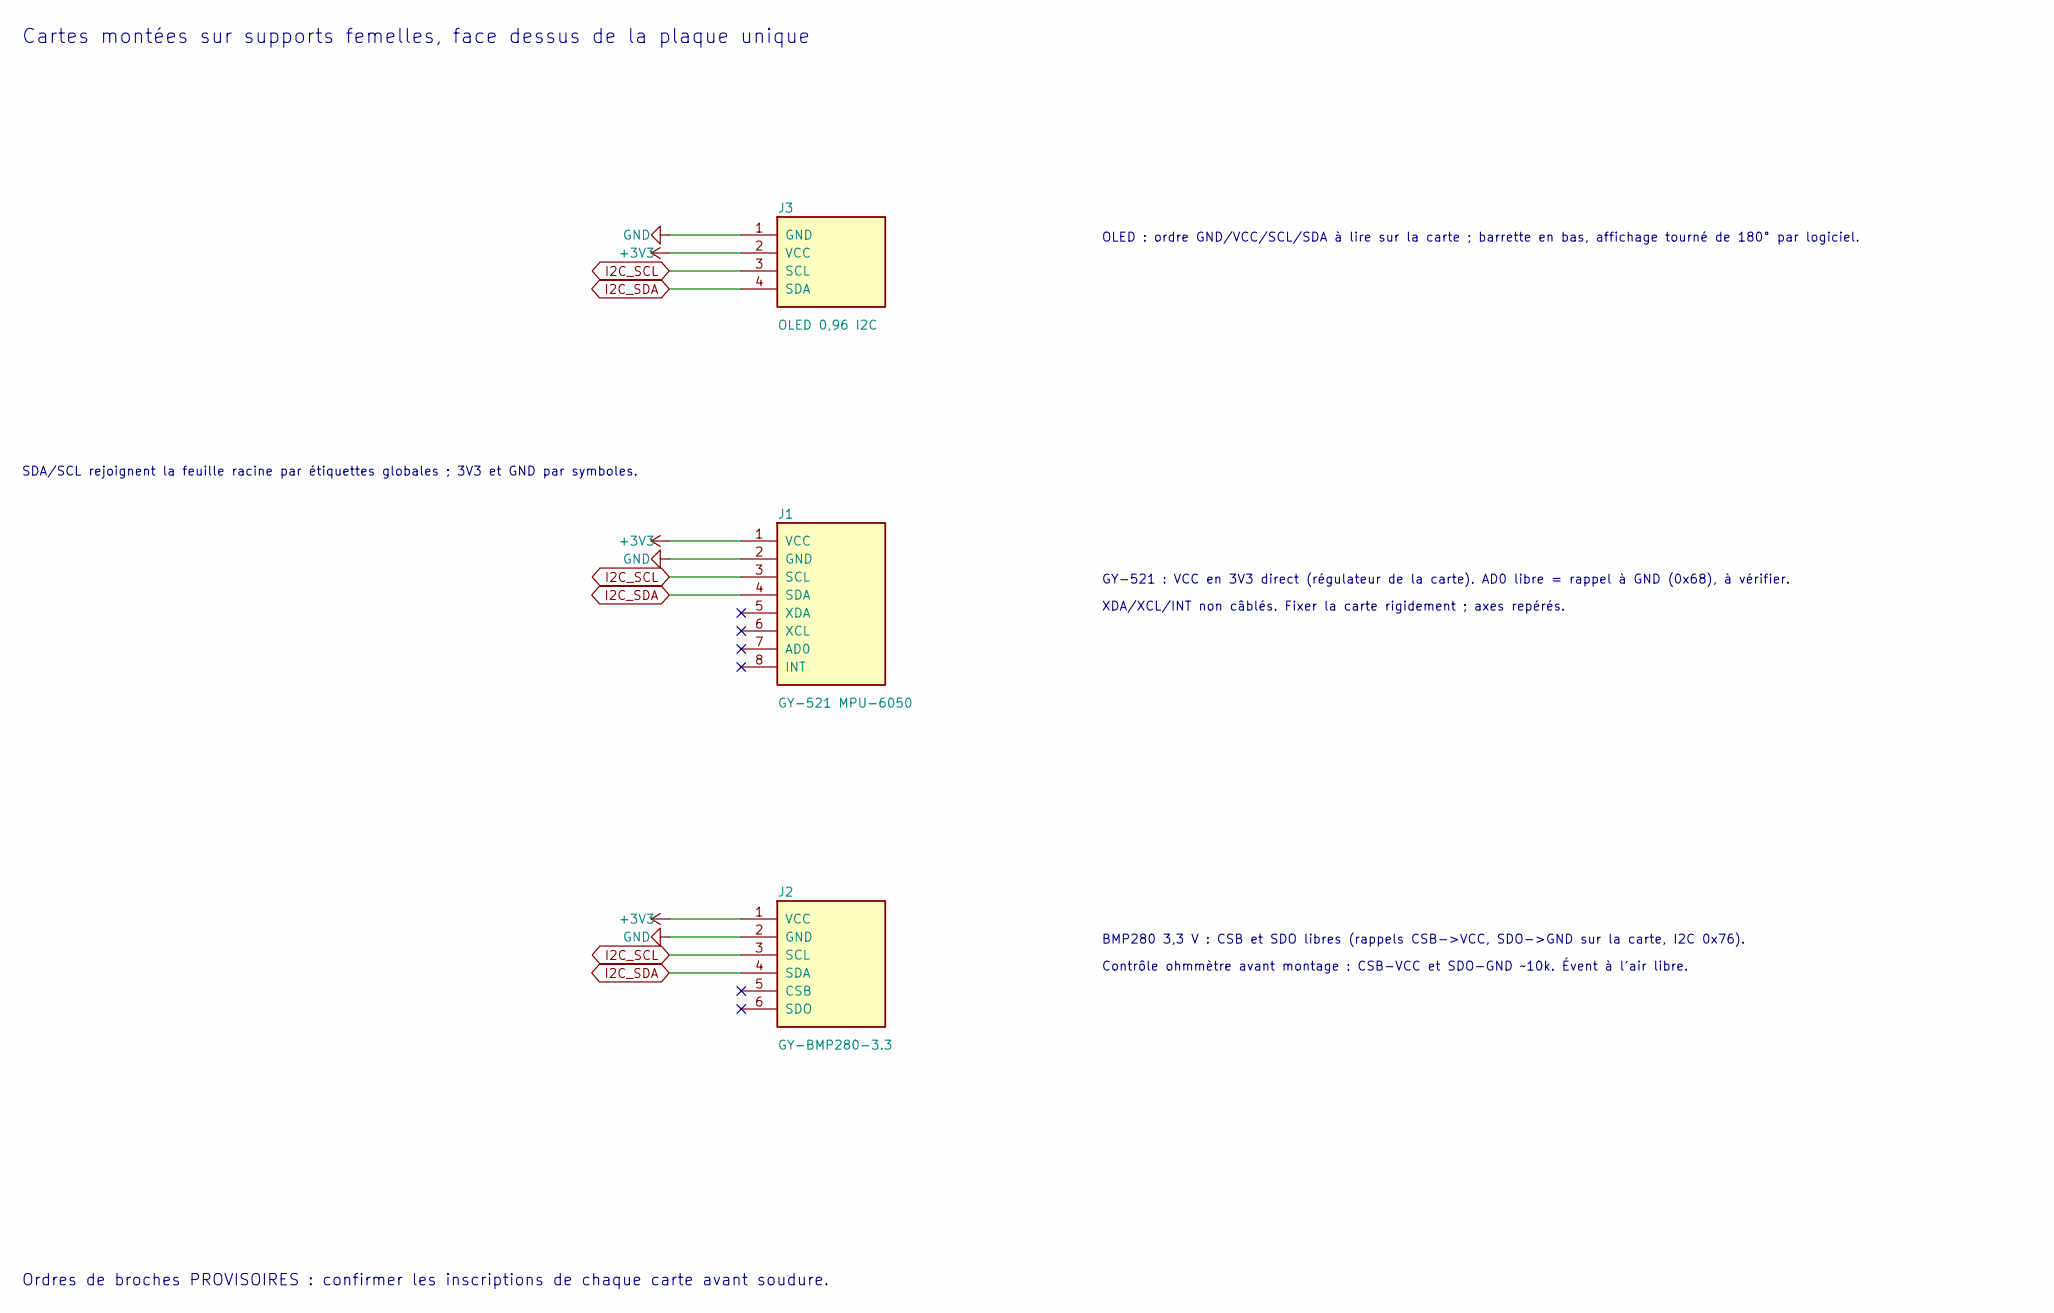
[picture p120: schematic capteurs_i2c.kicad_sch, FieldMind C5 A7 / capteurs I2C et écran (face dessus)]

Parts:
J1: GY-521 MPU-6050; A7_J1
J2: GY-BMP280-3.3; A7_J2
J3: OLED 0,96 I2C; A7_J3

Connections:
+3V3: J1.1 (VCC), J2.1 (VCC), J3.2 (VCC); also elsewhere on the board
GND: J1.2 (GND), J2.2 (GND), J3.1 (GND); also elsewhere on the board
I2C_SCL: J1.3 (SCL), J2.3 (SCL), J3.3 (SCL); also elsewhere on the board
I2C_SDA: J1.4 (SDA), J2.4 (SDA), J3.4 (SDA); also elsewhere on the board

Notes on the sheet:
Contrôle ohmmètre avant montage : CSB-VCC et SDO-GND ~10k. Évent à l’air libre.
BMP280 3,3 V : CSB et SDO libres (rappels CSB->VCC, SDO->GND sur la carte, I2C 0x76).
OLED : ordre GND/VCC/SCL/SDA à lire sur la carte ; barrette en bas, affichage tourné de 180° par logiciel.
SDA/SCL rejoignent la feuille racine par étiquettes globales ; 3V3 et GND par symboles.
Cartes montées sur supports femelles, face dessus de la plaque unique
Ordres de broches PROVISOIRES : confirmer les inscriptions de chaque carte avant soudure.
XDA/XCL/INT non câblés. Fixer la carte rigidement ; axes repérés.
GY-521 : VCC en 3V3 direct (régulateur de la carte). AD0 libre = rappel à GND (0x68), à vérifier.

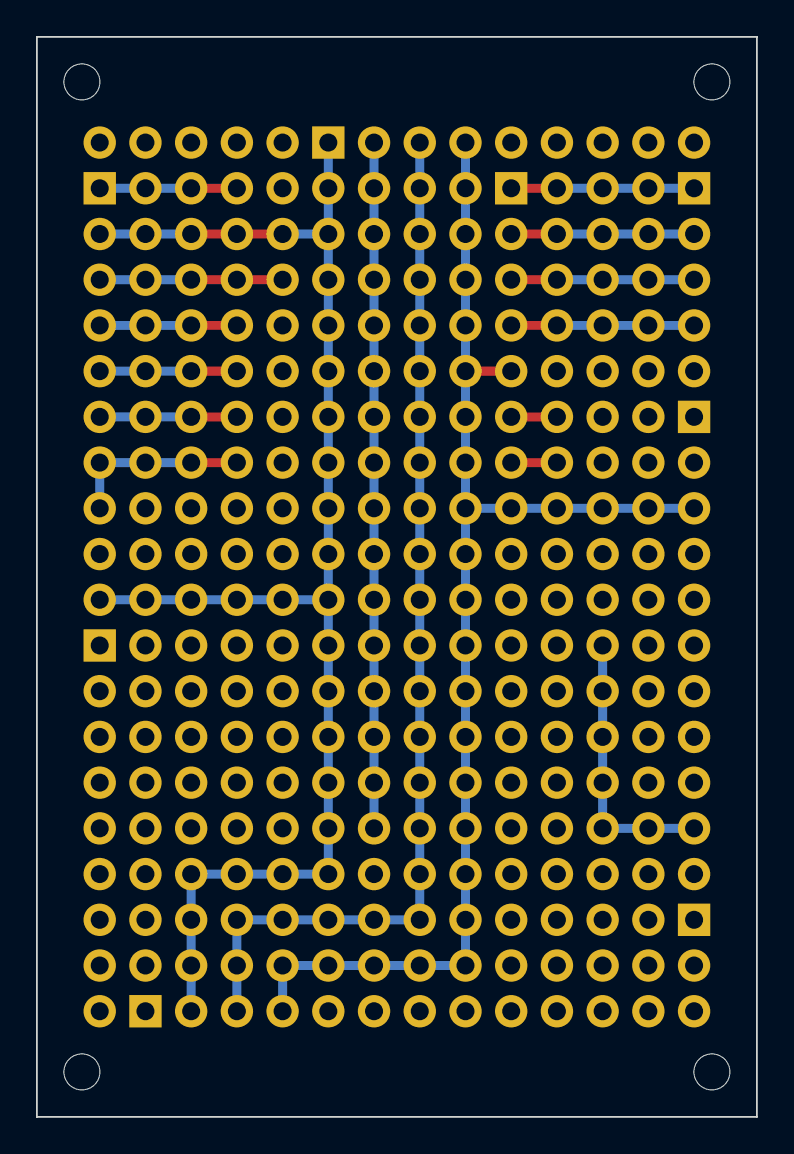
[picture p121: board fieldmind_c5_a7.kicad_pcb from above]

Board: 4 copper layers, 40.0 x 60.0 mm, 9 parts (1 on the bottom side), 14 nets.

Other parts of the board:
PL1: Perfboard 4x6 cm 14x20 trous, double face; A7_PERF

Their connections:
+3V3: PL1.B4, PL1.B16, PL1.B17, PL1.B18, PL1.B19, PL1.C4, PL1.C16, PL1.D16, PL1.E4, PL1.E16, PL1.G2, PL1.G3, PL1.G4, PL1.G5, PL1.G6, PL1.G7, PL1.G8, PL1.G9, PL1.G10, PL1.G11, PL1.G12, PL1.G13, PL1.G14, PL1.G15, PL1.G16, PL1.J1, PL1.J18, PL1.J19, PL1.J20, PL1.K1, PL1.K18, PL1.L1, PL1.L18, PL1.M1, PL1.M18, PL1.N1; also elsewhere on the board
EXT_D0: PL1.K2, PL1.L2, PL1.M2; also elsewhere on the board
EXT_D1: PL1.K3, PL1.L3, PL1.M3; also elsewhere on the board
EXT_D2: PL1.K4, PL1.L4, PL1.M4; also elsewhere on the board
EXT_D3: PL1.K5, PL1.L5, PL1.M5; also elsewhere on the board
EXT_D8: PL1.B7, PL1.C7; also elsewhere on the board
EXT_D9: PL1.B6, PL1.C6; also elsewhere on the board
EXT_D10: PL1.B5, PL1.C5; also elsewhere on the board
GND: PL1.B3, PL1.B11, PL1.C3, PL1.C11, PL1.C17, PL1.C18, PL1.C19, PL1.D11, PL1.D17, PL1.E3, PL1.E11, PL1.E17, PL1.F2, PL1.F3, PL1.F4, PL1.F5, PL1.F6, PL1.F7, PL1.F8, PL1.F9, PL1.F10, PL1.F11, PL1.F12, PL1.F13, PL1.F14, PL1.F15, PL1.F16, PL1.F17, PL1.J17, PL1.K17, PL1.L17, PL1.M17; also elsewhere on the board
GNSS_RX: PL1.A8, PL1.B8, PL1.C8; also elsewhere on the board
GNSS_TX: PL1.B12, PL1.C12, PL1.D12, PL1.E12, PL1.K8, PL1.L8; also elsewhere on the board
I2C_SCL: PL1.D18, PL1.D19, PL1.E18, PL1.F18, PL1.G18, PL1.H2, PL1.H3, PL1.H4, PL1.H5, PL1.H6, PL1.H7, PL1.H8, PL1.H9, PL1.H10, PL1.H11, PL1.H12, PL1.H13, PL1.H14, PL1.H15, PL1.H16, PL1.H17, PL1.H18, PL1.J12, PL1.K7, PL1.K12, PL1.L12, PL1.L13, PL1.L14, PL1.L15, PL1.L16, PL1.M12, PL1.M16, PL1.N11, PL1.N12; also elsewhere on the board
I2C_SDA: PL1.E19, PL1.F19, PL1.G19, PL1.H19, PL1.I2, PL1.I3, PL1.I4, PL1.I5, PL1.I6, PL1.I7, PL1.I8, PL1.I9, PL1.I10, PL1.I11, PL1.I12, PL1.I13, PL1.I14, PL1.I15, PL1.I16, PL1.I17, PL1.I18, PL1.I19, PL1.J9, PL1.J16, PL1.K9, PL1.K16, PL1.L9, PL1.M9; also elsewhere on the board
VBUS_USB: PL1.B2, PL1.C2; also elsewhere on the board
