hugoprigent/FieldMind/hardware/electronics/systeme_rover/cad/capteurs_peripheriques.kicad_sch

## KiCad design hardware/electronics/systeme_rover/cad/capteurs_peripheriques.kicad_sch (2026-10-20)

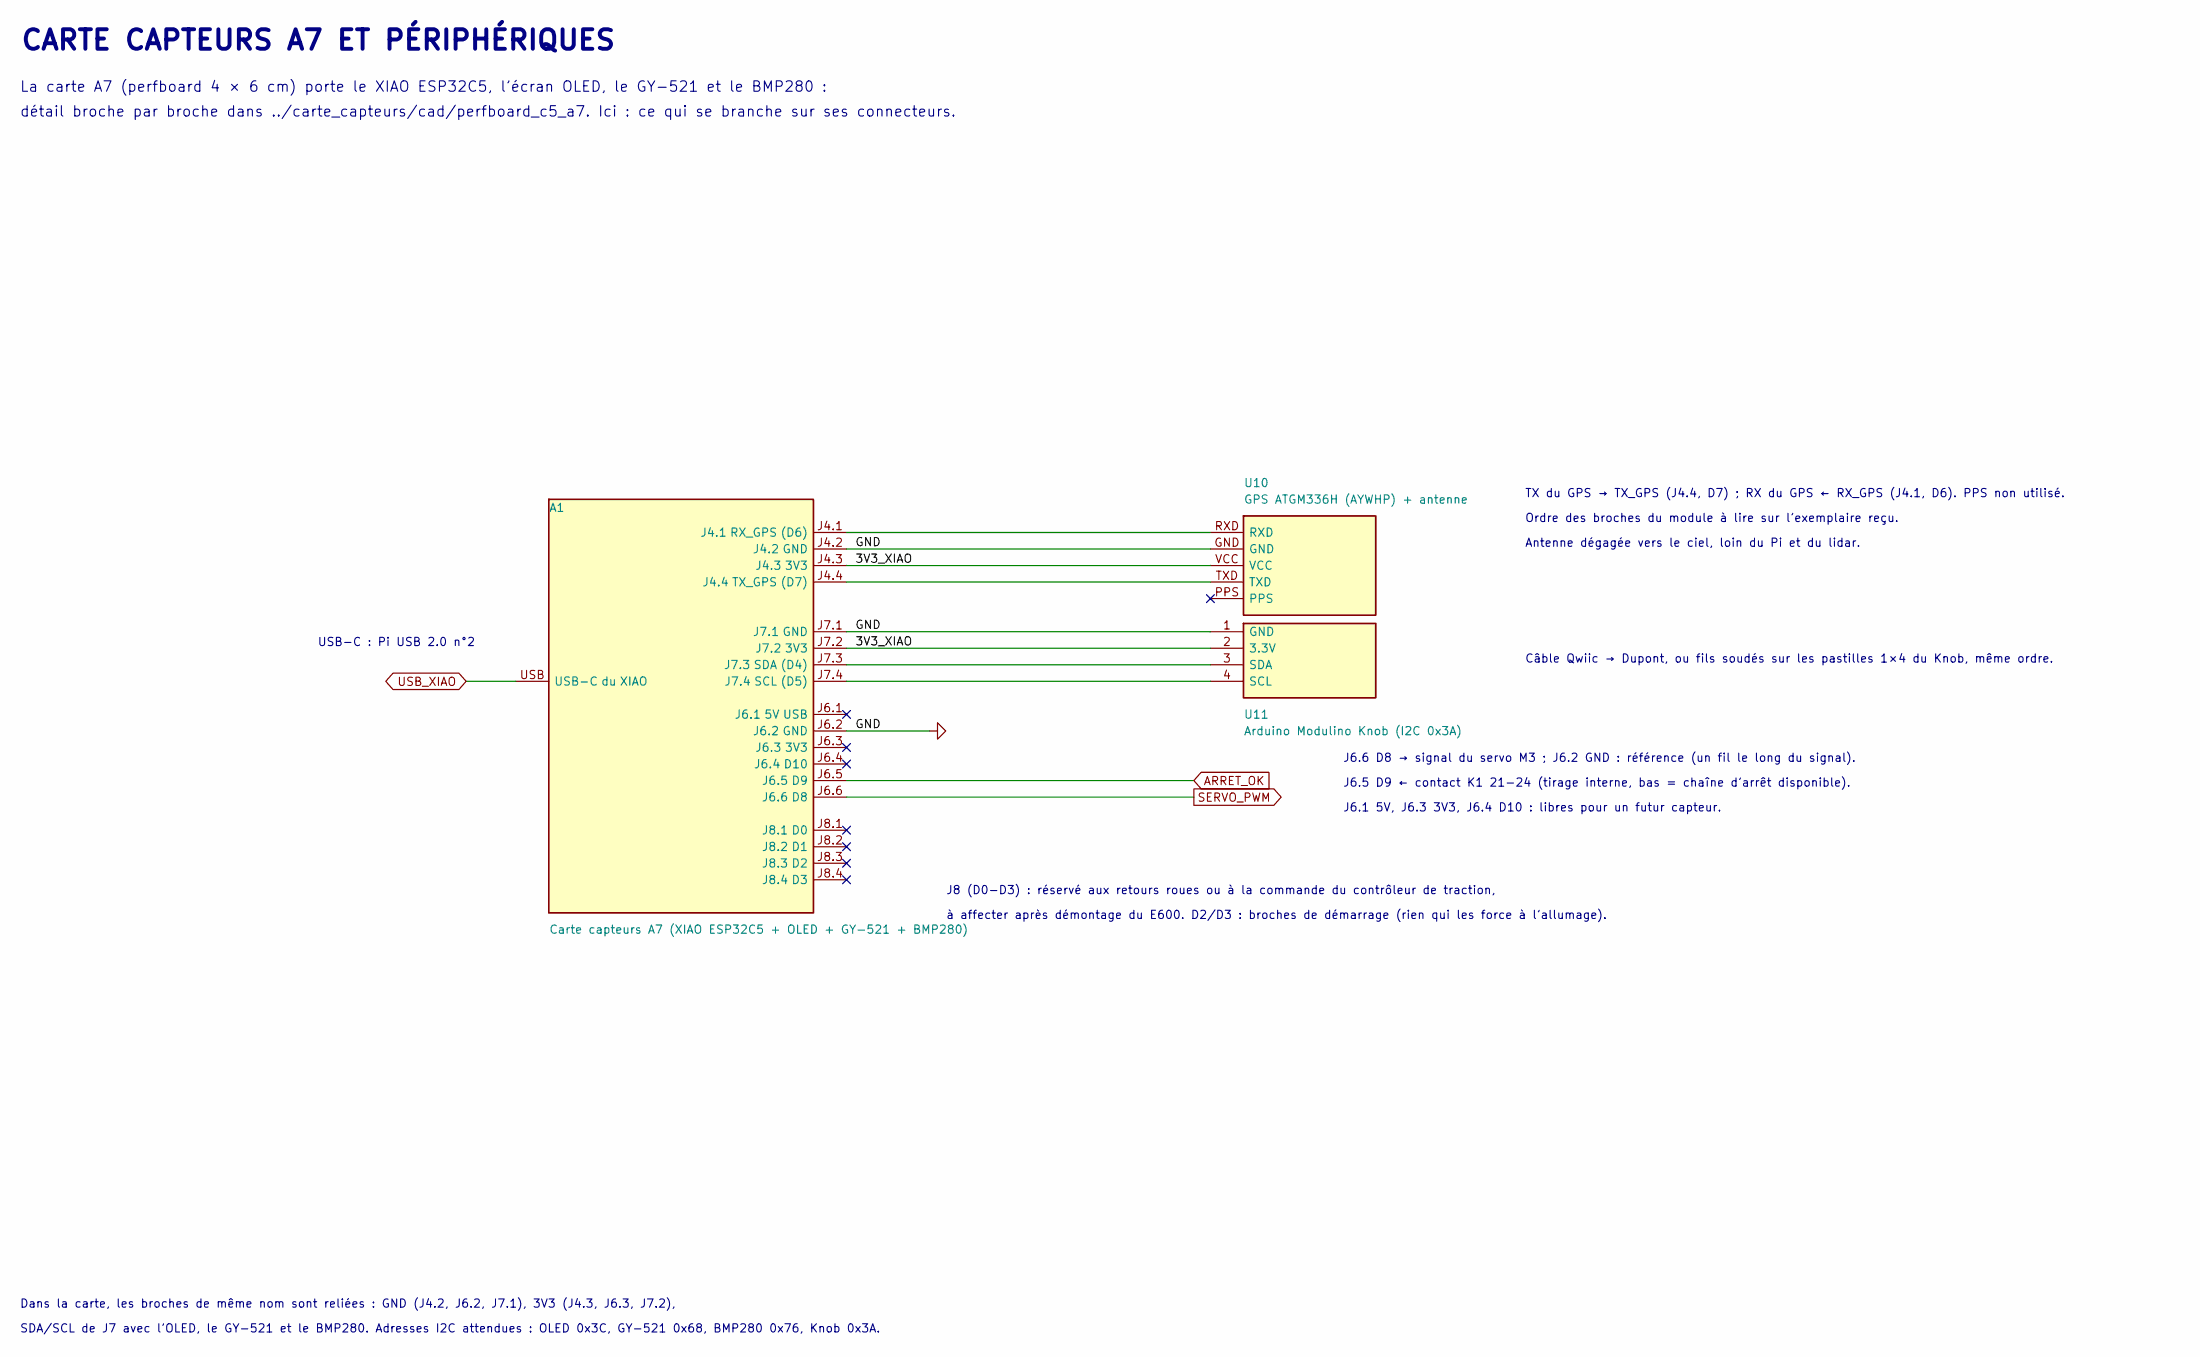
[picture p122: schematic capteurs_peripheriques.kicad_sch]

Parts:
A1: Carte capteurs A7 (XIAO ESP32C5 + OLED + GY-521 +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
U10: GPS ATGM336H (AYWHP) + antenne
U11: Arduino Modulino Knob (I2C 0x3A)

Connections:
3V3_XIAO: A1.J4.3 (J4.3 3V3), A1.J7.2 (J7.2 3V3), U10.VCC, U11.2 (3.3V)
ARRET_OK: A1.J6.5 (J6.5 D9)
GND: A1.J4.2 (J4.2 GND), A1.J6.2 (J6.2 GND), A1.J7.1 (J7.1 GND), U10.GND, U11.1 (GND)
unnamed: A1.J4.1 (J4.1 RX_GPS (D6)), U10.RXD
unnamed: A1.J4.4 (J4.4 TX_GPS (D7)), U10.TXD
unnamed: A1.J7.3 (J7.3 SDA (D4)), U11.3 (SDA)
unnamed: A1.J7.4 (J7.4 SCL (D5)), U11.4 (SCL)
SERVO_PWM: A1.J6.6 (J6.6 D8)
USB_XIAO: A1.USB (USB-C du XIAO)

Notes on the sheet:
USB-C : Pi USB 2.0 n°2
TX du GPS → TX_GPS (J4.4, D7) ; RX du GPS ← RX_GPS (J4.1, D6). PPS non utilisé.
J6.6 D8 → signal du servo M3 ; J6.2 GND : référence (un fil le long du signal).
La carte A7 (perfboard 4 × 6 cm) porte le XIAO ESP32C5, l’écran OLED, le GY-521 et le BMP280 :
Antenne dégagée vers le ciel, loin du Pi et du lidar.
J6.5 D9 ← contact K1 21-24 (tirage interne, bas = chaîne d’arrêt disponible).
Câble Qwiic → Dupont, ou fils soudés sur les pastilles 1×4 du Knob, même ordre.
Dans la carte, les broches de même nom sont reliées : GND (J4.2, J6.2, J7.1), 3V3 (J4.3, J6.3, J7.2),
SDA/SCL de J7 avec l’OLED, le GY-521 et le BMP280. Adresses I2C attendues : OLED 0x3C, GY-521 0x68, BMP280 0x76, Knob 0x3A.
J8 (D0-D3) : réservé aux retours roues ou à la commande du contrôleur de traction,
J6.1 5V, J6.3 3V3, J6.4 D10 : libres pour un futur capteur.
CARTE CAPTEURS A7 ET PÉRIPHÉRIQUES
Ordre des broches du module à lire sur l’exemplaire reçu.
à affecter après démontage du E600. D2/D3 : broches de démarrage (rien qui les force à l’allumage).
détail broche par broche dans ../carte_capteurs/cad/perfboard_c5_a7. Ici : ce qui se branche sur ses connecteurs.
