hugoprigent/FieldMind/hardware/electronics/systeme_rover/cad/pi_usb.kicad_sch

## KiCad design hardware/electronics/systeme_rover/cad/pi_usb.kicad_sch (2026-10-20)

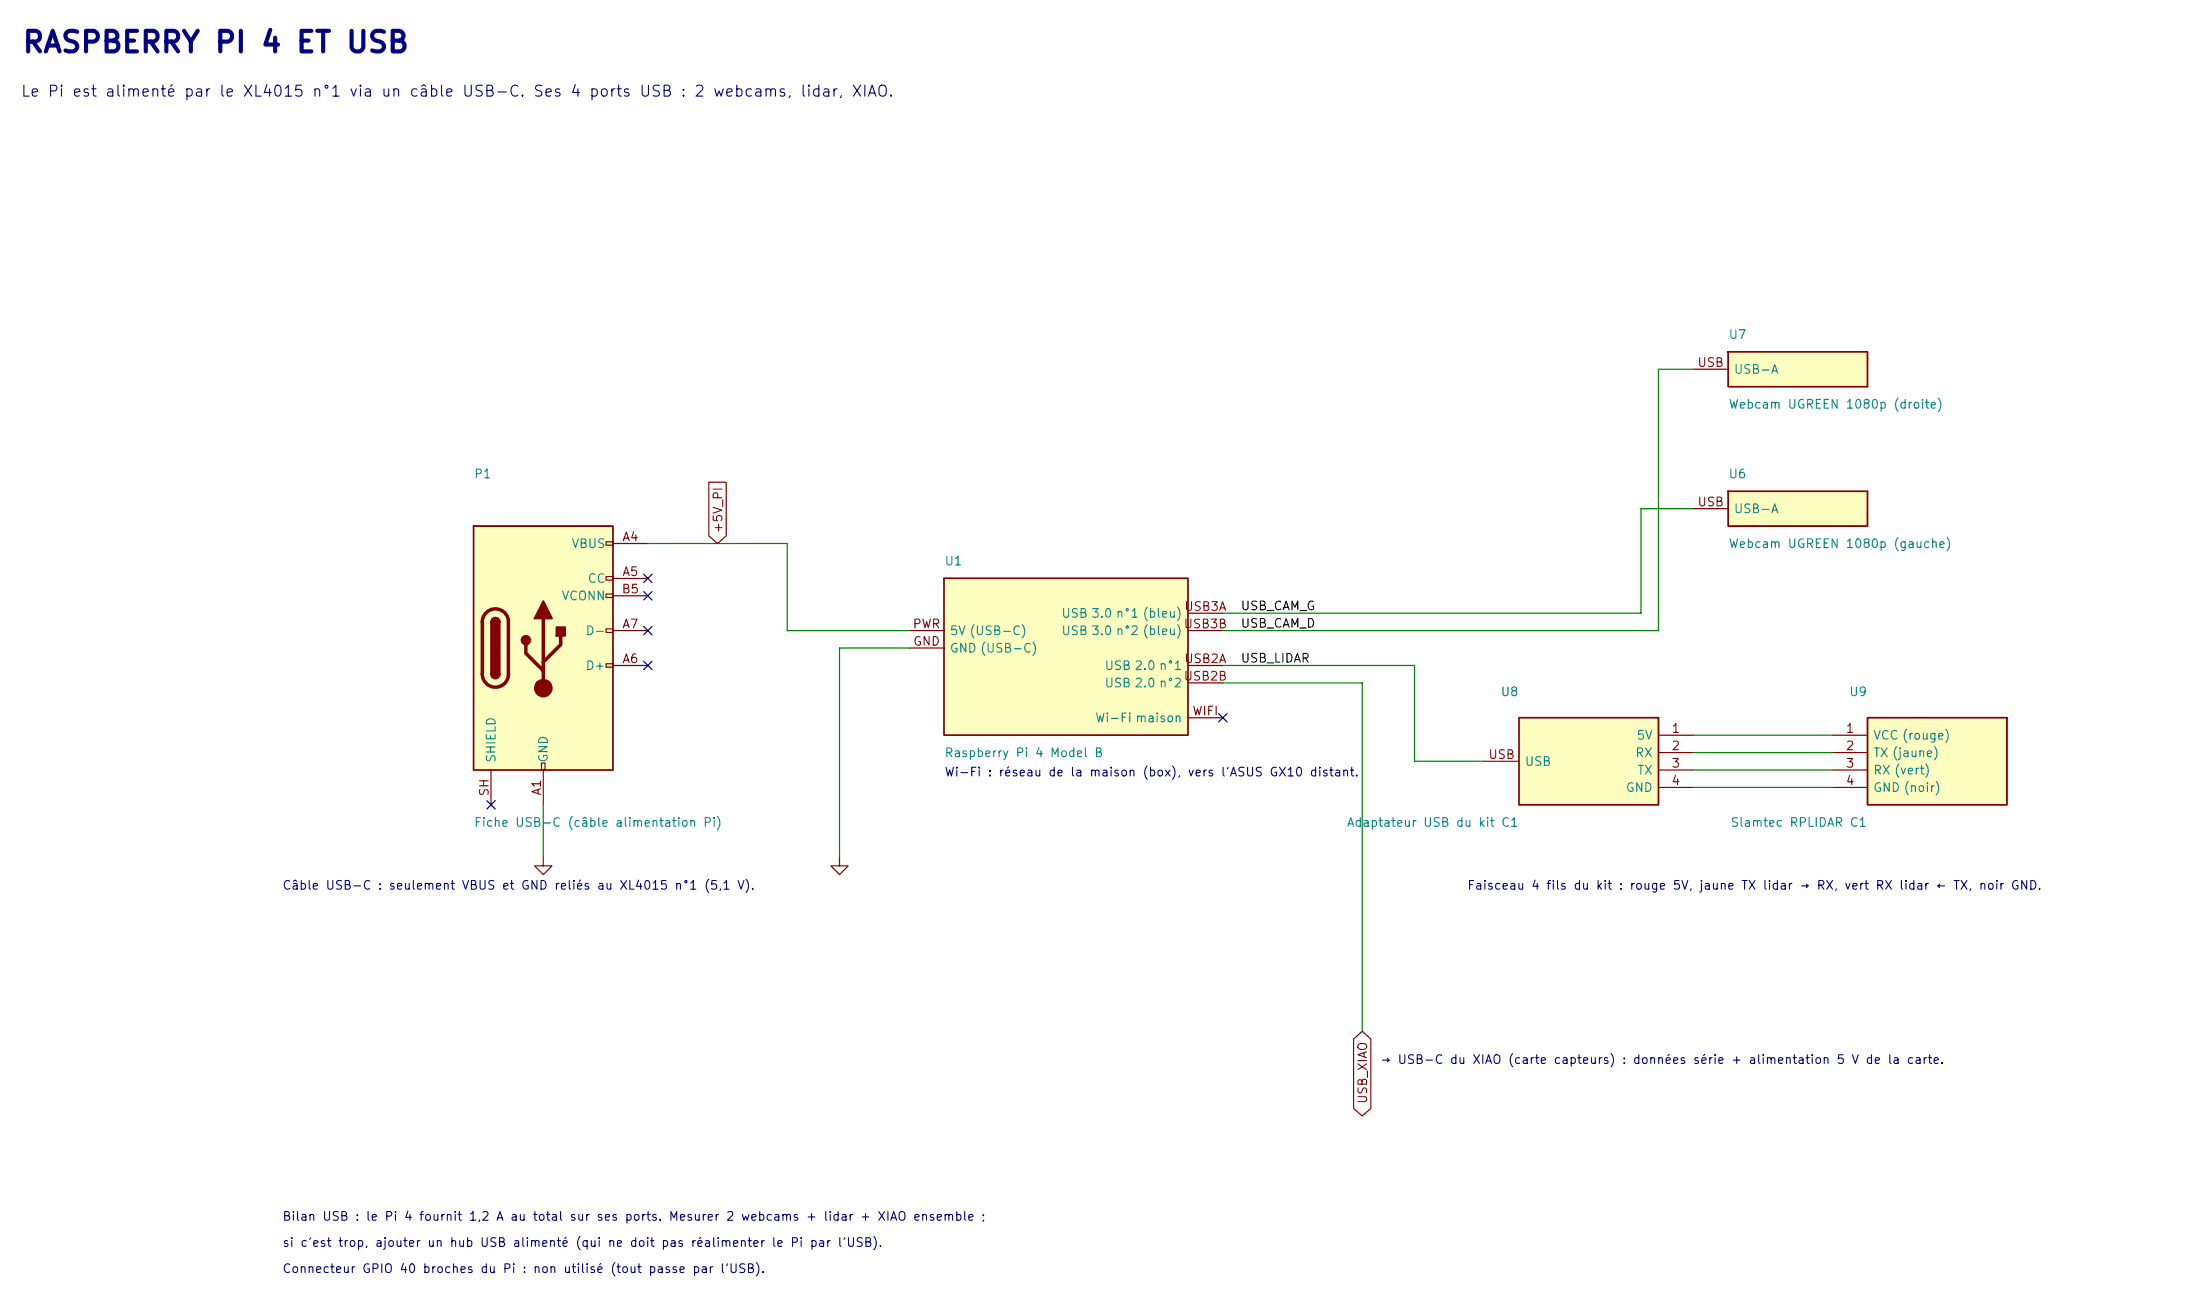
[picture p123: schematic pi_usb.kicad_sch]

Parts:
P1: Fiche USB-C (câble alimentation Pi)
U1: Raspberry Pi 4 Model B
U6: Webcam UGREEN 1080p (gauche)
U7: Webcam UGREEN 1080p (droite)
U8: Adaptateur USB du kit C1
U9: Slamtec RPLIDAR C1

Connections:
+5V_PI: P1.A4 (VBUS), P1.A9 (VBUS), P1.B4 (VBUS), P1.B9 (VBUS), U1.PWR (5V (USB-C))
GND: P1.A1 (GND), P1.A12 (GND), P1.B1 (GND), P1.B12 (GND), U1.GND (GND (USB-C))
unnamed: U8.1 (5V), U9.1 (VCC (rouge))
unnamed: U8.2 (RX), U9.2 (TX (jaune))
unnamed: U8.3 (TX), U9.3 (RX (vert))
unnamed: U8.4 (GND), U9.4 (GND (noir))
USB_CAM_D: U1.USB3B (USB 3.0 n°2 (bleu)), U7.USB
USB_CAM_G: U1.USB3A (USB 3.0 n°1 (bleu)), U6.USB
USB_LIDAR: U1.USB2A (USB 2.0 n°1), U8.USB
USB_XIAO: U1.USB2B (USB 2.0 n°2)

Notes on the sheet:
Bilan USB : le Pi 4 fournit 1,2 A au total sur ses ports. Mesurer 2 webcams + lidar + XIAO ensemble ;
→ USB-C du XIAO (carte capteurs) : données série + alimentation 5 V de la carte.
Wi-Fi : réseau de la maison (box), vers l’ASUS GX10 distant.
Câble USB-C : seulement VBUS et GND reliés au XL4015 n°1 (5,1 V).
Connecteur GPIO 40 broches du Pi : non utilisé (tout passe par l’USB).
Faisceau 4 fils du kit : rouge 5V, jaune TX lidar → RX, vert RX lidar ← TX, noir GND.
Le Pi est alimenté par le XL4015 n°1 via un câble USB-C. Ses 4 ports USB : 2 webcams, lidar, XIAO.
RASPBERRY PI 4 ET USB
si c’est trop, ajouter un hub USB alimenté (qui ne doit pas réalimenter le Pi par l’USB).
