hugoprigent/FieldMind/hardware/electronics/systeme_rover/cad/puissance_arret.kicad_sch

## KiCad design hardware/electronics/systeme_rover/cad/puissance_arret.kicad_sch (2026-10-20)

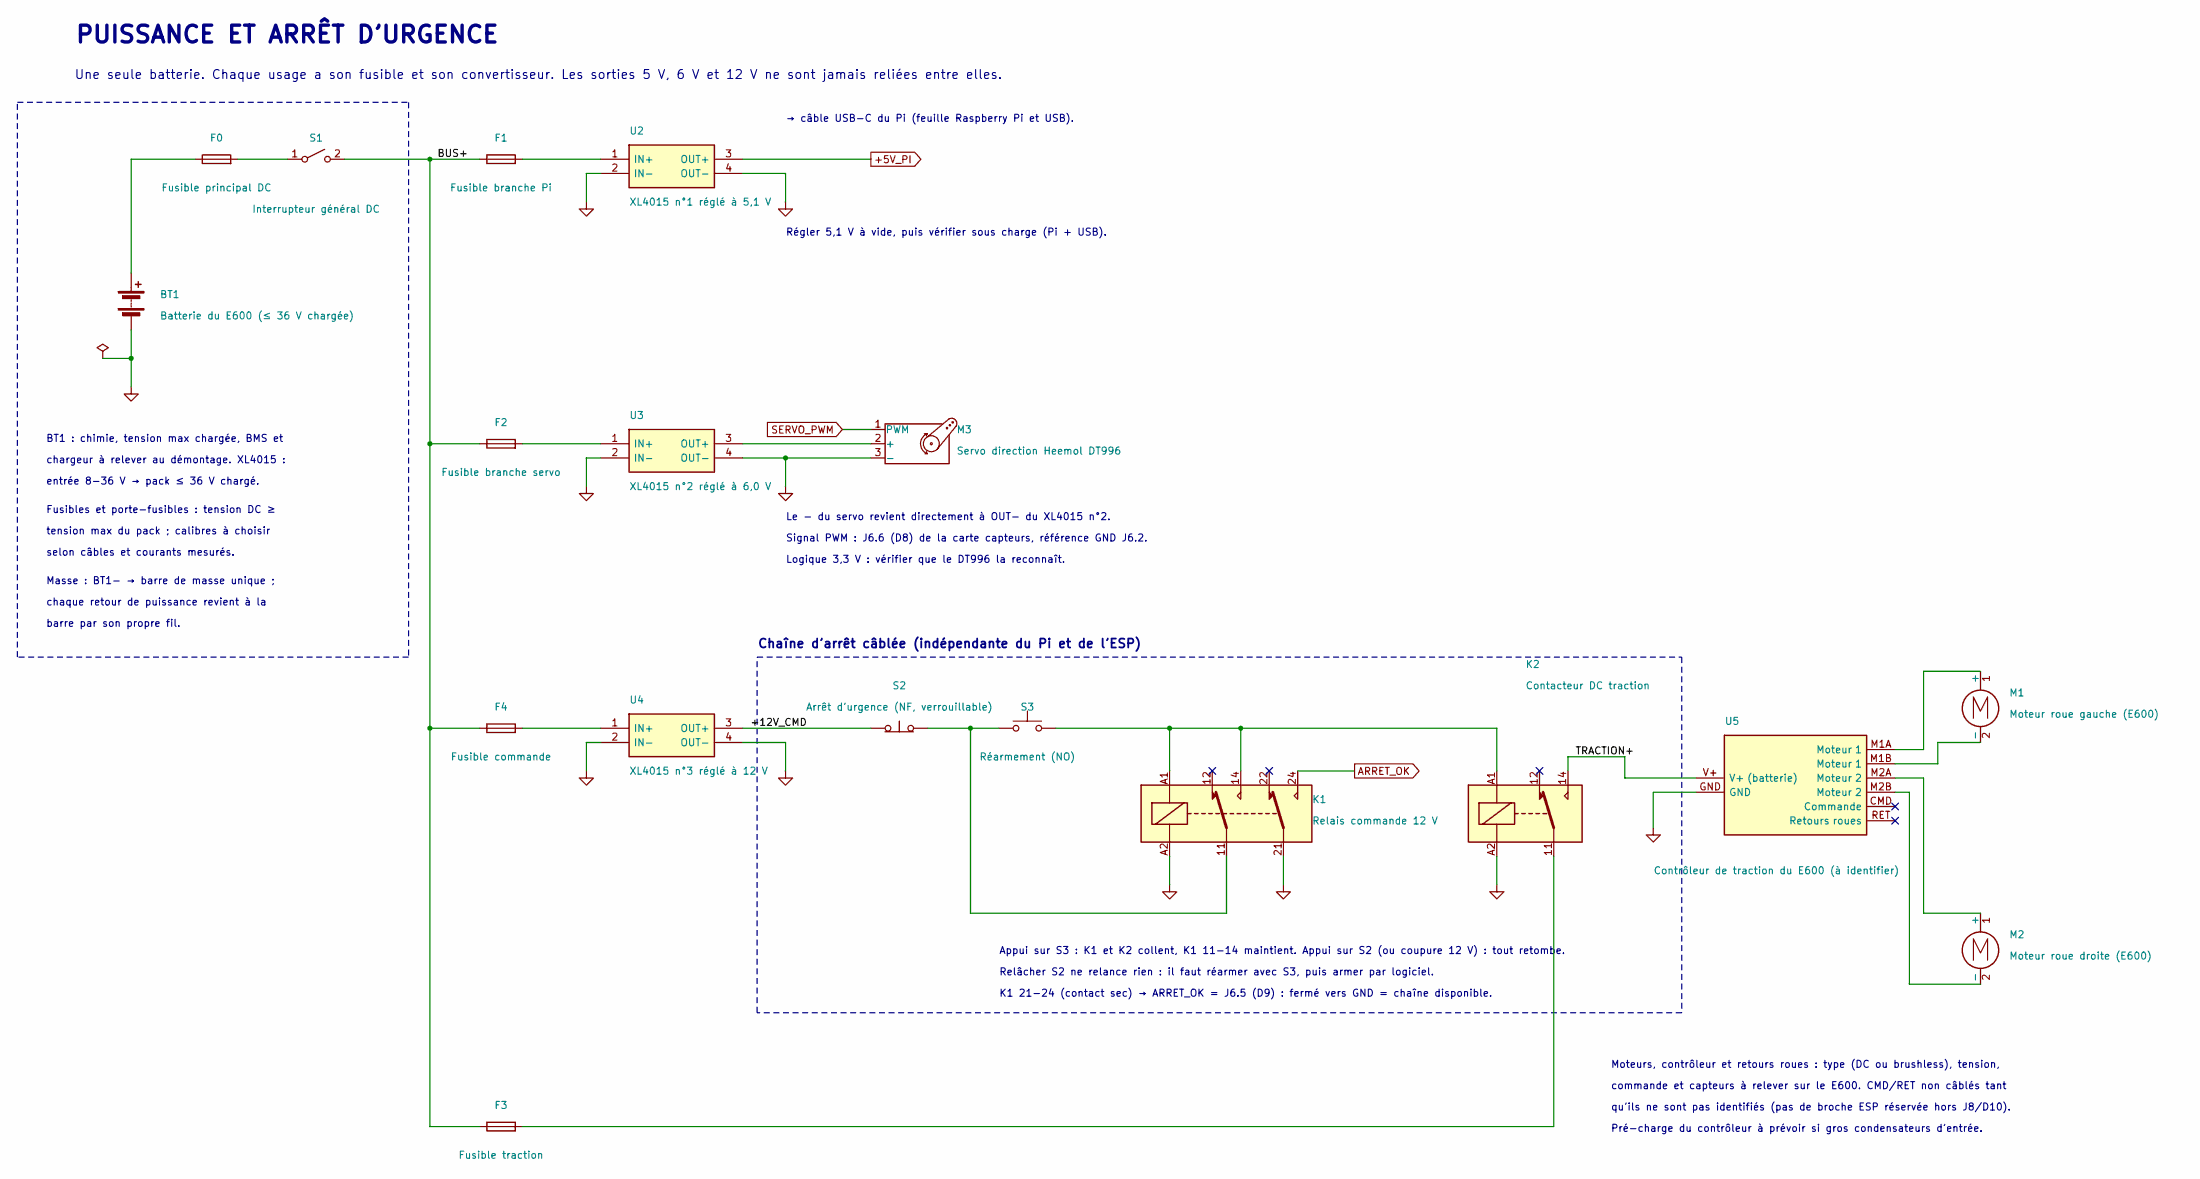
[picture p124: schematic puissance_arret.kicad_sch]

Parts:
BT1: Batterie du E600 (≤ 36 V chargée)
F0: Fusible principal DC
F1: Fusible branche Pi
F2: Fusible branche servo
F3: Fusible traction
F4: Fusible commande
K1: Relais commande 12 V
K2: Contacteur DC traction
M1: Moteur roue gauche (E600)
M2: Moteur roue droite (E600)
M3: Servo direction Heemol DT996
S1: Interrupteur général DC
S2: Arrêt d’urgence (NF, verrouillable)
S3: Réarmement (NO)
U2: XL4015 n°1 réglé à 5,1 V
U3: XL4015 n°2 réglé à 6,0 V
U4: XL4015 n°3 réglé à 12 V
U5: Contrôleur de traction du E600 (à identifier)

Connections:
+5V_PI: U2.3 (OUT+)
+12V_CMD: S2.1 (A), U4.3 (OUT+)
ARRET_OK: K1.24
BUS+: F1.1, F2.1, F3.1, F4.1, S1.2 (B)
GND: BT1.2 (-), K1.21, K1.A2, K2.A2, M3.3 (-), U2.2 (IN-), U2.4 (OUT-), U3.2 (IN-), U3.4 (OUT-), U4.2 (IN-), U4.4 (OUT-), U5.GND
unnamed: BT1.1 (+), F0.1
unnamed: F0.2, S1.1 (A)
unnamed: F1.2, U2.1 (IN+)
unnamed: F2.2, U3.1 (IN+)
unnamed: F3.2, K2.11
unnamed: F4.2, U4.1 (IN+)
unnamed: K1.11, S2.2 (B), S3.1
unnamed: K1.14, K1.A1, K2.A1, S3.2
unnamed: M1.1 (+), U5.M1A (Moteur 1)
unnamed: M1.2 (-), U5.M1B (Moteur 1)
unnamed: M2.1 (+), U5.M2A (Moteur 2)
unnamed: M2.2 (-), U5.M2B (Moteur 2)
unnamed: M3.2 (+), U3.3 (OUT+)
SERVO_PWM: M3.1 (PWM)
TRACTION+: K2.14, U5.V+ (V+ (batterie))

Notes on the sheet:
selon câbles et courants mesurés.
Chaîne d’arrêt câblée (indépendante du Pi et de l’ESP)
Masse : BT1− → barre de masse unique ;
K1 21-24 (contact sec) → ARRET_OK = J6.5 (D9) : fermé vers GND = chaîne disponible.
Pré-charge du contrôleur à prévoir si gros condensateurs d’entrée.
tension max du pack ; calibres à choisir
Régler 5,1 V à vide, puis vérifier sous charge (Pi + USB).
chargeur à relever au démontage. XL4015 :
→ câble USB-C du Pi (feuille Raspberry Pi et USB).
Relâcher S2 ne relance rien : il faut réarmer avec S3, puis armer par logiciel.
entrée 8-36 V → pack ≤ 36 V chargé.
chaque retour de puissance revient à la
barre par son propre fil.
Une seule batterie. Chaque usage a son fusible et son convertisseur. Les sorties 5 V, 6 V et 12 V ne sont jamais reliées entre elles.
Logique 3,3 V : vérifier que le DT996 la reconnaît.
BT1 : chimie, tension max chargée, BMS et
Moteurs, contrôleur et retours roues : type (DC ou brushless), tension,
Fusibles et porte-fusibles : tension DC ≥
qu’ils ne sont pas identifiés (pas de broche ESP réservée hors J8/D10).
Signal PWM : J6.6 (D8) de la carte capteurs, référence GND J6.2.
Le − du servo revient directement à OUT− du XL4015 n°2.
PUISSANCE ET ARRÊT D’URGENCE
Appui sur S3 : K1 et K2 collent, K1 11-14 maintient. Appui sur S2 (ou coupure 12 V) : tout retombe.
commande et capteurs à relever sur le E600. CMD/RET non câblés tant
