hugoprigent/FieldMind/hardware/electronics/carte_capteurs/scripts/plan_c5_a7.py

#!/usr/bin/env python3
"""A7 : une seule perfboard 4 x 6 cm, TOUS les fils sur la face dessous.

A7 = A6 (mêmes liaisons, toutes les broches du XIAO sorties) avec :
  - face dessus (côté écran) : uniquement les cartes et connecteurs sur leurs
    supports, et des ponts de soudure visibles, AUCUN fil ;
  - J4 (GNSS), J6 (extension) et J7 (Knob) passent sur la face dessus, au bord :
    leurs broches se soudent dessous, directement sur les fils ;
  - le XIAO reste dessous sur ses supports : ses broches ne se soudent que
    dessus. Chaque broche reliée y est unie au trou voisin par un PONT DE
    SOUDURE (pas de fil) ; le fil part de ce trou voisin, dessous ;
  - un fil isolé peut croiser un autre fil à angle droit, par-dessus.

Module de données et de contrôle, sans écriture de fichier. Repère : vue DESSUS,
trou (colonne, rangée), colonnes A…N, rangées 1…20. Face F = dessus (écran,
IMU, baromètre, J4, J6, J7), face B = dessous (XIAO et tous les fils).

Orientation physique des cartes : chaque carte est décrite dans sa vue de
référence (côté composants vers soi, barrette en haut ou en bas, ordre de
broches de gauche à droite tel qu'imprimé habituellement). Une carte montée
en face B est vue en miroir depuis le dessus. Les positions des broches sont
CALCULÉES à partir de (broche 1, rotation, face) : on ne peut pas obtenir un
ordre de broches impossible physiquement.

Fils (face dessous) : fil nu étamé posé sur une ligne de trous et soudé à chaque
pastille traversée, ou fil isolé passant entre les pastilles (soudé à ses deux
bouts). Au plus une extrémité de fil par pastille ; jamais deux fils dans le
même trou ; un croisement n'est permis qu'à angle droit, entre deux pastilles,
le fil qui passe dessus étant isolé.
"""
import heapq
import math

COLS, ROWS, PITCH = 14, 20, 2.54
BOARD_W, BOARD_H = 40.0, 60.0
X0 = round((BOARD_W - (COLS - 1) * PITCH) / 2, 3)
Y0 = round((BOARD_H - (ROWS - 1) * PITCH) / 2, 3)
LETTERS = 'ABCDEFGHIJKLMN'
SOCKET_H, MALE_SPACER, MODULE_Z = 8.5, 2.5, 11.0
FACES = ('F', 'B')


def hole_name(node):
    return f'{LETTERS[node[0]]}{node[1] + 1}'


def hxy(node):
    return (round(X0 + PITCH * node[0], 4), round(Y0 + PITCH * node[1], 4))


NC = None
XIAO_NAMES = ['D0', 'D1', 'D2', 'D3', 'D4', 'D5', 'D6', 'D7', 'D8', 'D9', 'D10', '3V3', 'GND', '5V']
XIAO_GPIO = ['GPIO1', 'GPIO0', 'GPIO25', 'GPIO7', 'GPIO23', 'GPIO24', 'GPIO11', 'GPIO12', 'GPIO8', 'GPIO9', 'GPIO10', '', '', '']

# Vue de référence (côté composants, lecture normale). Cotes typiques NON mesurées.
#   header='top'  : barrette au bord haut, corps en dessous ;  'bottom' : l'inverse.
MODULES = {
    'XIAO': dict(L=21.0, W=17.8, t=1.0, src='Seeed XIAO ESP32C5, 21 x 17,8 mm (doc Seeed) ; USB-C en haut'),
    'OLED': dict(L=27.3, D=27.8, e=1.5, t=1.2, header='top',
                 src='OLED 0,96 po I2C : barrette en haut, GND VCC SCL SDA de gauche à droite (variante courante)'),
    'GY521': dict(L=21.2, D=16.4, e=1.5, t=1.6, header='bottom',
                  src='GY-521 : barrette en bas, VCC GND SCL SDA XDA XCL AD0 INT de gauche à droite (courant)'),
    'BMP280': dict(L=15.5, D=11.5, e=1.3, t=1.1, header='bottom',
                   src='GY-BMP280-3.3 : barrette en bas, VCC GND SCL SDA CSB SDO de gauche à droite (courant)'),
}


def rot(x, y, deg):
    a = math.radians(deg)
    return (x * math.cos(a) + y * math.sin(a), -x * math.sin(a) + y * math.cos(a))
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
