hugoprigent/FieldMind/(commit log)

2026-10-20 Publish selected FieldMind prototype, simulation and hardware sources
    [VISSERIE.csv, bague_625_dans_logement_608.stl, barre_stereo.stl, berceau_batterie.stl, biellette.stl, boitier_servo_D.stl, boitier_servo_G.stl, cale_jambe_3mm.stl]
2026-10-20 Align prototype documentation and link verified CI results
2026-10-23 Mise à jour du 23 octobre : logiciel du rover, firmware ROVER_4, CAO remorque et SG90, état réel
    - Logiciel du rover repris du commit source da28316 : exploration progressive
    guidée par le GX10, mémoire spatiale et confirmation visuelle, perception du
    terrain, suivi, simulation publique (fieldmind/public_demo.py) et poste web.
    - Firmware ESP32-C5 ROVER_4 : servos des volets de la remorque.
    - CAO : ferrures avant de la remorque avec empreinte du palonnier, support et
    palonnier SG90 pour la direction, scripts Fusion aux chemins relatifs.
    - README, état au 23 octobre, validation et provenance mis à jour : navigation
    autonome en intérieur du 21/10, remorque fabriquée, drone sans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
    [ferrure_AV_D.stl, ferrure_AV_G.stl, palonnier_sg90.stl, support_sg90.stl]
2026-10-23 Test de sécurité stéréo : obstacle à 0,62 m, hors de la limite flottante de la distance d'arrêt absolu
    Avec l'obstacle à 0,7 m, la distance libre valait 0,2 m à l'arrondi près, soit
    exactement le seuil d'arrêt absolu : arrêt sur macOS, ralenti sous Linux (CI).
2026-10-23 Validation : lien vers le run GitHub Actions vert de l'édition du 23 octobre
2026-10-23 Drone : préciser que le niveau de batterie n'est pas encore lu de façon fiable
2026-10-23 README : photos du prototype réel et captures du poste de pilotage
    Image de tête du rover avec la remorque, section « Le prototype » (couloir,
    planche électronique, carte capteurs) et section « Le poste de pilotage »
    (simulation publique et essai réel du 21 octobre). Images JPEG de moins de 300 ko.
2026-10-23 README : retirer la capture de mission refusée
2026-10-23 Documentation bilingue : versions anglaises du README et des documents principaux
    README.en.md à la racine, versions anglaises de docs/validation, docs/status-2026-10-23,
    docs/publication et docs/architecture, ainsi que des README de software/rover,
    software/esp32/esp_c5, software/rover/deploiement/gx10, software, cao et hardware.
    Chaque paire commence par une ligne de bascule Français · English ; les liens des
    versions anglaises pointent vers les fichiers .en.md quand ils existent.
2026-10-23 ESP32 : le programme par défaut est ROVER_4 (ROVER_3 et servos des volets)
2026-10-23 Traduire toutes les notices FieldMind en anglais et relier les 45 paires FR/EN
